kdp1965/ttsky26c-um-lisa-ttlc/docs/debug_uart.txt

           .rx1.    |\                                        +--------------------------------+
  ui_in[3]--------*-+1|                                       |{pt}      Debug Control         |
           .rx2.  | | |                                  .rx. |  +------+  +---------------+   |  Debug
 uio_in[4]------*-|-+2+---------------------------------------|->|      |  |               |   |   Bus
           .rx3.| | | |                                  .tx. |  |      +--+----- FSM  ----+---|----------> 
 uio_in[6]----*-|-|-+3|                +---------------<------|--+      |  |       |       |   |           
              | | | |/        .1.      |                      |  | UART |  |  {cl} |       |   |
              | | |  |Port  +----------|--+''\__________      |  |      |  +-------+-------+   |
              | | |  | Sel  | .2.      *--+__/ uio_out[4]     |  |      |          |  {pr}     |
              V V V  *------*-----)''\ +--+''\__________      |  |      |  +-------+-------+   | Registers 
       +-------------+-+    | .3. )   +---+__/ uio_out[5]  +--|->| {pb} |  |   Registers   +---|----------> 
       | {pt}          |    +-----)__/                     |  |  +---+--+  +---------------+   |  
       |    ^Debug^    | .Baud Set.                        |  |      +-------------------------|----------> 
       |  ^Autobaud^   +-----------------------------------+  +--------------------------------+  Uart 
       +---------------+                                                                       Passthrough
                        <h4>Figure 846.2: Debug Connectivity and Autobaud</h4>

{:FILE scale 0.8 theme light font-size 10}
