kdp1965/ttsky26c-um-lisa-ttlc/harden/placements/macro-fix_final_seq.txt

# 2337 sequential cells: 2115 flops, 222 latches
# 2327 carry an RTL name on their output net, 10 do not (synthetic net name: cannot be matched across runs)
# 0 RTL names are shared by more than one cell
# cells by master: sky130_fd_sc_hd__dfxtp_1 1784, sky130_fd_sc_hd__dfrtp_1 324, sky130_fd_sc_hd__dlrtp_1 222, sky130_fd_sc_hd__dfxtp_2 4, sky130_fd_sc_hd__dfstp_2 3
# rtl_name  kind  master  x_um  y_um  orient  status  instance
FLAG_F  flop  sky130_fd_sc_hd__dfxtp_1  615.020  356.320  R0  PLACED  _33999_
FLAG_O  flop  sky130_fd_sc_hd__dfxtp_1  583.280  353.600  MX  PLACED  _33998_
RR  flop  sky130_fd_sc_hd__dfxtp_1  600.300  372.640  R0  PLACED  _33988_
addr_16b[0]  flop  sky130_fd_sc_hd__dfxtp_1  429.180  378.080  R0  PLACED  _33017_
addr_16b[1]  flop  sky130_fd_sc_hd__dfxtp_1  418.600  380.800  MX  PLACED  _33018_
baud_ref  flop  sky130_fd_sc_hd__dfxtp_1  110.400  476.000  R0  PLACED  _32908_
brg_div[0]  flop  sky130_fd_sc_hd__dfrtp_1  23.000  503.200  R0  PLACED  _32801_
brg_div[1]  flop  sky130_fd_sc_hd__dfrtp_1  16.100  495.040  MX  PLACED  _32802_
brg_div[2]  flop  sky130_fd_sc_hd__dfrtp_1  28.980  505.920  MX  PLACED  _32803_
brg_div[3]  flop  sky130_fd_sc_hd__dfrtp_1  22.540  497.760  R0  PLACED  _32804_
brg_div[4]  flop  sky130_fd_sc_hd__dfrtp_1  23.000  492.320  R0  PLACED  _32805_
brg_div[5]  flop  sky130_fd_sc_hd__dfrtp_1  32.200  481.440  R0  PLACED  _32806_
brg_div[6]  flop  sky130_fd_sc_hd__dfrtp_1  34.040  484.160  MX  PLACED  _32807_
brg_div[7]  flop  sky130_fd_sc_hd__dfrtp_1  42.780  481.440  R0  PLACED  _32808_
brg_wr  flop  sky130_fd_sc_hd__dfrtp_1  67.160  484.160  MX  PLACED  _32800_
cache_addr[1]  flop  sky130_fd_sc_hd__dfxtp_1  523.480  233.920  MX  PLACED  _32711_
cache_addr[2]  flop  sky130_fd_sc_hd__dfxtp_1  537.280  236.640  R0  PLACED  _32712_
cache_addr[3]  flop  sky130_fd_sc_hd__dfxtp_1  528.540  228.480  MX  PLACED  _32713_
cache_disabled  flop  sky130_fd_sc_hd__dfxtp_1  578.680  326.400  MX  PLACED  _32991_
cache_map_sel[0]  flop  sky130_fd_sc_hd__dfxtp_1  549.240  263.840  R0  PLACED  _32992_
cache_map_sel[1]  flop  sky130_fd_sc_hd__dfxtp_1  544.180  320.960  MX  PLACED  _32993_
ce[0]  flop  sky130_fd_sc_hd__dfxtp_1  534.060  405.280  R0  PLACED  _33934_
ce[1]  flop  sky130_fd_sc_hd__dfxtp_1  535.900  402.560  MX  PLACED  _33935_
clk_div[0]  latch  sky130_fd_sc_hd__dlrtp_1  434.700  369.920  MX  PLACED  i_debug_regs.BASE_BITS\[8\].IO_GEN.io_mux_latch
clk_div[1]  latch  sky130_fd_sc_hd__dlrtp_1  435.160  361.760  R0  PLACED  i_debug_regs.BASE_BITS\[9\].IO_GEN.io_mux_latch
core_inst_o[0]  flop  sky130_fd_sc_hd__dfrtp_1  379.960  367.200  R0  PLACED  _32892_
core_inst_o[10]  flop  sky130_fd_sc_hd__dfrtp_1  415.840  291.040  R0  PLACED  _32902_
core_inst_o[11]  flop  sky130_fd_sc_hd__dfrtp_1  405.720  299.200  MX  PLACED  _32903_
core_inst_o[12]  flop  sky130_fd_sc_hd__dfrtp_1  389.620  304.640  MX  PLACED  _32904_
core_inst_o[13]  flop  sky130_fd_sc_hd__dfrtp_1  444.360  291.040  R0  PLACED  _32905_
core_inst_o[14]  flop  sky130_fd_sc_hd__dfrtp_1  426.880  293.760  MX  PLACED  _32906_
core_inst_o[15]  flop  sky130_fd_sc_hd__dfrtp_1  415.840  299.200  MX  PLACED  _32907_
core_inst_o[1]  flop  sky130_fd_sc_hd__dfrtp_1  391.460  364.480  MX  PLACED  _32893_
core_inst_o[2]  flop  sky130_fd_sc_hd__dfrtp_1  396.520  369.920  MX  PLACED  _32894_
core_inst_o[3]  flop  sky130_fd_sc_hd__dfrtp_1  382.260  372.640  R0  PLACED  _32895_
core_inst_o[4]  flop  sky130_fd_sc_hd__dfrtp_1  437.000  296.480  R0  PLACED  _32896_
core_inst_o[5]  flop  sky130_fd_sc_hd__dfrtp_1  400.200  348.160  MX  PLACED  _32897_
core_inst_o[6]  flop  sky130_fd_sc_hd__dfrtp_1  391.920  293.760  MX  PLACED  _32898_
core_inst_o[7]  flop  sky130_fd_sc_hd__dfrtp_1  446.200  288.320  MX  PLACED  _32899_
core_inst_o[8]  flop  sky130_fd_sc_hd__dfrtp_1  395.140  299.200  MX  PLACED  _32900_
core_inst_o[9]  flop  sky130_fd_sc_hd__dfrtp_1  425.960  299.200  MX  PLACED  _32901_
d_addr[0]  flop  sky130_fd_sc_hd__dfxtp_1  343.160  217.600  MX  PLACED  _34349_
d_addr[10]  flop  sky130_fd_sc_hd__dfxtp_1  515.660  231.200  R0  PLACED  _34359_
d_addr[11]  flop  sky130_fd_sc_hd__dfxtp_1  511.060  242.080  R0  PLACED  _34360_
d_addr[12]  flop  sky130_fd_sc_hd__dfxtp_1  506.460  236.640  R0  PLACED  _34361_
d_addr[13]  flop  sky130_fd_sc_hd__dfxtp_1  389.620  255.680  MX  PLACED  _34362_
d_addr[14]  flop  sky130_fd_sc_hd__dfxtp_1  360.640  258.400  R0  PLACED  _34363_
d_addr[1]  flop  sky130_fd_sc_hd__dfxtp_1  353.280  217.600  MX  PLACED  _34350_
d_addr[2]  flop  sky130_fd_sc_hd__dfxtp_1  358.800  220.320  R0  PLACED  _34351_
d_addr[3]  flop  sky130_fd_sc_hd__dfxtp_1  352.360  228.480  MX  PLACED  _34352_
d_addr[4]  flop  sky130_fd_sc_hd__dfxtp_2  350.980  225.760  R0  PLACED  _34353_
d_addr[5]  flop  sky130_fd_sc_hd__dfxtp_1  366.620  225.760  R0  PLACED  _34354_
d_addr[6]  flop  sky130_fd_sc_hd__dfxtp_2  368.460  231.200  R0  PLACED  _34355_
d_addr[7]  flop  sky130_fd_sc_hd__dfxtp_1  609.040  209.440  R0  PLACED  _34356_
d_addr[8]  flop  sky130_fd_sc_hd__dfxtp_1  521.180  228.480  MX  PLACED  _34357_
d_addr[9]  flop  sky130_fd_sc_hd__dfxtp_1  542.340  204.000  R0  PLACED  _34358_
d_o[0]  flop  sky130_fd_sc_hd__dfxtp_1  288.880  367.200  R0  PLACED  _34341_
d_o[1]  flop  sky130_fd_sc_hd__dfxtp_1  286.580  380.800  MX  PLACED  _34342_
d_o[2]  flop  sky130_fd_sc_hd__dfxtp_1  224.940  408.000  MX  PLACED  _34343_
d_o[3]  flop  sky130_fd_sc_hd__dfxtp_2  287.500  361.760  R0  PLACED  _34344_
d_o[4]  flop  sky130_fd_sc_hd__dfxtp_1  213.440  410.720  R0  PLACED  _34345_
d_o[5]  flop  sky130_fd_sc_hd__dfxtp_1  217.580  380.800  MX  PLACED  _34346_
d_o[6]  flop  sky130_fd_sc_hd__dfxtp_1  244.260  408.000  MX  PLACED  _34347_
d_o[7]  flop  sky130_fd_sc_hd__dfxtp_1  260.820  408.000  MX  PLACED  _34348_
d_periph  flop  sky130_fd_sc_hd__dfxtp_1  358.800  269.280  R0  PLACED  _34367_
d_rd  flop  sky130_fd_sc_hd__dfxtp_1  353.740  372.640  R0  PLACED  _34366_
d_valid  flop  sky130_fd_sc_hd__dfxtp_1  543.720  209.440  R0  PLACED  _34364_
d_we  flop  sky130_fd_sc_hd__dfxtp_1  408.480  274.720  R0  PLACED  _34365_
data_cache_flush  flop  sky130_fd_sc_hd__dfxtp_1  552.460  277.440  MX  PLACED  _32994_
data_cache_invalidate  flop  sky130_fd_sc_hd__dfxtp_1  558.440  272.000  MX  PLACED  _32995_
dbg_a[0]  flop  sky130_fd_sc_hd__dfrtp_1  402.500  312.800  R0  PLACED  _32884_
dbg_a[1]  flop  sky130_fd_sc_hd__dfrtp_1  383.180  312.800  R0  PLACED  _32885_
dbg_a[2]  flop  sky130_fd_sc_hd__dfrtp_1  390.080  315.520  MX  PLACED  _32886_
dbg_a[3]  flop  sky130_fd_sc_hd__dfrtp_1  396.060  342.720  MX  PLACED  _32887_
dbg_a[4]  flop  sky130_fd_sc_hd__dfrtp_1  399.740  326.400  MX  PLACED  _32888_
dbg_a[5]  flop  sky130_fd_sc_hd__dfrtp_1  389.620  320.960  MX  PLACED  _32889_
dbg_a[6]  flop  sky130_fd_sc_hd__dfrtp_1  396.980  337.280  MX  PLACED  _32890_
dbg_a[7]  flop  sky130_fd_sc_hd__dfrtp_1  389.160  329.120  R0  PLACED  _32891_
dbg_halted  flop  sky130_fd_sc_hd__dfxtp_1  391.000  285.600  R0  PLACED  _33301_
dbg_rd  flop  sky130_fd_sc_hd__dfrtp_1  398.360  386.240  MX  PLACED  _32867_
dbg_reset  flop  sky130_fd_sc_hd__dfrtp_1  370.300  369.920  MX  PLACED  _32868_
dbg_we  flop  sky130_fd_sc_hd__dfrtp_1  403.420  380.800  MX  PLACED  _32866_
debug_addr[0]  flop  sky130_fd_sc_hd__dfxtp_1  447.120  320.960  MX  PLACED  _32661_
debug_addr[10]  flop  sky130_fd_sc_hd__dfxtp_1  557.060  312.800  R0  PLACED  _32655_
debug_addr[11]  flop  sky130_fd_sc_hd__dfxtp_1  543.720  318.240  R0  PLACED  _32656_
debug_addr[12]  flop  sky130_fd_sc_hd__dfxtp_1  501.400  310.080  MX  PLACED  _32657_
debug_addr[13]  flop  sky130_fd_sc_hd__dfxtp_1  489.900  301.920  R0  PLACED  _32658_
debug_addr[14]  flop  sky130_fd_sc_hd__dfxtp_1  477.480  304.640  MX  PLACED  _32659_
debug_addr[15]  flop  sky130_fd_sc_hd__dfxtp_1  462.760  307.360  R0  PLACED  _32660_
debug_addr[16]  flop  sky130_fd_sc_hd__dfxtp_1  460.460  312.800  R0  PLACED  _32997_
debug_addr[17]  flop  sky130_fd_sc_hd__dfxtp_1  471.040  320.960  MX  PLACED  _32998_
debug_addr[18]  flop  sky130_fd_sc_hd__dfxtp_1  493.120  315.520  MX  PLACED  _32999_
debug_addr[19]  flop  sky130_fd_sc_hd__dfxtp_1  509.220  304.640  MX  PLACED  _33000_
debug_addr[1]  flop  sky130_fd_sc_hd__dfxtp_1  478.860  288.320  MX  PLACED  _32646_
debug_addr[20]  flop  sky130_fd_sc_hd__dfxtp_1  509.680  310.080  MX  PLACED  _33001_
debug_addr[21]  flop  sky130_fd_sc_hd__dfxtp_1  534.520  318.240  R0  PLACED  _33002_
debug_addr[22]  flop  sky130_fd_sc_hd__dfxtp_1  522.560  312.800  R0  PLACED  _33003_
debug_addr[23]  flop  sky130_fd_sc_hd__dfxtp_1  515.200  301.920  R0  PLACED  _33004_
debug_addr[2]  flop  sky130_fd_sc_hd__dfxtp_1  484.840  299.200  MX  PLACED  _32647_
debug_addr[3]  flop  sky130_fd_sc_hd__dfxtp_1  507.380  296.480  R0  PLACED  _32648_
debug_addr[4]  flop  sky130_fd_sc_hd__dfxtp_1  518.880  299.200  MX  PLACED  _32649_
debug_addr[5]  flop  sky130_fd_sc_hd__dfxtp_1  519.340  291.040  R0  PLACED  _32650_
debug_addr[6]  flop  sky130_fd_sc_hd__dfxtp_1  542.800  280.160  R0  PLACED  _32651_
debug_addr[7]  flop  sky130_fd_sc_hd__dfxtp_1  532.680  291.040  R0  PLACED  _32652_
debug_addr[8]  flop  sky130_fd_sc_hd__dfxtp_1  528.540  293.760  MX  PLACED  _32653_
debug_addr[9]  flop  sky130_fd_sc_hd__dfxtp_1  560.280  307.360  R0  PLACED  _32654_
debug_ce_ctrl[0]  flop  sky130_fd_sc_hd__dfxtp_1  436.080  350.880  R0  PLACED  _33005_
debug_ce_ctrl[1]  flop  sky130_fd_sc_hd__dfxtp_1  435.160  345.440  R0  PLACED  _33006_
debug_tx  flop  sky130_fd_sc_hd__dfxtp_1  166.520  429.760  MX  PLACED  _32961_
dummy_read_cycles[0]  flop  sky130_fd_sc_hd__dfxtp_1  458.620  391.680  MX  PLACED  _33023_
dummy_read_cycles[1]  flop  sky130_fd_sc_hd__dfxtp_1  460.920  383.520  R0  PLACED  _33024_
dummy_read_cycles[2]  flop  sky130_fd_sc_hd__dfxtp_1  534.980  367.200  R0  PLACED  _33025_
dummy_read_cycles[3]  flop  sky130_fd_sc_hd__dfxtp_1  456.320  380.800  MX  PLACED  _33026_
dummy_read_cycles[4]  flop  sky130_fd_sc_hd__dfxtp_1  449.420  386.240  MX  PLACED  _33027_
dummy_read_cycles[5]  flop  sky130_fd_sc_hd__dfxtp_1  467.820  380.800  MX  PLACED  _33028_
dummy_read_cycles[6]  flop  sky130_fd_sc_hd__dfxtp_1  519.800  367.200  R0  PLACED  _33029_
dummy_read_cycles[7]  flop  sky130_fd_sc_hd__dfxtp_1  458.160  375.360  MX  PLACED  _33030_
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
i_data_cache.cl_valid[3]  flop  sky130_fd_sc_hd__dfxtp_1  629.280  190.400  MX  PLACED  _32754_
i_data_cache.cl_valid[4]  flop  sky130_fd_sc_hd__dfxtp_1  626.520  171.360  R0  PLACED  _32753_
i_data_cache.cl_valid[5]  flop  sky130_fd_sc_hd__dfxtp_1  598.920  176.800  R0  PLACED  _32752_
i_data_cache.cl_valid[6]  flop  sky130_fd_sc_hd__dfxtp_1  626.060  163.200  MX  PLACED  _32751_
i_data_cache.cl_valid[7]  flop  sky130_fd_sc_hd__dfxtp_1  568.560  165.920  R0  PLACED  _32750_
i_data_cache.flush_active  flop  sky130_fd_sc_hd__dfxtp_1  574.540  220.320  R0  PLACED  _32714_
i_data_cache.flush_cache_line[0]  flop  sky130_fd_sc_hd__dfxtp_1  579.600  212.160  MX  PLACED  _32715_
i_data_cache.flush_cache_line[1]  flop  sky130_fd_sc_hd__dfxtp_1  582.820  209.440  R0  PLACED  _32716_
i_data_cache.flush_cache_line[2]  flop  sky130_fd_sc_hd__dfxtp_1  564.420  209.440  R0  PLACED  _32717_
i_data_cache.load_active  flop  sky130_fd_sc_hd__dfxtp_1  547.400  223.040  MX  PLACED  _32710_
i_data_cache.qspi_ready_ack  flop  sky130_fd_sc_hd__dfxtp_1  549.240  236.640  R0  PLACED  _34429_
i_data_cache.rst_n  flop  sky130_fd_sc_hd__dfrtp_1  644.920  503.200  R0  PLACED  _34437_
i_data_cache.save_active  flop  sky130_fd_sc_hd__dfxtp_1  536.360  225.760  R0  PLACED  _32709_
i_data_cache.state[0]  flop  sky130_fd_sc_hd__dfxtp_1  552.460  212.160  MX  PLACED  _34421_
i_data_cache.state[1]  flop  sky130_fd_sc_hd__dfxtp_1  551.080  217.600  MX  PLACED  _34422_
i_data_cache.state[2]  flop  sky130_fd_sc_hd__dfxtp_1  572.700  225.760  R0  PLACED  _34423_
i_data_cache.state[3]  flop  sky130_fd_sc_hd__dfxtp_1  570.400  233.920  MX  PLACED  _34424_
i_data_cache.state[4]  flop  sky130_fd_sc_hd__dfxtp_1  557.520  236.640  R0  PLACED  _34425_
i_data_cache.state[5]  flop  sky130_fd_sc_hd__dfxtp_1  565.340  225.760  R0  PLACED  _34426_
i_data_cache.state[6]  flop  sky130_fd_sc_hd__dfxtp_1  567.180  220.320  R0  PLACED  _34427_
i_data_cache.state[7]  flop  sky130_fd_sc_hd__dfxtp_1  559.820  231.200  R0  PLACED  _34428_
i_data_cache.state[9]  flop  sky130_fd_sc_hd__dfxtp_1  544.640  212.160  MX  PLACED  _34430_
i_debug_autobaud.rx1  flop  sky130_fd_sc_hd__dfrtp_1  87.400  462.400  MX  PLACED  _34432_
i_debug_autobaud.rx2  flop  sky130_fd_sc_hd__dfrtp_1  101.200  476.000  R0  PLACED  _34434_
i_debug_autobaud.rx3  flop  sky130_fd_sc_hd__dfrtp_1  107.180  470.560  R0  PLACED  _34436_
i_debug_autobaud.rx_sel[0]  flop  sky130_fd_sc_hd__dfrtp_1  91.080  467.840  MX  PLACED  _32798_
i_debug_autobaud.rx_sel[1]  flop  sky130_fd_sc_hd__dfrtp_1  97.520  465.120  R0  PLACED  _32799_
i_debug_autobaud.s_bit_div2[0]  flop  sky130_fd_sc_hd__dfrtp_1  32.200  500.480  MX  PLACED  _32809_
i_debug_autobaud.s_bit_div2[1]  flop  sky130_fd_sc_hd__dfrtp_1  30.820  489.600  MX  PLACED  _32810_
i_debug_autobaud.s_bit_div2[2]  flop  sky130_fd_sc_hd__dfrtp_1  53.820  503.200  R0  PLACED  _32811_
i_debug_autobaud.s_bit_div2[3]  flop  sky130_fd_sc_hd__dfrtp_1  54.280  497.760  R0  PLACED  _32812_
i_debug_autobaud.s_bit_div2[4]  flop  sky130_fd_sc_hd__dfrtp_1  57.960  492.320  R0  PLACED  _32813_
i_debug_autobaud.s_bit_div2[5]  flop  sky130_fd_sc_hd__dfrtp_1  51.980  481.440  R0  PLACED  _32814_
i_debug_autobaud.s_bit_div2[6]  flop  sky130_fd_sc_hd__dfrtp_1  43.700  486.880  R0  PLACED  _32815_
i_debug_autobaud.s_bit_div2[7]  flop  sky130_fd_sc_hd__dfrtp_1  44.160  500.480  MX  PLACED  _32816_
i_debug_autobaud.s_bit_div3[0]  flop  sky130_fd_sc_hd__dfrtp_1  32.200  503.200  R0  PLACED  _32817_
i_debug_autobaud.s_bit_div3[1]  flop  sky130_fd_sc_hd__dfrtp_1  32.200  492.320  R0  PLACED  _32818_
i_debug_autobaud.s_bit_div3[2]  flop  sky130_fd_sc_hd__dfrtp_1  67.620  503.200  R0  PLACED  _32819_
i_debug_autobaud.s_bit_div3[3]  flop  sky130_fd_sc_hd__dfrtp_1  60.720  500.480  MX  PLACED  _32820_
i_debug_autobaud.s_bit_div3[4]  flop  sky130_fd_sc_hd__dfrtp_1  63.940  489.600  MX  PLACED  _32821_
i_debug_autobaud.s_bit_div3[5]  flop  sky130_fd_sc_hd__dfrtp_1  57.040  484.160  MX  PLACED  _32822_
i_debug_autobaud.s_bit_div3[6]  flop  sky130_fd_sc_hd__dfrtp_1  41.860  492.320  R0  PLACED  _32823_
i_debug_autobaud.s_bit_div3[7]  flop  sky130_fd_sc_hd__dfrtp_1  43.700  503.200  R0  PLACED  _32824_
i_debug_autobaud.s_div_found  flop  sky130_fd_sc_hd__dfrtp_1  73.600  481.440  R0  PLACED  _34544_
i_debug_autobaud.s_done  flop  sky130_fd_sc_hd__dfrtp_1  63.940  473.280  MX  PLACED  _32830_
i_debug_autobaud.s_last_rx1  flop  sky130_fd_sc_hd__dfrtp_1  76.820  465.120  R0  PLACED  _32825_
i_debug_autobaud.s_last_rx2  flop  sky130_fd_sc_hd__dfrtp_1  67.620  465.120  R0  PLACED  _32826_
i_debug_autobaud.s_last_rx3  flop  sky130_fd_sc_hd__dfrtp_1  60.720  467.840  MX  PLACED  _32827_
i_debug_autobaud.s_pulse_width[0]  flop  sky130_fd_sc_hd__dfrtp_1  4.140  470.560  R0  PLACED  _32627_
i_debug_autobaud.s_pulse_width[10]  flop  sky130_fd_sc_hd__dfrtp_1  25.760  486.880  R0  PLACED  _32637_
i_debug_autobaud.s_pulse_width[11]  flop  sky130_fd_sc_hd__dfrtp_1  25.300  476.000  R0  PLACED  _32638_
i_debug_autobaud.s_pulse_width[12]  flop  sky130_fd_sc_hd__dfrtp_1  38.180  478.720  MX  PLACED  _32639_
i_debug_autobaud.s_pulse_width[13]  flop  sky130_fd_sc_hd__dfrtp_1  50.140  476.000  R0  PLACED  _32640_
i_debug_autobaud.s_pulse_width[1]  flop  sky130_fd_sc_hd__dfrtp_1  4.600  476.000  R0  PLACED  _32628_
i_debug_autobaud.s_pulse_width[2]  flop  sky130_fd_sc_hd__dfrtp_1  16.100  476.000  R0  PLACED  _32629_
i_debug_autobaud.s_pulse_width[3]  flop  sky130_fd_sc_hd__dfrtp_1  15.180  484.160  MX  PLACED  _32630_
i_debug_autobaud.s_pulse_width[4]  flop  sky130_fd_sc_hd__dfrtp_1  4.140  484.160  MX  PLACED  _32631_
i_debug_autobaud.s_pulse_width[5]  flop  sky130_fd_sc_hd__dfrtp_1  6.440  500.480  MX  PLACED  _32632_
i_debug_autobaud.s_pulse_width[6]  flop  sky130_fd_sc_hd__dfrtp_1  6.440  497.760  R0  PLACED  _32633_
i_debug_autobaud.s_pulse_width[7]  flop  sky130_fd_sc_hd__dfrtp_1  17.480  500.480  MX  PLACED  _32634_
i_debug_autobaud.s_pulse_width[8]  flop  sky130_fd_sc_hd__dfrtp_1  4.140  492.320  R0  PLACED  _32635_
i_debug_autobaud.s_pulse_width[9]  flop  sky130_fd_sc_hd__dfrtp_1  15.180  489.600  MX  PLACED  _32636_
i_debug_autobaud.s_rx_sel[0]  flop  sky130_fd_sc_hd__dfrtp_1  83.720  470.560  R0  PLACED  _32828_
i_debug_autobaud.s_rx_sel[1]  flop  sky130_fd_sc_hd__dfrtp_1  86.940  473.280  MX  PLACED  _32829_
i_debug_ctrl.i_debug_brg.s_baud_cnt[0]  flop  sky130_fd_sc_hd__dfxtp_1  93.380  503.200  R0  PLACED  _32909_
i_debug_ctrl.i_debug_brg.s_baud_cnt[1]  flop  sky130_fd_sc_hd__dfxtp_1  108.100  503.200  R0  PLACED  _32910_
i_debug_ctrl.i_debug_brg.s_baud_cnt[2]  flop  sky130_fd_sc_hd__dfxtp_1  100.740  503.200  R0  PLACED  _32911_
i_debug_ctrl.i_debug_brg.s_baud_cnt[3]  flop  sky130_fd_sc_hd__dfxtp_1  103.040  492.320  R0  PLACED  _32912_
i_debug_ctrl.i_debug_brg.s_baud_cnt[4]  flop  sky130_fd_sc_hd__dfxtp_1  107.180  489.600  MX  PLACED  _32913_
i_debug_ctrl.i_debug_brg.s_baud_cnt[5]  flop  sky130_fd_sc_hd__dfxtp_1  100.740  486.880  R0  PLACED  _32914_
i_debug_ctrl.i_debug_brg.s_baud_cnt[6]  flop  sky130_fd_sc_hd__dfxtp_1  108.560  481.440  R0  PLACED  _32915_
i_debug_ctrl.i_debug_brg.s_baud_cnt[7]  flop  sky130_fd_sc_hd__dfxtp_1  97.980  481.440  R0  PLACED  _32916_
i_debug_ctrl.i_debug_brg.s_baud_preload[0]  flop  sky130_fd_sc_hd__dfxtp_1  85.560  503.200  R0  PLACED  _32917_
i_debug_ctrl.i_debug_brg.s_baud_preload[1]  flop  sky130_fd_sc_hd__dfxtp_1  93.380  497.760  R0  PLACED  _32918_
i_debug_ctrl.i_debug_brg.s_baud_preload[2]  flop  sky130_fd_sc_hd__dfxtp_1  78.200  503.200  R0  PLACED  _32919_
i_debug_ctrl.i_debug_brg.s_baud_preload[3]  flop  sky130_fd_sc_hd__dfxtp_1  81.420  495.040  MX  PLACED  _32920_
i_debug_ctrl.i_debug_brg.s_baud_preload[4]  flop  sky130_fd_sc_hd__dfxtp_1  93.840  492.320  R0  PLACED  _32921_
i_debug_ctrl.i_debug_brg.s_baud_preload[5]  flop  sky130_fd_sc_hd__dfxtp_1  86.020  484.160  MX  PLACED  _32922_
i_debug_ctrl.i_debug_brg.s_baud_preload[6]  flop  sky130_fd_sc_hd__dfxtp_1  93.380  484.160  MX  PLACED  _32923_
i_debug_ctrl.i_debug_brg.s_baud_preload[7]  flop  sky130_fd_sc_hd__dfxtp_1  82.340  478.720  MX  PLACED  _32924_
i_debug_ctrl.i_debug_brg.s_wr_edge  flop  sky130_fd_sc_hd__dfxtp_1  74.520  486.880  R0  PLACED  _32925_
i_debug_ctrl.i_lisa_rx8n.bit_count[0]  flop  sky130_fd_sc_hd__dfxtp_1  11.960  467.840  MX  PLACED  _32927_
i_debug_ctrl.i_lisa_rx8n.bit_count[1]  flop  sky130_fd_sc_hd__dfxtp_1  20.700  473.280  MX  PLACED  _32928_
i_debug_ctrl.i_lisa_rx8n.bit_count[2]  flop  sky130_fd_sc_hd__dfxtp_1  30.360  470.560  R0  PLACED  _32929_
i_debug_ctrl.i_lisa_rx8n.bit_count[3]  flop  sky130_fd_sc_hd__dfxtp_1  52.440  470.560  R0  PLACED  _32930_
i_debug_ctrl.i_lisa_rx8n.bit_count[4]  flop  sky130_fd_sc_hd__dfxtp_1  43.240  473.280  MX  PLACED  _32931_
i_debug_ctrl.i_lisa_rx8n.bit_count[5]  flop  sky130_fd_sc_hd__dfxtp_1  28.980  462.400  MX  PLACED  _32932_
i_debug_ctrl.i_lisa_rx8n.bit_count[6]  flop  sky130_fd_sc_hd__dfxtp_1  19.780  465.120  R0  PLACED  _32933_
i_debug_ctrl.i_lisa_rx8n.bit_count[7]  flop  sky130_fd_sc_hd__dfxtp_1  37.260  462.400  MX  PLACED  _32934_
i_debug_ctrl.i_lisa_rx8n.fifo[0][0]  flop  sky130_fd_sc_hd__dfxtp_1  41.860  416.160  R0  PLACED  _32476_
i_debug_ctrl.i_lisa_rx8n.fifo[0][1]  flop  sky130_fd_sc_hd__dfxtp_1  16.560  410.720  R0  PLACED  _32477_
i_debug_ctrl.i_lisa_rx8n.fifo[0][2]  flop  sky130_fd_sc_hd__dfxtp_1  16.560  421.600  R0  PLACED  _32478_
i_debug_ctrl.i_lisa_rx8n.fifo[0][3]  flop  sky130_fd_sc_hd__dfxtp_1  18.400  443.360  R0  PLACED  _32479_
i_debug_ctrl.i_lisa_rx8n.fifo[0][4]  flop  sky130_fd_sc_hd__dfxtp_1  46.000  421.600  R0  PLACED  _32480_
i_debug_ctrl.i_lisa_rx8n.fifo[0][5]  flop  sky130_fd_sc_hd__dfxtp_1  43.700  446.080  MX  PLACED  _32481_
i_debug_ctrl.i_lisa_rx8n.fifo[0][6]  flop  sky130_fd_sc_hd__dfxtp_1  54.740  440.640  MX  PLACED  _32482_
i_debug_ctrl.i_lisa_rx8n.fifo[0][7]  flop  sky130_fd_sc_hd__dfxtp_1  69.000  446.080  MX  PLACED  _32483_
i_debug_ctrl.i_lisa_rx8n.fifo[1][0]  flop  sky130_fd_sc_hd__dfxtp_1  33.580  413.440  MX  PLACED  _32484_
i_debug_ctrl.i_lisa_rx8n.fifo[1][1]  flop  sky130_fd_sc_hd__dfxtp_1  16.100  416.160  R0  PLACED  _32485_
i_debug_ctrl.i_lisa_rx8n.fifo[1][2]  flop  sky130_fd_sc_hd__dfxtp_1  13.800  424.320  MX  PLACED  _32486_
i_debug_ctrl.i_lisa_rx8n.fifo[1][3]  flop  sky130_fd_sc_hd__dfxtp_1  13.340  451.520  MX  PLACED  _32487_
i_debug_ctrl.i_lisa_rx8n.fifo[1][4]  flop  sky130_fd_sc_hd__dfxtp_1  38.640  418.880  MX  PLACED  _32488_
i_debug_ctrl.i_lisa_rx8n.fifo[1][5]  flop  sky130_fd_sc_hd__dfxtp_1  34.040  443.360  R0  PLACED  _32489_
i_debug_ctrl.i_lisa_rx8n.fifo[1][6]  flop  sky130_fd_sc_hd__dfxtp_1  52.440  448.800  R0  PLACED  _32490_
i_debug_ctrl.i_lisa_rx8n.fifo[1][7]  flop  sky130_fd_sc_hd__dfxtp_1  67.620  448.800  R0  PLACED  _32491_
i_debug_ctrl.i_lisa_rx8n.fifo[2][0]  flop  sky130_fd_sc_hd__dfxtp_1  25.760  416.160  R0  PLACED  _32492_
i_debug_ctrl.i_lisa_rx8n.fifo[2][1]  flop  sky130_fd_sc_hd__dfxtp_1  4.600  410.720  R0  PLACED  _32493_
i_debug_ctrl.i_lisa_rx8n.fifo[2][2]  flop  sky130_fd_sc_hd__dfxtp_1  5.060  421.600  R0  PLACED  _32494_
i_debug_ctrl.i_lisa_rx8n.fifo[2][3]  flop  sky130_fd_sc_hd__dfxtp_1  4.600  443.360  R0  PLACED  _32495_
i_debug_ctrl.i_lisa_rx8n.fifo[2][4]  flop  sky130_fd_sc_hd__dfxtp_1  32.660  424.320  MX  PLACED  _32496_
i_debug_ctrl.i_lisa_rx8n.fifo[2][5]  flop  sky130_fd_sc_hd__dfxtp_1  27.140  448.800  R0  PLACED  _32497_
i_debug_ctrl.i_lisa_rx8n.fifo[2][6]  flop  sky130_fd_sc_hd__dfxtp_1  46.920  440.640  MX  PLACED  _32498_
i_debug_ctrl.i_lisa_rx8n.fifo[2][7]  flop  sky130_fd_sc_hd__dfxtp_1  60.260  446.080  MX  PLACED  _32499_
i_debug_ctrl.i_lisa_rx8n.fifo[3][0]  flop  sky130_fd_sc_hd__dfxtp_1  28.980  418.880  MX  PLACED  _32500_
i_debug_ctrl.i_lisa_rx8n.fifo[3][1]  flop  sky130_fd_sc_hd__dfxtp_1  4.600  416.160  R0  PLACED  _32501_
i_debug_ctrl.i_lisa_rx8n.fifo[3][2]  flop  sky130_fd_sc_hd__dfxtp_1  5.060  418.880  MX  PLACED  _32502_
i_debug_ctrl.i_lisa_rx8n.fifo[3][3]  flop  sky130_fd_sc_hd__dfxtp_1  5.520  446.080  MX  PLACED  _32503_
i_debug_ctrl.i_lisa_rx8n.fifo[3][4]  flop  sky130_fd_sc_hd__dfxtp_1  28.060  427.040  R0  PLACED  _32504_
i_debug_ctrl.i_lisa_rx8n.fifo[3][5]  flop  sky130_fd_sc_hd__dfxtp_1  26.680  454.240  R0  PLACED  _32505_
i_debug_ctrl.i_lisa_rx8n.fifo[3][6]  flop  sky130_fd_sc_hd__dfxtp_1  45.080  448.800  R0  PLACED  _32506_
i_debug_ctrl.i_lisa_rx8n.fifo[3][7]  flop  sky130_fd_sc_hd__dfxtp_1  59.800  448.800  R0  PLACED  _32507_
i_debug_ctrl.i_lisa_rx8n.fifo[4][0]  flop  sky130_fd_sc_hd__dfxtp_1  37.720  402.560  MX  PLACED  _32508_
i_debug_ctrl.i_lisa_rx8n.fifo[4][1]  flop  sky130_fd_sc_hd__dfxtp_1  16.100  402.560  MX  PLACED  _32509_
i_debug_ctrl.i_lisa_rx8n.fifo[4][2]  flop  sky130_fd_sc_hd__dfxtp_1  19.320  427.040  R0  PLACED  _32510_
i_debug_ctrl.i_lisa_rx8n.fifo[4][3]  flop  sky130_fd_sc_hd__dfxtp_1  17.940  440.640  MX  PLACED  _32511_
i_debug_ctrl.i_lisa_rx8n.fifo[4][4]  flop  sky130_fd_sc_hd__dfxtp_1  46.920  427.040  R0  PLACED  _32512_
i_debug_ctrl.i_lisa_rx8n.fifo[4][5]  flop  sky130_fd_sc_hd__dfxtp_1  43.240  437.920  R0  PLACED  _32513_
i_debug_ctrl.i_lisa_rx8n.fifo[4][6]  flop  sky130_fd_sc_hd__dfxtp_1  71.760  432.480  R0  PLACED  _32514_
i_debug_ctrl.i_lisa_rx8n.fifo[4][7]  flop  sky130_fd_sc_hd__dfxtp_1  70.380  427.040  R0  PLACED  _32515_
i_debug_ctrl.i_lisa_rx8n.fifo[5][0]  flop  sky130_fd_sc_hd__dfxtp_1  34.040  405.280  R0  PLACED  _32516_
i_debug_ctrl.i_lisa_rx8n.fifo[5][1]  flop  sky130_fd_sc_hd__dfxtp_1  8.740  402.560  MX  PLACED  _32517_
i_debug_ctrl.i_lisa_rx8n.fifo[5][2]  flop  sky130_fd_sc_hd__dfxtp_1  16.100  432.480  R0  PLACED  _32518_
i_debug_ctrl.i_lisa_rx8n.fifo[5][3]  flop  sky130_fd_sc_hd__dfxtp_1  8.280  437.920  R0  PLACED  _32519_
i_debug_ctrl.i_lisa_rx8n.fifo[5][4]  flop  sky130_fd_sc_hd__dfxtp_1  38.180  435.200  MX  PLACED  _32520_
i_debug_ctrl.i_lisa_rx8n.fifo[5][5]  flop  sky130_fd_sc_hd__dfxtp_1  34.960  440.640  MX  PLACED  _32521_
i_debug_ctrl.i_lisa_rx8n.fifo[5][6]  flop  sky130_fd_sc_hd__dfxtp_1  64.860  440.640  MX  PLACED  _32522_
i_debug_ctrl.i_lisa_rx8n.fifo[5][7]  flop  sky130_fd_sc_hd__dfxtp_1  67.160  424.320  MX  PLACED  _32523_
i_debug_ctrl.i_lisa_rx8n.fifo[6][0]  flop  sky130_fd_sc_hd__dfxtp_1  25.760  410.720  R0  PLACED  _32524_
i_debug_ctrl.i_lisa_rx8n.fifo[6][1]  flop  sky130_fd_sc_hd__dfxtp_1  4.140  408.000  MX  PLACED  _32525_
i_debug_ctrl.i_lisa_rx8n.fifo[6][2]  flop  sky130_fd_sc_hd__dfxtp_1  4.140  427.040  R0  PLACED  _32526_
i_debug_ctrl.i_lisa_rx8n.fifo[6][3]  flop  sky130_fd_sc_hd__dfxtp_1  4.600  440.640  MX  PLACED  _32527_
i_debug_ctrl.i_lisa_rx8n.fifo[6][4]  flop  sky130_fd_sc_hd__dfxtp_1  27.600  432.480  R0  PLACED  _32528_
i_debug_ctrl.i_lisa_rx8n.fifo[6][5]  flop  sky130_fd_sc_hd__dfxtp_1  26.680  443.360  R0  PLACED  _32529_
i_debug_ctrl.i_lisa_rx8n.fifo[6][6]  flop  sky130_fd_sc_hd__dfxtp_1  57.960  435.200  MX  PLACED  _32530_
i_debug_ctrl.i_lisa_rx8n.fifo[6][7]  flop  sky130_fd_sc_hd__dfxtp_1  57.500  429.760  MX  PLACED  _32531_
i_debug_ctrl.i_lisa_rx8n.fifo[7][0]  flop  sky130_fd_sc_hd__dfxtp_1  25.300  405.280  R0  PLACED  _32532_
i_debug_ctrl.i_lisa_rx8n.fifo[7][1]  flop  sky130_fd_sc_hd__dfxtp_1  4.600  405.280  R0  PLACED  _32533_
i_debug_ctrl.i_lisa_rx8n.fifo[7][2]  flop  sky130_fd_sc_hd__dfxtp_1  6.440  429.760  MX  PLACED  _32534_
i_debug_ctrl.i_lisa_rx8n.fifo[7][3]  flop  sky130_fd_sc_hd__dfxtp_1  5.060  435.200  MX  PLACED  _32535_
i_debug_ctrl.i_lisa_rx8n.fifo[7][4]  flop  sky130_fd_sc_hd__dfxtp_1  31.280  429.760  MX  PLACED  _32536_
i_debug_ctrl.i_lisa_rx8n.fifo[7][5]  flop  sky130_fd_sc_hd__dfxtp_1  28.980  435.200  MX  PLACED  _32537_
i_debug_ctrl.i_lisa_rx8n.fifo[7][6]  flop  sky130_fd_sc_hd__dfxtp_1  52.440  432.480  R0  PLACED  _32538_
i_debug_ctrl.i_lisa_rx8n.fifo[7][7]  flop  sky130_fd_sc_hd__dfxtp_1  54.280  427.040  R0  PLACED  _32539_
i_debug_ctrl.i_lisa_rx8n.push  flop  sky130_fd_sc_hd__dfxtp_1  67.620  454.240  R0  PLACED  _32926_
i_debug_ctrl.i_lisa_rx8n.rd  flop  sky130_fd_sc_hd__dfrtp_1  345.920  397.120  MX  PLACED  _32864_
i_debug_ctrl.i_lisa_rx8n.rd_ptr[0]  flop  sky130_fd_sc_hd__dfxtp_1  70.380  405.280  R0  PLACED  _32957_
i_debug_ctrl.i_lisa_rx8n.rd_ptr[1]  flop  sky130_fd_sc_hd__dfxtp_1  69.920  410.720  R0  PLACED  _32958_
i_debug_ctrl.i_lisa_rx8n.rd_ptr[2]  flop  sky130_fd_sc_hd__dfxtp_1  46.920  408.000  MX  PLACED  _32959_
i_debug_ctrl.i_lisa_rx8n.rd_ptr[3]  flop  sky130_fd_sc_hd__dfxtp_1  55.660  408.000  MX  PLACED  _32960_
i_debug_ctrl.i_lisa_rx8n.rx_byte[0]  flop  sky130_fd_sc_hd__dfxtp_1  21.160  451.520  MX  PLACED  _32944_
i_debug_ctrl.i_lisa_rx8n.rx_byte[1]  flop  sky130_fd_sc_hd__dfxtp_1  17.020  448.800  R0  PLACED  _32945_
i_debug_ctrl.i_lisa_rx8n.rx_byte[2]  flop  sky130_fd_sc_hd__dfxtp_1  4.140  448.800  R0  PLACED  _32946_
i_debug_ctrl.i_lisa_rx8n.rx_byte[3]  flop  sky130_fd_sc_hd__dfxtp_1  5.980  451.520  MX  PLACED  _32947_
i_debug_ctrl.i_lisa_rx8n.rx_byte[4]  flop  sky130_fd_sc_hd__dfxtp_1  34.040  454.240  R0  PLACED  _32948_
i_debug_ctrl.i_lisa_rx8n.rx_byte[5]  flop  sky130_fd_sc_hd__dfxtp_1  34.960  451.520  MX  PLACED  _32949_
i_debug_ctrl.i_lisa_rx8n.rx_byte[6]  flop  sky130_fd_sc_hd__dfxtp_1  58.880  454.240  R0  PLACED  _32950_
i_debug_ctrl.i_lisa_rx8n.rx_byte[7]  flop  sky130_fd_sc_hd__dfxtp_1  62.560  456.960  MX  PLACED  _32951_
i_debug_ctrl.i_lisa_rx8n.s_baud_edge  flop  sky130_fd_sc_hd__dfxtp_1  109.020  465.120  R0  PLACED  _32990_
i_debug_ctrl.i_lisa_rx8n.s_last_rd  flop  sky130_fd_sc_hd__dfxtp_1  74.060  399.840  R0  PLACED  _32956_
i_debug_ctrl.i_lisa_rx8n.s_rxd  flop  sky130_fd_sc_hd__dfxtp_1  67.160  462.400  MX  PLACED  _32943_
i_debug_ctrl.i_lisa_rx8n.shift[0]  flop  sky130_fd_sc_hd__dfxtp_1  19.320  459.680  R0  PLACED  _32936_
i_debug_ctrl.i_lisa_rx8n.shift[1]  flop  sky130_fd_sc_hd__dfxtp_1  7.360  456.960  MX  PLACED  _32937_
i_debug_ctrl.i_lisa_rx8n.shift[2]  flop  sky130_fd_sc_hd__dfxtp_1  4.140  459.680  R0  PLACED  _32938_
i_debug_ctrl.i_lisa_rx8n.shift[3]  flop  sky130_fd_sc_hd__dfxtp_1  8.280  462.400  MX  PLACED  _32939_
i_debug_ctrl.i_lisa_rx8n.shift[4]  flop  sky130_fd_sc_hd__dfxtp_1  29.440  456.960  MX  PLACED  _32940_
i_debug_ctrl.i_lisa_rx8n.shift[5]  flop  sky130_fd_sc_hd__dfxtp_1  42.320  454.240  R0  PLACED  _32941_
i_debug_ctrl.i_lisa_rx8n.shift[6]  flop  sky130_fd_sc_hd__dfxtp_1  51.520  454.240  R0  PLACED  _32942_
i_debug_ctrl.i_lisa_rx8n.shift[7]  flop  sky130_fd_sc_hd__dfxtp_1  59.800  462.400  MX  PLACED  _32935_
i_debug_ctrl.i_lisa_rx8n.wr_ptr[0]  flop  sky130_fd_sc_hd__dfxtp_1  72.680  421.600  R0  PLACED  _32952_
i_debug_ctrl.i_lisa_rx8n.wr_ptr[1]  flop  sky130_fd_sc_hd__dfxtp_1  80.040  421.600  R0  PLACED  _32953_
i_debug_ctrl.i_lisa_rx8n.wr_ptr[2]  flop  sky130_fd_sc_hd__dfxtp_1  54.740  421.600  R0  PLACED  _32954_
i_debug_ctrl.i_lisa_rx8n.wr_ptr[3]  flop  sky130_fd_sc_hd__dfxtp_1  50.600  416.160  R0  PLACED  _32955_
i_debug_ctrl.i_lisa_tx8n.bit_count[0]  flop  sky130_fd_sc_hd__dfxtp_1  149.960  424.320  MX  PLACED  _32962_
i_debug_ctrl.i_lisa_tx8n.bit_count[1]  flop  sky130_fd_sc_hd__dfxtp_1  139.380  424.320  MX  PLACED  _32963_
i_debug_ctrl.i_lisa_tx8n.bit_count[2]  flop  sky130_fd_sc_hd__dfxtp_1  161.460  424.320  MX  PLACED  _32964_
i_debug_ctrl.i_lisa_tx8n.clock_count[0]  flop  sky130_fd_sc_hd__dfxtp_1  121.900  432.480  R0  PLACED  _32986_
i_debug_ctrl.i_lisa_tx8n.clock_count[1]  flop  sky130_fd_sc_hd__dfxtp_1  129.720  432.480  R0  PLACED  _32987_
i_debug_ctrl.i_lisa_tx8n.clock_count[2]  flop  sky130_fd_sc_hd__dfxtp_1  139.840  429.760  MX  PLACED  _32988_
i_debug_ctrl.i_lisa_tx8n.clock_count[3]  flop  sky130_fd_sc_hd__dfxtp_1  141.680  440.640  MX  PLACED  _32989_
i_debug_ctrl.i_lisa_tx8n.dbuf[0]  flop  sky130_fd_sc_hd__dfxtp_1  212.520  418.880  MX  PLACED  _32977_
i_debug_ctrl.i_lisa_tx8n.dbuf[1]  flop  sky130_fd_sc_hd__dfxtp_1  222.180  410.720  R0  PLACED  _32978_
i_debug_ctrl.i_lisa_tx8n.dbuf[2]  flop  sky130_fd_sc_hd__dfxtp_1  235.060  413.440  MX  PLACED  _32979_
i_debug_ctrl.i_lisa_tx8n.dbuf[3]  flop  sky130_fd_sc_hd__dfxtp_1  250.700  413.440  MX  PLACED  _32980_
i_debug_ctrl.i_lisa_tx8n.dbuf[4]  flop  sky130_fd_sc_hd__dfxtp_1  253.000  418.880  MX  PLACED  _32981_
i_debug_ctrl.i_lisa_tx8n.dbuf[5]  flop  sky130_fd_sc_hd__dfxtp_1  261.740  416.160  R0  PLACED  _32982_
i_debug_ctrl.i_lisa_tx8n.dbuf[6]  flop  sky130_fd_sc_hd__dfxtp_1  226.780  424.320  MX  PLACED  _32983_
i_debug_ctrl.i_lisa_tx8n.dbuf[7]  flop  sky130_fd_sc_hd__dfxtp_1  207.000  427.040  R0  PLACED  _32984_
i_debug_ctrl.i_lisa_tx8n.mode[0]  flop  sky130_fd_sc_hd__dfxtp_1  149.960  432.480  R0  PLACED  _34417_
i_debug_ctrl.i_lisa_tx8n.mode[1]  flop  sky130_fd_sc_hd__dfxtp_1  179.400  421.600  R0  PLACED  _34418_
i_debug_ctrl.i_lisa_tx8n.mode[2]  flop  sky130_fd_sc_hd__dfxtp_1  187.220  427.040  R0  PLACED  _34419_
i_debug_ctrl.i_lisa_tx8n.mode[3]  flop  sky130_fd_sc_hd__dfxtp_1  175.720  429.760  MX  PLACED  _34420_
i_debug_ctrl.i_lisa_tx8n.s_buf_sent  flop  sky130_fd_sc_hd__dfxtp_1  198.720  421.600  R0  PLACED  _32974_
i_debug_ctrl.i_lisa_tx8n.s_buf_wr  flop  sky130_fd_sc_hd__dfxtp_1  206.080  421.600  R0  PLACED  _32985_
i_debug_ctrl.i_lisa_tx8n.s_latch_be  flop  sky130_fd_sc_hd__dfxtp_1  133.860  427.040  R0  PLACED  _32975_
i_debug_ctrl.i_lisa_tx8n.s_wr_edge  flop  sky130_fd_sc_hd__dfxtp_1  260.360  421.600  R0  PLACED  _32976_
i_debug_ctrl.i_lisa_tx8n.shift[0]  flop  sky130_fd_sc_hd__dfxtp_1  187.220  424.320  MX  PLACED  _32966_
i_debug_ctrl.i_lisa_tx8n.shift[1]  flop  sky130_fd_sc_hd__dfxtp_1  214.360  421.600  R0  PLACED  _32967_
i_debug_ctrl.i_lisa_tx8n.shift[2]  flop  sky130_fd_sc_hd__dfxtp_1  224.480  416.160  R0  PLACED  _32968_
i_debug_ctrl.i_lisa_tx8n.shift[3]  flop  sky130_fd_sc_hd__dfxtp_1  232.760  416.160  R0  PLACED  _32969_
i_debug_ctrl.i_lisa_tx8n.shift[4]  flop  sky130_fd_sc_hd__dfxtp_1  240.120  416.160  R0  PLACED  _32970_
i_debug_ctrl.i_lisa_tx8n.shift[5]  flop  sky130_fd_sc_hd__dfxtp_1  240.120  424.320  MX  PLACED  _32971_
i_debug_ctrl.i_lisa_tx8n.shift[6]  flop  sky130_fd_sc_hd__dfxtp_1  235.980  421.600  R0  PLACED  _32972_
i_debug_ctrl.i_lisa_tx8n.shift[7]  flop  sky130_fd_sc_hd__dfxtp_1  199.640  427.040  R0  PLACED  _32973_
i_debug_ctrl.i_lisa_tx8n.zero_clock  flop  sky130_fd_sc_hd__dfxtp_1  149.960  435.200  MX  PLACED  _32965_
i_debug_ctrl.lisa_rx_d[0]  flop  sky130_fd_sc_hd__dfxtp_1  340.400  416.160  R0  PLACED  _32876_
i_debug_ctrl.lisa_rx_d[1]  flop  sky130_fd_sc_hd__dfxtp_1  346.380  413.440  MX  PLACED  _32877_
i_debug_ctrl.lisa_rx_d[2]  flop  sky130_fd_sc_hd__dfxtp_1  346.380  418.880  MX  PLACED  _32878_
i_debug_ctrl.lisa_rx_d[3]  flop  sky130_fd_sc_hd__dfxtp_1  380.420  421.600  R0  PLACED  _32879_
i_debug_ctrl.lisa_rx_d[4]  flop  sky130_fd_sc_hd__dfxtp_1  354.200  427.040  R0  PLACED  _32880_
i_debug_ctrl.lisa_rx_d[5]  flop  sky130_fd_sc_hd__dfxtp_1  365.700  429.760  MX  PLACED  _32881_
i_debug_ctrl.lisa_rx_d[6]  flop  sky130_fd_sc_hd__dfxtp_1  373.060  429.760  MX  PLACED  _32882_
i_debug_ctrl.lisa_rx_d[7]  flop  sky130_fd_sc_hd__dfxtp_1  379.040  424.320  MX  PLACED  _32883_
i_debug_ctrl.lisa_rx_data_avail  flop  sky130_fd_sc_hd__dfrtp_1  350.980  405.280  R0  PLACED  _32863_
i_debug_ctrl.plus_guard_time[0]  flop  sky130_fd_sc_hd__dfxtp_1  428.720  394.400  R0  PLACED  _33007_
i_debug_ctrl.plus_guard_time[1]  flop  sky130_fd_sc_hd__dfxtp_1  434.240  388.960  R0  PLACED  _33008_
i_debug_ctrl.plus_guard_time[2]  flop  sky130_fd_sc_hd__dfxtp_1  420.440  388.960  R0  PLACED  _33009_
i_debug_ctrl.plus_guard_time[3]  flop  sky130_fd_sc_hd__dfxtp_1  417.680  386.240  MX  PLACED  _33010_
i_debug_ctrl.s_after_state[0]  flop  sky130_fd_sc_hd__dfxtp_1  338.100  391.680  MX  PLACED  _32874_
i_debug_ctrl.s_after_state[1]  flop  sky130_fd_sc_hd__dfxtp_1  326.140  402.560  MX  PLACED  _32875_
i_debug_ctrl.s_after_state[2]  flop  sky130_fd_sc_hd__dfxtp_1  339.940  399.840  R0  PLACED  _34561_
i_debug_ctrl.s_after_state[3]  flop  sky130_fd_sc_hd__dfxtp_1  325.220  394.400  R0  PLACED  _34560_
i_debug_ctrl.s_guard_count[0]  flop  sky130_fd_sc_hd__dfrtp_1  83.720  456.960  MX  PLACED  _32831_
i_debug_ctrl.s_guard_count[10]  flop  sky130_fd_sc_hd__dfrtp_1  100.740  454.240  R0  PLACED  _32841_
i_debug_ctrl.s_guard_count[11]  flop  sky130_fd_sc_hd__dfrtp_1  110.400  456.960  MX  PLACED  _32842_
i_debug_ctrl.s_guard_count[12]  flop  sky130_fd_sc_hd__dfrtp_1  109.480  440.640  MX  PLACED  _32843_
i_debug_ctrl.s_guard_count[13]  flop  sky130_fd_sc_hd__dfrtp_1  109.480  432.480  R0  PLACED  _32844_
i_debug_ctrl.s_guard_count[14]  flop  sky130_fd_sc_hd__dfrtp_1  116.380  435.200  MX  PLACED  _32845_
i_debug_ctrl.s_guard_count[15]  flop  sky130_fd_sc_hd__dfrtp_1  96.140  435.200  MX  PLACED  _32846_
i_debug_ctrl.s_guard_count[16]  flop  sky130_fd_sc_hd__dfrtp_1  80.500  435.200  MX  PLACED  _32847_
i_debug_ctrl.s_guard_count[17]  flop  sky130_fd_sc_hd__dfrtp_1  89.240  429.760  MX  PLACED  _32848_
i_debug_ctrl.s_guard_count[18]  flop  sky130_fd_sc_hd__dfrtp_1  78.660  427.040  R0  PLACED  _32849_
i_debug_ctrl.s_guard_count[19]  flop  sky130_fd_sc_hd__dfrtp_1  89.700  424.320  MX  PLACED  _32850_
i_debug_ctrl.s_guard_count[1]  flop  sky130_fd_sc_hd__dfrtp_1  92.920  456.960  MX  PLACED  _32832_
i_debug_ctrl.s_guard_count[20]  flop  sky130_fd_sc_hd__dfrtp_1  122.360  424.320  MX  PLACED  _32851_
i_debug_ctrl.s_guard_count[21]  flop  sky130_fd_sc_hd__dfrtp_1  124.660  427.040  R0  PLACED  _32852_
i_debug_ctrl.s_guard_count[22]  flop  sky130_fd_sc_hd__dfrtp_1  103.500  421.600  R0  PLACED  _32853_
i_debug_ctrl.s_guard_count[23]  flop  sky130_fd_sc_hd__dfrtp_1  97.520  427.040  R0  PLACED  _32854_
i_debug_ctrl.s_guard_count[2]  flop  sky130_fd_sc_hd__dfrtp_1  94.760  448.800  R0  PLACED  _32833_
i_debug_ctrl.s_guard_count[3]  flop  sky130_fd_sc_hd__dfrtp_1  70.840  451.520  MX  PLACED  _32834_
i_debug_ctrl.s_guard_count[4]  flop  sky130_fd_sc_hd__dfrtp_1  75.900  448.800  R0  PLACED  _32835_
i_debug_ctrl.s_guard_count[5]  flop  sky130_fd_sc_hd__dfrtp_1  77.280  443.360  R0  PLACED  _32836_
i_debug_ctrl.s_guard_count[6]  flop  sky130_fd_sc_hd__dfrtp_1  92.000  440.640  MX  PLACED  _32837_
i_debug_ctrl.s_guard_count[7]  flop  sky130_fd_sc_hd__dfrtp_1  96.600  446.080  MX  PLACED  _32838_
i_debug_ctrl.s_guard_count[8]  flop  sky130_fd_sc_hd__dfrtp_1  110.400  446.080  MX  PLACED  _32839_
i_debug_ctrl.s_guard_count[9]  flop  sky130_fd_sc_hd__dfrtp_1  109.480  448.800  R0  PLACED  _32840_
i_debug_ctrl.s_last_debug_halted  flop  sky130_fd_sc_hd__dfstp_2  362.020  372.640  R0  PLACED  _32869_
i_debug_ctrl.s_lisa_has_uart  flop  sky130_fd_sc_hd__dfrtp_1  266.800  413.440  MX  PLACED  _32857_
i_debug_ctrl.s_lisa_uart_grant  flop  sky130_fd_sc_hd__dfrtp_1  381.340  405.280  R0  PLACED  _32862_
i_debug_ctrl.s_plus_count[0]  flop  sky130_fd_sc_hd__dfrtp_1  70.840  459.680  R0  PLACED  _32855_
i_debug_ctrl.s_plus_count[1]  flop  sky130_fd_sc_hd__dfrtp_1  77.280  454.240  R0  PLACED  _32856_
i_debug_ctrl.s_reset_count[0]  flop  sky130_fd_sc_hd__dfrtp_1  132.480  440.640  MX  PLACED  _32858_
i_debug_ctrl.s_reset_count[1]  flop  sky130_fd_sc_hd__dfrtp_1  126.040  448.800  R0  PLACED  _32859_
i_debug_ctrl.s_reset_count[2]  flop  sky130_fd_sc_hd__dfrtp_1  122.360  446.080  MX  PLACED  _32860_
i_debug_ctrl.s_reset_count[3]  flop  sky130_fd_sc_hd__dfrtp_1  122.360  440.640  MX  PLACED  _32861_
i_debug_ctrl.s_state[0]  flop  sky130_fd_sc_hd__dfrtp_1  402.500  394.400  R0  PLACED  _32870_
i_debug_ctrl.s_state[1]  flop  sky130_fd_sc_hd__dfrtp_1  405.720  402.560  MX  PLACED  _32871_
i_debug_ctrl.s_state[2]  flop  sky130_fd_sc_hd__dfrtp_1  376.740  399.840  R0  PLACED  _32872_
i_debug_ctrl.s_state[3]  flop  sky130_fd_sc_hd__dfrtp_1  411.700  394.400  R0  PLACED  _32873_
i_debug_ctrl.s_t_len[0]  flop  sky130_fd_sc_hd__dfrtp_1  326.600  410.720  R0  PLACED  _32610_
i_debug_ctrl.s_t_len[1]  flop  sky130_fd_sc_hd__dfrtp_1  328.440  408.000  MX  PLACED  _32611_
i_debug_ctrl.s_t_len[2]  flop  sky130_fd_sc_hd__dfrtp_1  331.200  416.160  R0  PLACED  _32612_
i_debug_ctrl.s_tx_d[0]  flop  sky130_fd_sc_hd__dfrtp_1  289.340  410.720  R0  PLACED  _32448_
i_debug_ctrl.s_tx_d[1]  flop  sky130_fd_sc_hd__dfrtp_1  296.700  413.440  MX  PLACED  _32449_
i_debug_ctrl.s_tx_d[2]  flop  sky130_fd_sc_hd__dfrtp_1  289.800  405.280  R0  PLACED  _32450_
i_debug_ctrl.s_tx_d[3]  flop  sky130_fd_sc_hd__dfrtp_1  280.600  405.280  R0  PLACED  _32451_
i_debug_ctrl.s_tx_d[4]  flop  sky130_fd_sc_hd__dfrtp_1  284.280  416.160  R0  PLACED  _32452_
i_debug_ctrl.s_tx_d[5]  flop  sky130_fd_sc_hd__dfrtp_1  269.560  408.000  MX  PLACED  _32453_
i_debug_ctrl.s_tx_d[6]  flop  sky130_fd_sc_hd__dfrtp_1  274.620  416.160  R0  PLACED  _32454_
i_debug_ctrl.s_tx_wr  flop  sky130_fd_sc_hd__dfrtp_1  408.020  388.960  R0  PLACED  _32865_
i_debug_regs.addr_1c_bits[0]  latch  sky130_fd_sc_hd__dlrtp_1  401.120  359.040  MX  PLACED  i_debug_regs.BASE_BITS\[0\].IO_GEN.io_mux_latch
i_debug_regs.addr_1c_bits[1]  latch  sky130_fd_sc_hd__dlrtp_1  402.960  367.200  R0  PLACED  i_debug_regs.BASE_BITS\[1\].IO_GEN.io_mux_latch
i_debug_regs.addr_1c_bits[2]  latch  sky130_fd_sc_hd__dlrtp_1  402.500  361.760  R0  PLACED  i_debug_regs.BASE_BITS\[2\].IO_GEN.io_mux_latch
i_debug_regs.addr_1c_bits[3]  latch  sky130_fd_sc_hd__dlrtp_1  403.420  375.360  MX  PLACED  i_debug_regs.BASE_BITS\[3\].IO_GEN.io_mux_latch
i_debug_regs.addr_1c_bits[4]  latch  sky130_fd_sc_hd__dlrtp_1  416.300  372.640  R0  PLACED  i_debug_regs.BASE_BITS\[4\].IO_GEN.io_mux_latch
i_debug_regs.addr_1c_bits[5]  latch  sky130_fd_sc_hd__dlrtp_1  405.260  378.080  R0  PLACED  i_debug_regs.BASE_BITS\[5\].IO_GEN.io_mux_latch
i_debug_regs.addr_1c_bits[6]  latch  sky130_fd_sc_hd__dlrtp_1  402.500  372.640  R0  PLACED  i_debug_regs.BASE_BITS\[6\].IO_GEN.io_mux_latch
i_debug_regs.addr_1c_bits[7]  latch  sky130_fd_sc_hd__dlrtp_1  402.960  364.480  MX  PLACED  i_debug_regs.BASE_BITS\[7\].IO_GEN.io_mux_latch
i_debug_regs.addr_1e_bits[0]  latch  sky130_fd_sc_hd__dlrtp_1  443.440  380.800  MX  PLACED  i_debug_regs.BREAK_BITS\[0\].addr_1e_latch
i_debug_regs.addr_1e_bits[10]  latch  sky130_fd_sc_hd__dlrtp_1  557.060  356.320  R0  PLACED  i_debug_regs.BREAK_BITS\[10\].addr_1e_latch
i_debug_regs.addr_1e_bits[11]  latch  sky130_fd_sc_hd__dlrtp_1  531.300  361.760  R0  PLACED  i_debug_regs.BREAK_BITS\[11\].addr_1e_latch
i_debug_regs.addr_1e_bits[12]  latch  sky130_fd_sc_hd__dlrtp_1  546.940  361.760  R0  PLACED  i_debug_regs.BREAK_BITS\[12\].addr_1e_latch
i_debug_regs.addr_1e_bits[1]  latch  sky130_fd_sc_hd__dlrtp_1  434.700  353.600  MX  PLACED  i_debug_regs.BREAK_BITS\[1\].addr_1e_latch
i_debug_regs.addr_1e_bits[2]  latch  sky130_fd_sc_hd__dlrtp_1  437.460  378.080  R0  PLACED  i_debug_regs.BREAK_BITS\[2\].addr_1e_latch
i_debug_regs.addr_1e_bits[3]  latch  sky130_fd_sc_hd__dlrtp_1  448.960  375.360  MX  PLACED  i_debug_regs.BREAK_BITS\[3\].addr_1e_latch
i_debug_regs.addr_1e_bits[4]  latch  sky130_fd_sc_hd__dlrtp_1  552.920  375.360  MX  PLACED  i_debug_regs.BREAK_BITS\[4\].addr_1e_latch
i_debug_regs.addr_1e_bits[5]  latch  sky130_fd_sc_hd__dlrtp_1  557.060  378.080  R0  PLACED  i_debug_regs.BREAK_BITS\[5\].addr_1e_latch
i_debug_regs.addr_1e_bits[6]  latch  sky130_fd_sc_hd__dlrtp_1  557.060  372.640  R0  PLACED  i_debug_regs.BREAK_BITS\[6\].addr_1e_latch
i_debug_regs.addr_1e_bits[7]  latch  sky130_fd_sc_hd__dlrtp_1  552.460  369.920  MX  PLACED  i_debug_regs.BREAK_BITS\[7\].addr_1e_latch
i_debug_regs.addr_1e_bits[8]  latch  sky130_fd_sc_hd__dlrtp_1  446.660  369.920  MX  PLACED  i_debug_regs.BREAK_BITS\[8\].addr_1e_latch
i_debug_regs.addr_1e_bits[9]  latch  sky130_fd_sc_hd__dlrtp_1  457.700  367.200  R0  PLACED  i_debug_regs.BREAK_BITS\[9\].addr_1e_latch
i_debug_regs.cmd_quad_write_r[0]  flop  sky130_fd_sc_hd__dfxtp_1  465.980  323.680  R0  PLACED  _33034_
i_debug_regs.cmd_quad_write_r[1]  flop  sky130_fd_sc_hd__dfxtp_1  462.300  334.560  R0  PLACED  _33035_
i_debug_regs.cmd_quad_write_r[2]  flop  sky130_fd_sc_hd__dfxtp_1  475.180  326.400  MX  PLACED  _33036_
i_debug_regs.cmd_quad_write_r[3]  flop  sky130_fd_sc_hd__dfxtp_1  508.760  329.120  R0  PLACED  _33037_
i_debug_regs.cmd_quad_write_r[4]  flop  sky130_fd_sc_hd__dfxtp_1  516.120  318.240  R0  PLACED  _33038_
i_debug_regs.cmd_quad_write_r[5]  flop  sky130_fd_sc_hd__dfxtp_1  524.400  326.400  MX  PLACED  _33039_
i_debug_regs.cmd_quad_write_r[6]  flop  sky130_fd_sc_hd__dfxtp_1  497.720  323.680  R0  PLACED  _33040_
i_debug_regs.cmd_quad_write_r[7]  flop  sky130_fd_sc_hd__dfxtp_1  458.620  342.720  MX  PLACED  _33041_
i_debug_regs.inst_cache_invalidate  flop  sky130_fd_sc_hd__dfxtp_1  533.140  280.160  R0  PLACED  _32996_
i_debug_regs.is_flash[0]  flop  sky130_fd_sc_hd__dfxtp_1  428.260  383.520  R0  PLACED  _33019_
i_debug_regs.is_flash[1]  flop  sky130_fd_sc_hd__dfxtp_1  436.080  383.520  R0  PLACED  _33020_
i_debug_regs.lisa1_base_addr[0]  latch  sky130_fd_sc_hd__dlrtp_1  446.200  342.720  MX  PLACED  i_debug_regs.BASE_BITS\[0\].lisa1_base_latch
i_debug_regs.lisa1_base_addr[10]  latch  sky130_fd_sc_hd__dlrtp_1  550.620  350.880  R0  PLACED  i_debug_regs.BASE_BITS\[10\].lisa1_base_latch
i_debug_regs.lisa1_base_addr[11]  latch  sky130_fd_sc_hd__dlrtp_1  535.440  359.040  MX  PLACED  i_debug_regs.BASE_BITS\[11\].lisa1_base_latch
i_debug_regs.lisa1_base_addr[12]  latch  sky130_fd_sc_hd__dlrtp_1  563.500  364.480  MX  PLACED  i_debug_regs.BASE_BITS\[12\].lisa1_base_latch
i_debug_regs.lisa1_base_addr[13]  latch  sky130_fd_sc_hd__dlrtp_1  413.540  350.880  R0  PLACED  i_debug_regs.BASE_BITS\[13\].lisa1_base_latch
i_debug_regs.lisa1_base_addr[14]  latch  sky130_fd_sc_hd__dlrtp_1  415.380  342.720  MX  PLACED  i_debug_regs.BASE_BITS\[14\].lisa1_base_latch
i_debug_regs.lisa1_base_addr[15]  latch  sky130_fd_sc_hd__dlrtp_1  414.920  356.320  R0  PLACED  i_debug_regs.BASE_BITS\[15\].lisa1_base_latch
i_debug_regs.lisa1_base_addr[1]  latch  sky130_fd_sc_hd__dlrtp_1  544.640  342.720  MX  PLACED  i_debug_regs.BASE_BITS\[1\].lisa1_base_latch
i_debug_regs.lisa1_base_addr[2]  latch  sky130_fd_sc_hd__dlrtp_1  534.980  340.000  R0  PLACED  i_debug_regs.BASE_BITS\[2\].lisa1_base_latch
i_debug_regs.lisa1_base_addr[3]  latch  sky130_fd_sc_hd__dlrtp_1  470.580  331.840  MX  PLACED  i_debug_regs.BASE_BITS\[3\].lisa1_base_latch
i_debug_regs.lisa1_base_addr[4]  latch  sky130_fd_sc_hd__dlrtp_1  564.880  329.120  R0  PLACED  i_debug_regs.BASE_BITS\[4\].lisa1_base_latch
i_debug_regs.lisa1_base_addr[5]  latch  sky130_fd_sc_hd__dlrtp_1  564.420  345.440  R0  PLACED  i_debug_regs.BASE_BITS\[5\].lisa1_base_latch
i_debug_regs.lisa1_base_addr[6]  latch  sky130_fd_sc_hd__dlrtp_1  470.580  364.480  MX  PLACED  i_debug_regs.BASE_BITS\[6\].lisa1_base_latch
i_debug_regs.lisa1_base_addr[7]  latch  sky130_fd_sc_hd__dlrtp_1  461.840  361.760  R0  PLACED  i_debug_regs.BASE_BITS\[7\].lisa1_base_latch
i_debug_regs.lisa1_base_addr[8]  latch  sky130_fd_sc_hd__dlrtp_1  426.880  364.480  MX  PLACED  i_debug_regs.BASE_BITS\[8\].lisa1_base_latch
i_debug_regs.lisa1_base_addr[9]  latch  sky130_fd_sc_hd__dlrtp_1  444.820  359.040  MX  PLACED  i_debug_regs.BASE_BITS\[9\].lisa1_base_latch
i_debug_regs.lisa1_ce_ctrl[0]  flop  sky130_fd_sc_hd__dfxtp_1  418.600  323.680  R0  PLACED  _33011_
i_debug_regs.lisa1_ce_ctrl[1]  flop  sky130_fd_sc_hd__dfxtp_1  432.860  337.280  MX  PLACED  _33012_
i_debug_regs.lisa2_base_addr[0]  latch  sky130_fd_sc_hd__dlrtp_1  585.120  342.720  MX  PLACED  i_debug_regs.BASE_BITS\[0\].lisa2_base_latch
i_debug_regs.lisa2_base_addr[10]  latch  sky130_fd_sc_hd__dlrtp_1  574.080  353.600  MX  PLACED  i_debug_regs.BASE_BITS\[10\].lisa2_base_latch
i_debug_regs.lisa2_base_addr[11]  latch  sky130_fd_sc_hd__dlrtp_1  541.420  350.880  R0  PLACED  i_debug_regs.BASE_BITS\[11\].lisa2_base_latch
i_debug_regs.lisa2_base_addr[12]  latch  sky130_fd_sc_hd__dlrtp_1  576.380  361.760  R0  PLACED  i_debug_regs.BASE_BITS\[12\].lisa2_base_latch
i_debug_regs.lisa2_base_addr[13]  latch  sky130_fd_sc_hd__dlrtp_1  406.640  350.880  R0  PLACED  i_debug_regs.BASE_BITS\[13\].lisa2_base_latch
i_debug_regs.lisa2_base_addr[14]  latch  sky130_fd_sc_hd__dlrtp_1  408.020  342.720  MX  PLACED  i_debug_regs.BASE_BITS\[14\].lisa2_base_latch
i_debug_regs.lisa2_base_addr[15]  latch  sky130_fd_sc_hd__dlrtp_1  408.020  359.040  MX  PLACED  i_debug_regs.BASE_BITS\[15\].lisa2_base_latch
i_debug_regs.lisa2_base_addr[1]  latch  sky130_fd_sc_hd__dlrtp_1  557.060  340.000  R0  PLACED  i_debug_regs.BASE_BITS\[1\].lisa2_base_latch
i_debug_regs.lisa2_base_addr[2]  latch  sky130_fd_sc_hd__dlrtp_1  580.060  337.280  MX  PLACED  i_debug_regs.BASE_BITS\[2\].lisa2_base_latch
i_debug_regs.lisa2_base_addr[3]  latch  sky130_fd_sc_hd__dlrtp_1  543.260  367.200  R0  PLACED  i_debug_regs.BASE_BITS\[3\].lisa2_base_latch
i_debug_regs.lisa2_base_addr[4]  latch  sky130_fd_sc_hd__dlrtp_1  550.160  364.480  MX  PLACED  i_debug_regs.BASE_BITS\[4\].lisa2_base_latch
i_debug_regs.lisa2_base_addr[5]  latch  sky130_fd_sc_hd__dlrtp_1  579.600  331.840  MX  PLACED  i_debug_regs.BASE_BITS\[5\].lisa2_base_latch
i_debug_regs.lisa2_base_addr[6]  latch  sky130_fd_sc_hd__dlrtp_1  544.180  364.480  MX  PLACED  i_debug_regs.BASE_BITS\[6\].lisa2_base_latch
i_debug_regs.lisa2_base_addr[7]  latch  sky130_fd_sc_hd__dlrtp_1  455.860  356.320  R0  PLACED  i_debug_regs.BASE_BITS\[7\].lisa2_base_latch
i_debug_regs.lisa2_base_addr[8]  latch  sky130_fd_sc_hd__dlrtp_1  433.780  364.480  MX  PLACED  i_debug_regs.BASE_BITS\[8\].lisa2_base_latch
i_debug_regs.lisa2_base_addr[9]  latch  sky130_fd_sc_hd__dlrtp_1  443.440  361.760  R0  PLACED  i_debug_regs.BASE_BITS\[9\].lisa2_base_latch
i_debug_regs.lisa2_ce_ctrl[0]  flop  sky130_fd_sc_hd__dfxtp_1  429.640  323.680  R0  PLACED  _33013_
i_debug_regs.lisa2_ce_ctrl[1]  flop  sky130_fd_sc_hd__dfxtp_1  429.640  329.120  R0  PLACED  _33014_
i_debug_regs.output_mux_bits[0]  latch  sky130_fd_sc_hd__dlrtp_1  417.220  391.680  MX  PLACED  i_debug_regs.BASE_BITS\[0\].output_mux_latch
i_debug_regs.output_mux_bits[10]  latch  sky130_fd_sc_hd__dlrtp_1  415.380  359.040  MX  PLACED  i_debug_regs.BASE_BITS\[10\].output_mux_latch
i_debug_regs.output_mux_bits[11]  latch  sky130_fd_sc_hd__dlrtp_1  415.380  364.480  MX  PLACED  i_debug_regs.BASE_BITS\[11\].output_mux_latch
i_debug_regs.output_mux_bits[12]  latch  sky130_fd_sc_hd__dlrtp_1  421.820  394.400  R0  PLACED  i_debug_regs.BASE_BITS\[12\].output_mux_latch
i_debug_regs.output_mux_bits[13]  latch  sky130_fd_sc_hd__dlrtp_1  421.820  397.120  MX  PLACED  i_debug_regs.BASE_BITS\[13\].output_mux_latch
i_debug_regs.output_mux_bits[14]  latch  sky130_fd_sc_hd__dlrtp_1  414.000  399.840  R0  PLACED  i_debug_regs.BASE_BITS\[14\].output_mux_latch
i_debug_regs.output_mux_bits[15]  latch  sky130_fd_sc_hd__dlrtp_1  415.840  397.120  MX  PLACED  i_debug_regs.BASE_BITS\[15\].output_mux_latch
i_debug_regs.output_mux_bits[1]  latch  sky130_fd_sc_hd__dlrtp_1  418.140  367.200  R0  PLACED  i_debug_regs.BASE_BITS\[1\].output_mux_latch
i_debug_regs.output_mux_bits[2]  latch  sky130_fd_sc_hd__dlrtp_1  411.240  378.080  R0  PLACED  i_debug_regs.BASE_BITS\[2\].output_mux_latch
i_debug_regs.output_mux_bits[3]  latch  sky130_fd_sc_hd__dlrtp_1  415.380  375.360  MX  PLACED  i_debug_regs.BASE_BITS\[3\].output_mux_latch
i_debug_regs.output_mux_bits[4]  latch  sky130_fd_sc_hd__dlrtp_1  415.380  402.560  MX  PLACED  i_debug_regs.BASE_BITS\[4\].output_mux_latch
i_debug_regs.output_mux_bits[5]  latch  sky130_fd_sc_hd__dlrtp_1  410.320  383.520  R0  PLACED  i_debug_regs.BASE_BITS\[5\].output_mux_latch
i_debug_regs.output_mux_bits[6]  latch  sky130_fd_sc_hd__dlrtp_1  410.320  372.640  R0  PLACED  i_debug_regs.BASE_BITS\[6\].output_mux_latch
i_debug_regs.output_mux_bits[7]  latch  sky130_fd_sc_hd__dlrtp_1  408.940  369.920  MX  PLACED  i_debug_regs.BASE_BITS\[7\].output_mux_latch
i_debug_regs.output_mux_bits[8]  latch  sky130_fd_sc_hd__dlrtp_1  408.940  367.200  R0  PLACED  i_debug_regs.BASE_BITS\[8\].output_mux_latch
i_debug_regs.output_mux_bits[9]  latch  sky130_fd_sc_hd__dlrtp_1  408.940  364.480  MX  PLACED  i_debug_regs.BASE_BITS\[9\].output_mux_latch
i_debug_regs.quad_mode[0]  flop  sky130_fd_sc_hd__dfxtp_1  425.040  369.920  MX  PLACED  _33021_
i_debug_regs.quad_mode[1]  flop  sky130_fd_sc_hd__dfxtp_1  436.080  372.640  R0  PLACED  _33022_
i_debug_regs.ttlc_brk_addr0[0]  latch  sky130_fd_sc_hd__dlrtp_1  585.120  318.240  R0  PLACED  i_debug_regs.BREAK_BITS\[0\].ttlc_brk0_latch
i_debug_regs.ttlc_brk_addr0[10]  latch  sky130_fd_sc_hd__dlrtp_1  576.380  293.760  MX  PLACED  i_debug_regs.BREAK_BITS\[10\].ttlc_brk0_latch
i_debug_regs.ttlc_brk_addr0[11]  latch  sky130_fd_sc_hd__dlrtp_1  584.660  307.360  R0  PLACED  i_debug_regs.BREAK_BITS\[11\].ttlc_brk0_latch
i_debug_regs.ttlc_brk_addr0[12]  latch  sky130_fd_sc_hd__dlrtp_1  592.020  307.360  R0  PLACED  i_debug_regs.BREAK_BITS\[12\].ttlc_brk0_latch
i_debug_regs.ttlc_brk_addr0[1]  latch  sky130_fd_sc_hd__dlrtp_1  589.260  315.520  MX  PLACED  i_debug_regs.BREAK_BITS\[1\].ttlc_brk0_latch
i_debug_regs.ttlc_brk_addr0[2]  latch  sky130_fd_sc_hd__dlrtp_1  579.600  299.200  MX  PLACED  i_debug_regs.BREAK_BITS\[2\].ttlc_brk0_latch
i_debug_regs.ttlc_brk_addr0[3]  latch  sky130_fd_sc_hd__dlrtp_1  566.260  312.800  R0  PLACED  i_debug_regs.BREAK_BITS\[3\].ttlc_brk0_latch
i_debug_regs.ttlc_brk_addr0[4]  latch  sky130_fd_sc_hd__dlrtp_1  592.940  318.240  R0  PLACED  i_debug_regs.BREAK_BITS\[4\].ttlc_brk0_latch
i_debug_regs.ttlc_brk_addr0[5]  latch  sky130_fd_sc_hd__dlrtp_1  581.900  310.080  MX  PLACED  i_debug_regs.BREAK_BITS\[5\].ttlc_brk0_latch
i_debug_regs.ttlc_brk_addr0[6]  latch  sky130_fd_sc_hd__dlrtp_1  589.260  299.200  MX  PLACED  i_debug_regs.BREAK_BITS\[6\].ttlc_brk0_latch
i_debug_regs.ttlc_brk_addr0[7]  latch  sky130_fd_sc_hd__dlrtp_1  570.860  315.520  MX  PLACED  i_debug_regs.BREAK_BITS\[7\].ttlc_brk0_latch
i_debug_regs.ttlc_brk_addr0[8]  latch  sky130_fd_sc_hd__dlrtp_1  567.180  301.920  R0  PLACED  i_debug_regs.BREAK_BITS\[8\].ttlc_brk0_latch
i_debug_regs.ttlc_brk_addr0[9]  latch  sky130_fd_sc_hd__dlrtp_1  575.460  318.240  R0  PLACED  i_debug_regs.BREAK_BITS\[9\].ttlc_brk0_latch
i_debug_regs.ttlc_brk_addr1[0]  latch  sky130_fd_sc_hd__dlrtp_1  584.200  280.160  R0  PLACED  i_debug_regs.BREAK_BITS\[0\].ttlc_brk1_latch
i_debug_regs.ttlc_brk_addr1[10]  latch  sky130_fd_sc_hd__dlrtp_1  575.000  274.720  R0  PLACED  i_debug_regs.BREAK_BITS\[10\].ttlc_brk1_latch
i_debug_regs.ttlc_brk_addr1[11]  latch  sky130_fd_sc_hd__dlrtp_1  585.120  282.880  MX  PLACED  i_debug_regs.BREAK_BITS\[11\].ttlc_brk1_latch
i_debug_regs.ttlc_brk_addr1[12]  latch  sky130_fd_sc_hd__dlrtp_1  590.180  291.040  R0  PLACED  i_debug_regs.BREAK_BITS\[12\].ttlc_brk1_latch
i_debug_regs.ttlc_brk_addr1[1]  latch  sky130_fd_sc_hd__dlrtp_1  588.800  274.720  R0  PLACED  i_debug_regs.BREAK_BITS\[1\].ttlc_brk1_latch
i_debug_regs.ttlc_brk_addr1[2]  latch  sky130_fd_sc_hd__dlrtp_1  579.140  277.440  MX  PLACED  i_debug_regs.BREAK_BITS\[2\].ttlc_brk1_latch
i_debug_regs.ttlc_brk_addr1[3]  latch  sky130_fd_sc_hd__dlrtp_1  569.940  277.440  MX  PLACED  i_debug_regs.BREAK_BITS\[3\].ttlc_brk1_latch
i_debug_regs.ttlc_brk_addr1[4]  latch  sky130_fd_sc_hd__dlrtp_1  588.800  285.600  R0  PLACED  i_debug_regs.BREAK_BITS\[4\].ttlc_brk1_latch
i_debug_regs.ttlc_brk_addr1[5]  latch  sky130_fd_sc_hd__dlrtp_1  579.140  282.880  MX  PLACED  i_debug_regs.BREAK_BITS\[5\].ttlc_brk1_latch
i_debug_regs.ttlc_brk_addr1[6]  latch  sky130_fd_sc_hd__dlrtp_1  589.260  288.320  MX  PLACED  i_debug_regs.BREAK_BITS\[6\].ttlc_brk1_latch
i_debug_regs.ttlc_brk_addr1[7]  latch  sky130_fd_sc_hd__dlrtp_1  570.860  280.160  R0  PLACED  i_debug_regs.BREAK_BITS\[7\].ttlc_brk1_latch
i_debug_regs.ttlc_brk_addr1[8]  latch  sky130_fd_sc_hd__dlrtp_1  567.180  274.720  R0  PLACED  i_debug_regs.BREAK_BITS\[8\].ttlc_brk1_latch
i_debug_regs.ttlc_brk_addr1[9]  latch  sky130_fd_sc_hd__dlrtp_1  573.160  282.880  MX  PLACED  i_debug_regs.BREAK_BITS\[9\].ttlc_brk1_latch
i_debug_regs.ttlc_brk_addr2[0]  latch  sky130_fd_sc_hd__dlrtp_1  585.120  304.640  MX  PLACED  i_debug_regs.BREAK_BITS\[0\].ttlc_brk2_latch
i_debug_regs.ttlc_brk_addr2[10]  latch  sky130_fd_sc_hd__dlrtp_1  575.920  296.480  R0  PLACED  i_debug_regs.BREAK_BITS\[10\].ttlc_brk2_latch
i_debug_regs.ttlc_brk_addr2[11]  latch  sky130_fd_sc_hd__dlrtp_1  584.200  296.480  R0  PLACED  i_debug_regs.BREAK_BITS\[11\].ttlc_brk2_latch
i_debug_regs.ttlc_brk_addr2[12]  latch  sky130_fd_sc_hd__dlrtp_1  591.560  301.920  R0  PLACED  i_debug_regs.BREAK_BITS\[12\].ttlc_brk2_latch
i_debug_regs.ttlc_brk_addr2[1]  latch  sky130_fd_sc_hd__dlrtp_1  589.260  310.080  MX  PLACED  i_debug_regs.BREAK_BITS\[1\].ttlc_brk2_latch
i_debug_regs.ttlc_brk_addr2[2]  latch  sky130_fd_sc_hd__dlrtp_1  579.140  304.640  MX  PLACED  i_debug_regs.BREAK_BITS\[2\].ttlc_brk2_latch
i_debug_regs.ttlc_brk_addr2[3]  latch  sky130_fd_sc_hd__dlrtp_1  569.940  299.200  MX  PLACED  i_debug_regs.BREAK_BITS\[3\].ttlc_brk2_latch
i_debug_regs.ttlc_brk_addr2[4]  latch  sky130_fd_sc_hd__dlrtp_1  592.480  312.800  R0  PLACED  i_debug_regs.BREAK_BITS\[4\].ttlc_brk2_latch
i_debug_regs.ttlc_brk_addr2[5]  latch  sky130_fd_sc_hd__dlrtp_1  582.820  312.800  R0  PLACED  i_debug_regs.BREAK_BITS\[5\].ttlc_brk2_latch
i_debug_regs.ttlc_brk_addr2[6]  latch  sky130_fd_sc_hd__dlrtp_1  590.640  296.480  R0  PLACED  i_debug_regs.BREAK_BITS\[6\].ttlc_brk2_latch
i_debug_regs.ttlc_brk_addr2[7]  latch  sky130_fd_sc_hd__dlrtp_1  568.560  307.360  R0  PLACED  i_debug_regs.BREAK_BITS\[7\].ttlc_brk2_latch
i_debug_regs.ttlc_brk_addr2[8]  latch  sky130_fd_sc_hd__dlrtp_1  566.260  296.480  R0  PLACED  i_debug_regs.BREAK_BITS\[8\].ttlc_brk2_latch
i_debug_regs.ttlc_brk_addr2[9]  latch  sky130_fd_sc_hd__dlrtp_1  571.780  310.080  MX  PLACED  i_debug_regs.BREAK_BITS\[9\].ttlc_brk2_latch
i_debug_regs.ttlc_cache_invalidate  flop  sky130_fd_sc_hd__dfxtp_1  560.280  282.880  MX  PLACED  _33033_
i_debug_regs.ttlc_ce_ctrl[0]  flop  sky130_fd_sc_hd__dfxtp_1  437.460  312.800  R0  PLACED  _33015_
i_debug_regs.ttlc_ce_ctrl[1]  flop  sky130_fd_sc_hd__dfxtp_1  437.000  329.120  R0  PLACED  _33016_
i_debug_regs.ttlc_reset  flop  sky130_fd_sc_hd__dfxtp_1  577.760  342.720  MX  PLACED  _33031_
i_debug_regs.ttlc_run  flop  sky130_fd_sc_hd__dfxtp_1  586.040  326.400  MX  PLACED  _33043_
i_debug_regs.ttlc_shiftclk  flop  sky130_fd_sc_hd__dfxtp_1  570.400  345.440  R0  PLACED  _33032_
i_debug_regs.ttlc_skip  flop  sky130_fd_sc_hd__dfxtp_1  599.840  326.400  MX  PLACED  _33044_
i_debug_regs.ttlc_step  flop  sky130_fd_sc_hd__dfxtp_1  590.180  334.560  R0  PLACED  _33042_
i_inst_cache.cl_addr0[0]  flop  sky130_fd_sc_hd__dfxtp_1  495.880  223.040  MX  PLACED  _33045_
i_inst_cache.cl_addr0[10]  flop  sky130_fd_sc_hd__dfxtp_1  455.860  195.840  MX  PLACED  _33055_
i_inst_cache.cl_addr0[11]  flop  sky130_fd_sc_hd__dfxtp_1  480.700  176.800  R0  PLACED  _33056_
i_inst_cache.cl_addr0[12]  flop  sky130_fd_sc_hd__dfxtp_1  464.140  182.240  R0  PLACED  _33057_
i_inst_cache.cl_addr0[13]  flop  sky130_fd_sc_hd__dfxtp_1  456.320  198.560  R0  PLACED  _33058_
i_inst_cache.cl_addr0[14]  flop  sky130_fd_sc_hd__dfxtp_1  457.240  204.000  R0  PLACED  _33059_
i_inst_cache.cl_addr0[1]  flop  sky130_fd_sc_hd__dfxtp_1  488.520  220.320  R0  PLACED  _33046_
i_inst_cache.cl_addr0[2]  flop  sky130_fd_sc_hd__dfxtp_1  524.860  223.040  MX  PLACED  _33047_
i_inst_cache.cl_addr0[3]  flop  sky130_fd_sc_hd__dfxtp_1  510.600  223.040  MX  PLACED  _33048_
i_inst_cache.cl_addr0[4]  flop  sky130_fd_sc_hd__dfxtp_1  505.540  225.760  R0  PLACED  _33049_
i_inst_cache.cl_addr0[5]  flop  sky130_fd_sc_hd__dfxtp_1  530.840  217.600  MX  PLACED  _33050_
i_inst_cache.cl_addr0[6]  flop  sky130_fd_sc_hd__dfxtp_1  479.780  214.880  R0  PLACED  _33051_
i_inst_cache.cl_addr0[7]  flop  sky130_fd_sc_hd__dfxtp_1  468.740  206.720  MX  PLACED  _33052_
i_inst_cache.cl_addr0[8]  flop  sky130_fd_sc_hd__dfxtp_1  467.360  201.280  MX  PLACED  _33053_
i_inst_cache.cl_addr0[9]  flop  sky130_fd_sc_hd__dfxtp_1  446.200  204.000  R0  PLACED  _33054_
i_inst_cache.cl_inst0[0]  flop  sky130_fd_sc_hd__dfxtp_1  512.900  171.360  R0  PLACED  _33060_
i_inst_cache.cl_inst0[10]  flop  sky130_fd_sc_hd__dfxtp_1  454.480  182.240  R0  PLACED  _33070_
i_inst_cache.cl_inst0[11]  flop  sky130_fd_sc_hd__dfxtp_1  471.040  163.200  MX  PLACED  _33071_
i_inst_cache.cl_inst0[12]  flop  sky130_fd_sc_hd__dfxtp_1  468.740  155.040  R0  PLACED  _33072_
i_inst_cache.cl_inst0[13]  flop  sky130_fd_sc_hd__dfxtp_1  442.520  165.920  R0  PLACED  _33073_
i_inst_cache.cl_inst0[14]  flop  sky130_fd_sc_hd__dfxtp_1  444.820  198.560  R0  PLACED  _33074_
i_inst_cache.cl_inst0[15]  flop  sky130_fd_sc_hd__dfxtp_1  442.060  174.080  MX  PLACED  _33075_
i_inst_cache.cl_inst0[1]  flop  sky130_fd_sc_hd__dfxtp_1  509.680  179.520  MX  PLACED  _33061_
i_inst_cache.cl_inst0[2]  flop  sky130_fd_sc_hd__dfxtp_1  421.360  195.840  MX  PLACED  _33062_
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
i_inst_cache.cl_inst3[14]  flop  sky130_fd_sc_hd__dfxtp_1  442.520  179.520  MX  PLACED  _33122_
i_inst_cache.cl_inst3[15]  flop  sky130_fd_sc_hd__dfxtp_1  429.640  155.040  R0  PLACED  _33123_
i_inst_cache.cl_inst3[1]  flop  sky130_fd_sc_hd__dfxtp_1  533.140  179.520  MX  PLACED  _33109_
i_inst_cache.cl_inst3[2]  flop  sky130_fd_sc_hd__dfxtp_1  454.020  187.680  R0  PLACED  _33110_
i_inst_cache.cl_inst3[3]  flop  sky130_fd_sc_hd__dfxtp_1  519.340  163.200  MX  PLACED  _33111_
i_inst_cache.cl_inst3[4]  flop  sky130_fd_sc_hd__dfxtp_1  433.780  182.240  R0  PLACED  _33112_
i_inst_cache.cl_inst3[5]  flop  sky130_fd_sc_hd__dfxtp_1  462.300  171.360  R0  PLACED  _33113_
i_inst_cache.cl_inst3[6]  flop  sky130_fd_sc_hd__dfxtp_1  501.400  174.080  MX  PLACED  _33114_
i_inst_cache.cl_inst3[7]  flop  sky130_fd_sc_hd__dfxtp_1  461.380  155.040  R0  PLACED  _33115_
i_inst_cache.cl_inst3[8]  flop  sky130_fd_sc_hd__dfxtp_1  510.600  163.200  MX  PLACED  _33116_
i_inst_cache.cl_inst3[9]  flop  sky130_fd_sc_hd__dfxtp_1  532.220  155.040  R0  PLACED  _33117_
i_inst_cache.cl_set_valid  flop  sky130_fd_sc_hd__dfxtp_1  540.960  242.080  R0  PLACED  _34416_
i_inst_cache.cl_valid  flop  sky130_fd_sc_hd__dfxtp_1  520.720  239.360  MX  PLACED  _33124_
i_inst_cache.state[0]  flop  sky130_fd_sc_hd__dfxtp_1  523.020  244.800  MX  PLACED  _34413_
i_inst_cache.state[1]  flop  sky130_fd_sc_hd__dfxtp_1  540.960  247.520  R0  PLACED  _34414_
i_inst_cache.state[2]  flop  sky130_fd_sc_hd__dfxtp_1  533.600  247.520  R0  PLACED  _34415_
i_lisa_core.GEN_DIV.i_lisa_div.cflag  flop  sky130_fd_sc_hd__dfxtp_1  149.960  304.640  MX  PLACED  _33283_
i_lisa_core.GEN_DIV.i_lisa_div.cond  flop  sky130_fd_sc_hd__dfxtp_1  225.400  364.480  MX  PLACED  _33278_
i_lisa_core.GEN_DIV.i_lisa_div.div_finish  flop  sky130_fd_sc_hd__dfxtp_1  222.180  367.200  R0  PLACED  _34412_
i_lisa_core.GEN_DIV.i_lisa_div.div_rs1[0]  flop  sky130_fd_sc_hd__dfxtp_1  163.760  369.920  MX  PLACED  _34562_
i_lisa_core.GEN_DIV.i_lisa_div.div_rs1[1]  flop  sky130_fd_sc_hd__dfxtp_1  148.580  364.480  MX  PLACED  _32677_
i_lisa_core.GEN_DIV.i_lisa_div.div_rs1[2]  flop  sky130_fd_sc_hd__dfxtp_1  149.040  372.640  R0  PLACED  _32678_
i_lisa_core.GEN_DIV.i_lisa_div.div_rs1[3]  flop  sky130_fd_sc_hd__dfxtp_1  149.040  378.080  R0  PLACED  _32679_
i_lisa_core.GEN_DIV.i_lisa_div.div_rs1[4]  flop  sky130_fd_sc_hd__dfxtp_1  148.580  380.800  MX  PLACED  _32680_
i_lisa_core.GEN_DIV.i_lisa_div.div_rs1[5]  flop  sky130_fd_sc_hd__dfxtp_1  155.020  383.520  R0  PLACED  _32681_
i_lisa_core.GEN_DIV.i_lisa_div.div_rs1[6]  flop  sky130_fd_sc_hd__dfxtp_1  148.580  388.960  R0  PLACED  _32682_
i_lisa_core.GEN_DIV.i_lisa_div.div_rs1[7]  flop  sky130_fd_sc_hd__dfxtp_1  172.960  388.960  R0  PLACED  _32683_
i_lisa_core.GEN_DIV.i_lisa_div.div_rs2[0]  flop  sky130_fd_sc_hd__dfxtp_1  93.380  318.240  R0  PLACED  _33207_
i_lisa_core.GEN_DIV.i_lisa_div.div_rs2[1]  flop  sky130_fd_sc_hd__dfxtp_1  80.500  315.520  MX  PLACED  _33208_
i_lisa_core.GEN_DIV.i_lisa_div.div_rs2[2]  flop  sky130_fd_sc_hd__dfxtp_1  94.300  329.120  R0  PLACED  _33209_
i_lisa_core.GEN_DIV.i_lisa_div.div_rs2[3]  flop  sky130_fd_sc_hd__dfxtp_1  94.300  331.840  MX  PLACED  _33210_
i_lisa_core.GEN_DIV.i_lisa_div.div_rs2[4]  flop  sky130_fd_sc_hd__dfxtp_1  84.180  345.440  R0  PLACED  _33211_
i_lisa_core.GEN_DIV.i_lisa_div.div_rs2[5]  flop  sky130_fd_sc_hd__dfxtp_1  93.380  345.440  R0  PLACED  _33212_
i_lisa_core.GEN_DIV.i_lisa_div.div_rs2[6]  flop  sky130_fd_sc_hd__dfxtp_1  85.560  337.280  MX  PLACED  _33213_
i_lisa_core.GEN_DIV.i_lisa_div.div_rs2[7]  flop  sky130_fd_sc_hd__dfxtp_1  82.800  323.680  R0  PLACED  _33214_
i_lisa_core.GEN_DIV.i_lisa_div.ix_cond  flop  sky130_fd_sc_hd__dfxtp_1  166.980  408.000  MX  PLACED  _32689_
i_lisa_core.GEN_DIV.i_lisa_div.ldx_stage_two_r  flop  sky130_fd_sc_hd__dfxtp_1  162.840  301.920  R0  PLACED  _33281_
i_lisa_core.GEN_DIV.i_lisa_div.negate_output  flop  sky130_fd_sc_hd__dfxtp_1  193.200  386.240  MX  PLACED  _33280_
i_lisa_core.GEN_DIV.i_lisa_div.op_start  flop  sky130_fd_sc_hd__dfrtp_1  155.480  285.600  R0  PLACED  _34442_
i_lisa_core.GEN_DIV.i_lisa_div.signed_inversion  flop  sky130_fd_sc_hd__dfxtp_1  227.700  378.080  R0  PLACED  _33279_
i_lisa_core.GEN_DIV.i_lisa_div.state[0]  flop  sky130_fd_sc_hd__dfxtp_1  198.260  383.520  R0  PLACED  _34409_
i_lisa_core.GEN_DIV.i_lisa_div.state[1]  flop  sky130_fd_sc_hd__dfxtp_1  214.360  394.400  R0  PLACED  _34410_
i_lisa_core.GEN_DIV.i_lisa_div.state[2]  flop  sky130_fd_sc_hd__dfxtp_1  213.440  386.240  MX  PLACED  _34411_
i_lisa_core.GEN_DIV.i_lisa_div.zflag  flop  sky130_fd_sc_hd__dfxtp_1  157.780  293.760  MX  PLACED  _33282_
i_lisa_core.GEN_LISA_DBG.i_lisa_dbg.access_state[0]  flop  sky130_fd_sc_hd__dfxtp_1  385.940  258.400  R0  PLACED  _33308_
i_lisa_core.GEN_LISA_DBG.i_lisa_dbg.access_state[1]  flop  sky130_fd_sc_hd__dfxtp_1  374.440  261.120  MX  PLACED  _33309_
i_lisa_core.GEN_LISA_DBG.i_lisa_dbg.amode[0]  flop  sky130_fd_sc_hd__dfxtp_1  46.460  239.360  MX  PLACED  _33216_
i_lisa_core.GEN_LISA_DBG.i_lisa_dbg.amode[1]  flop  sky130_fd_sc_hd__dfxtp_1  70.380  236.640  R0  PLACED  _33217_
i_lisa_core.GEN_LISA_DBG.i_lisa_dbg.amode[2]  flop  sky130_fd_sc_hd__dfxtp_1  83.720  236.640  R0  PLACED  _33218_
i_lisa_core.GEN_LISA_DBG.i_lisa_dbg.brk_r0[0]  latch  sky130_fd_sc_hd__dlrtp_1  460.460  272.000  MX  PLACED  i_lisa_core.GEN_LISA_DBG.i_lisa_dbg.LISA_BRK_BITS\[0\].brk_r0_latch
i_lisa_core.GEN_LISA_DBG.i_lisa_dbg.brk_r0[10]  latch  sky130_fd_sc_hd__dlrtp_1  419.520  272.000  MX  PLACED  i_lisa_core.GEN_LISA_DBG.i_lisa_dbg.LISA_BRK_BITS\[10\].brk_r0_latch
i_lisa_core.GEN_LISA_DBG.i_lisa_dbg.brk_r0[11]  latch  sky130_fd_sc_hd__dlrtp_1  419.980  274.720  R0  PLACED  i_lisa_core.GEN_LISA_DBG.i_lisa_dbg.LISA_BRK_BITS\[11\].brk_r0_latch
i_lisa_core.GEN_LISA_DBG.i_lisa_dbg.brk_r0[12]  latch  sky130_fd_sc_hd__dlrtp_1  449.420  250.240  MX  PLACED  i_lisa_core.GEN_LISA_DBG.i_lisa_dbg.LISA_BRK_BITS\[12\].brk_r0_latch
i_lisa_core.GEN_LISA_DBG.i_lisa_dbg.brk_r0[13]  latch  sky130_fd_sc_hd__dlrtp_1  454.940  274.720  R0  PLACED  i_lisa_core.GEN_LISA_DBG.i_lisa_dbg.LISA_BRK_BITS\[13\].brk_r0_latch
i_lisa_core.GEN_LISA_DBG.i_lisa_dbg.brk_r0[14]  latch  sky130_fd_sc_hd__dlrtp_1  421.820  263.840  R0  PLACED  i_lisa_core.GEN_LISA_DBG.i_lisa_dbg.LISA_BRK_BITS\[14\].brk_r0_latch
i_lisa_core.GEN_LISA_DBG.i_lisa_dbg.brk_r0[15]  latch  sky130_fd_sc_hd__dlrtp_1  425.040  255.680  MX  PLACED  i_lisa_core.GEN_LISA_DBG.i_lisa_dbg.LISA_BRK_BITS\[15\].brk_r0_latch
i_lisa_core.GEN_LISA_DBG.i_lisa_dbg.brk_r0[1]  latch  sky130_fd_sc_hd__dlrtp_1  421.820  261.120  MX  PLACED  i_lisa_core.GEN_LISA_DBG.i_lisa_dbg.LISA_BRK_BITS\[1\].brk_r0_latch
i_lisa_core.GEN_LISA_DBG.i_lisa_dbg.brk_r0[2]  latch  sky130_fd_sc_hd__dlrtp_1  451.260  255.680  MX  PLACED  i_lisa_core.GEN_LISA_DBG.i_lisa_dbg.LISA_BRK_BITS\[2\].brk_r0_latch
i_lisa_core.GEN_LISA_DBG.i_lisa_dbg.brk_r0[3]  latch  sky130_fd_sc_hd__dlrtp_1  434.240  250.240  MX  PLACED  i_lisa_core.GEN_LISA_DBG.i_lisa_dbg.LISA_BRK_BITS\[3\].brk_r0_latch
i_lisa_core.GEN_LISA_DBG.i_lisa_dbg.brk_r0[4]  latch  sky130_fd_sc_hd__dlrtp_1  436.540  247.520  R0  PLACED  i_lisa_core.GEN_LISA_DBG.i_lisa_dbg.LISA_BRK_BITS\[4\].brk_r0_latch
i_lisa_core.GEN_LISA_DBG.i_lisa_dbg.brk_r0[5]  latch  sky130_fd_sc_hd__dlrtp_1  443.440  250.240  MX  PLACED  i_lisa_core.GEN_LISA_DBG.i_lisa_dbg.LISA_BRK_BITS\[5\].brk_r0_latch
i_lisa_core.GEN_LISA_DBG.i_lisa_dbg.brk_r0[6]  latch  sky130_fd_sc_hd__dlrtp_1  459.080  250.240  MX  PLACED  i_lisa_core.GEN_LISA_DBG.i_lisa_dbg.LISA_BRK_BITS\[6\].brk_r0_latch
i_lisa_core.GEN_LISA_DBG.i_lisa_dbg.brk_r0[7]  latch  sky130_fd_sc_hd__dlrtp_1  424.580  277.440  MX  PLACED  i_lisa_core.GEN_LISA_DBG.i_lisa_dbg.LISA_BRK_BITS\[7\].brk_r0_latch
i_lisa_core.GEN_LISA_DBG.i_lisa_dbg.brk_r0[8]  latch  sky130_fd_sc_hd__dlrtp_1  437.460  252.960  R0  PLACED  i_lisa_core.GEN_LISA_DBG.i_lisa_dbg.LISA_BRK_BITS\[8\].brk_r0_latch
i_lisa_core.GEN_LISA_DBG.i_lisa_dbg.brk_r0[9]  latch  sky130_fd_sc_hd__dlrtp_1  447.580  274.720  R0  PLACED  i_lisa_core.GEN_LISA_DBG.i_lisa_dbg.LISA_BRK_BITS\[9\].brk_r0_latch
i_lisa_core.GEN_LISA_DBG.i_lisa_dbg.brk_r1[0]  latch  sky130_fd_sc_hd__dlrtp_1  415.380  212.160  MX  PLACED  i_lisa_core.GEN_LISA_DBG.i_lisa_dbg.LISA_BRK_BITS\[0\].brk_r1_latch
i_lisa_core.GEN_LISA_DBG.i_lisa_dbg.brk_r1[10]  latch  sky130_fd_sc_hd__dlrtp_1  421.820  223.040  MX  PLACED  i_lisa_core.GEN_LISA_DBG.i_lisa_dbg.LISA_BRK_BITS\[10\].brk_r1_latch
i_lisa_core.GEN_LISA_DBG.i_lisa_dbg.brk_r1[11]  latch  sky130_fd_sc_hd__dlrtp_1  416.760  233.920  MX  PLACED  i_lisa_core.GEN_LISA_DBG.i_lisa_dbg.LISA_BRK_BITS\[11\].brk_r1_latch
i_lisa_core.GEN_LISA_DBG.i_lisa_dbg.brk_r1[12]  latch  sky130_fd_sc_hd__dlrtp_1  446.200  242.080  R0  PLACED  i_lisa_core.GEN_LISA_DBG.i_lisa_dbg.LISA_BRK_BITS\[12\].brk_r1_latch
i_lisa_core.GEN_LISA_DBG.i_lisa_dbg.brk_r1[13]  latch  sky130_fd_sc_hd__dlrtp_1  413.540  209.440  R0  PLACED  i_lisa_core.GEN_LISA_DBG.i_lisa_dbg.LISA_BRK_BITS\[13\].brk_r1_latch
i_lisa_core.GEN_LISA_DBG.i_lisa_dbg.brk_r1[14]  latch  sky130_fd_sc_hd__dlrtp_1  428.260  247.520  R0  PLACED  i_lisa_core.GEN_LISA_DBG.i_lisa_dbg.LISA_BRK_BITS\[14\].brk_r1_latch
i_lisa_core.GEN_LISA_DBG.i_lisa_dbg.brk_r1[15]  latch  sky130_fd_sc_hd__dlrtp_1  422.280  212.160  MX  PLACED  i_lisa_core.GEN_LISA_DBG.i_lisa_dbg.LISA_BRK_BITS\[15\].brk_r1_latch
i_lisa_core.GEN_LISA_DBG.i_lisa_dbg.brk_r1[1]  latch  sky130_fd_sc_hd__dlrtp_1  423.660  217.600  MX  PLACED  i_lisa_core.GEN_LISA_DBG.i_lisa_dbg.LISA_BRK_BITS\[1\].brk_r1_latch
i_lisa_core.GEN_LISA_DBG.i_lisa_dbg.brk_r1[2]  latch  sky130_fd_sc_hd__dlrtp_1  415.380  223.040  MX  PLACED  i_lisa_core.GEN_LISA_DBG.i_lisa_dbg.LISA_BRK_BITS\[2\].brk_r1_latch
i_lisa_core.GEN_LISA_DBG.i_lisa_dbg.brk_r1[3]  latch  sky130_fd_sc_hd__dlrtp_1  431.940  231.200  R0  PLACED  i_lisa_core.GEN_LISA_DBG.i_lisa_dbg.LISA_BRK_BITS\[3\].brk_r1_latch
i_lisa_core.GEN_LISA_DBG.i_lisa_dbg.brk_r1[4]  latch  sky130_fd_sc_hd__dlrtp_1  441.140  233.920  MX  PLACED  i_lisa_core.GEN_LISA_DBG.i_lisa_dbg.LISA_BRK_BITS\[4\].brk_r1_latch
i_lisa_core.GEN_LISA_DBG.i_lisa_dbg.brk_r1[5]  latch  sky130_fd_sc_hd__dlrtp_1  444.820  228.480  MX  PLACED  i_lisa_core.GEN_LISA_DBG.i_lisa_dbg.LISA_BRK_BITS\[5\].brk_r1_latch
i_lisa_core.GEN_LISA_DBG.i_lisa_dbg.brk_r1[6]  latch  sky130_fd_sc_hd__dlrtp_1  412.620  204.000  R0  PLACED  i_lisa_core.GEN_LISA_DBG.i_lisa_dbg.LISA_BRK_BITS\[6\].brk_r1_latch
i_lisa_core.GEN_LISA_DBG.i_lisa_dbg.brk_r1[7]  latch  sky130_fd_sc_hd__dlrtp_1  432.860  206.720  MX  PLACED  i_lisa_core.GEN_LISA_DBG.i_lisa_dbg.LISA_BRK_BITS\[7\].brk_r1_latch
i_lisa_core.GEN_LISA_DBG.i_lisa_dbg.brk_r1[8]  latch  sky130_fd_sc_hd__dlrtp_1  441.600  206.720  MX  PLACED  i_lisa_core.GEN_LISA_DBG.i_lisa_dbg.LISA_BRK_BITS\[8\].brk_r1_latch
i_lisa_core.GEN_LISA_DBG.i_lisa_dbg.brk_r1[9]  latch  sky130_fd_sc_hd__dlrtp_1  434.700  239.360  MX  PLACED  i_lisa_core.GEN_LISA_DBG.i_lisa_dbg.LISA_BRK_BITS\[9\].brk_r1_latch
i_lisa_core.GEN_LISA_DBG.i_lisa_dbg.brk_r2[0]  latch  sky130_fd_sc_hd__dlrtp_1  471.500  217.600  MX  PLACED  i_lisa_core.GEN_LISA_DBG.i_lisa_dbg.LISA_BRK_BITS\[0\].brk_r2_latch
i_lisa_core.GEN_LISA_DBG.i_lisa_dbg.brk_r2[10]  latch  sky130_fd_sc_hd__dlrtp_1  480.240  223.040  MX  PLACED  i_lisa_core.GEN_LISA_DBG.i_lisa_dbg.LISA_BRK_BITS\[10\].brk_r2_latch
i_lisa_core.GEN_LISA_DBG.i_lisa_dbg.brk_r2[11]  latch  sky130_fd_sc_hd__dlrtp_1  479.780  231.200  R0  PLACED  i_lisa_core.GEN_LISA_DBG.i_lisa_dbg.LISA_BRK_BITS\[11\].brk_r2_latch
i_lisa_core.GEN_LISA_DBG.i_lisa_dbg.brk_r2[12]  latch  sky130_fd_sc_hd__dlrtp_1  454.020  242.080  R0  PLACED  i_lisa_core.GEN_LISA_DBG.i_lisa_dbg.LISA_BRK_BITS\[12\].brk_r2_latch
i_lisa_core.GEN_LISA_DBG.i_lisa_dbg.brk_r2[13]  latch  sky130_fd_sc_hd__dlrtp_1  466.900  212.160  MX  PLACED  i_lisa_core.GEN_LISA_DBG.i_lisa_dbg.LISA_BRK_BITS\[13\].brk_r2_latch
i_lisa_core.GEN_LISA_DBG.i_lisa_dbg.brk_r2[14]  latch  sky130_fd_sc_hd__dlrtp_1  469.200  233.920  MX  PLACED  i_lisa_core.GEN_LISA_DBG.i_lisa_dbg.LISA_BRK_BITS\[14\].brk_r2_latch
i_lisa_core.GEN_LISA_DBG.i_lisa_dbg.brk_r2[15]  latch  sky130_fd_sc_hd__dlrtp_1  452.180  228.480  MX  PLACED  i_lisa_core.GEN_LISA_DBG.i_lisa_dbg.LISA_BRK_BITS\[15\].brk_r2_latch
i_lisa_core.GEN_LISA_DBG.i_lisa_dbg.brk_r2[1]  latch  sky130_fd_sc_hd__dlrtp_1  450.800  212.160  MX  PLACED  i_lisa_core.GEN_LISA_DBG.i_lisa_dbg.LISA_BRK_BITS\[1\].brk_r2_latch
i_lisa_core.GEN_LISA_DBG.i_lisa_dbg.brk_r2[2]  latch  sky130_fd_sc_hd__dlrtp_1  452.640  223.040  MX  PLACED  i_lisa_core.GEN_LISA_DBG.i_lisa_dbg.LISA_BRK_BITS\[2\].brk_r2_latch
i_lisa_core.GEN_LISA_DBG.i_lisa_dbg.brk_r2[3]  latch  sky130_fd_sc_hd__dlrtp_1  470.580  231.200  R0  PLACED  i_lisa_core.GEN_LISA_DBG.i_lisa_dbg.LISA_BRK_BITS\[3\].brk_r2_latch
i_lisa_core.GEN_LISA_DBG.i_lisa_dbg.brk_r2[4]  latch  sky130_fd_sc_hd__dlrtp_1  451.260  233.920  MX  PLACED  i_lisa_core.GEN_LISA_DBG.i_lisa_dbg.LISA_BRK_BITS\[4\].brk_r2_latch
i_lisa_core.GEN_LISA_DBG.i_lisa_dbg.brk_r2[5]  latch  sky130_fd_sc_hd__dlrtp_1  481.160  228.480  MX  PLACED  i_lisa_core.GEN_LISA_DBG.i_lisa_dbg.LISA_BRK_BITS\[5\].brk_r2_latch
i_lisa_core.GEN_LISA_DBG.i_lisa_dbg.brk_r2[6]  latch  sky130_fd_sc_hd__dlrtp_1  458.620  212.160  MX  PLACED  i_lisa_core.GEN_LISA_DBG.i_lisa_dbg.LISA_BRK_BITS\[6\].brk_r2_latch
i_lisa_core.GEN_LISA_DBG.i_lisa_dbg.brk_r2[7]  latch  sky130_fd_sc_hd__dlrtp_1  454.020  209.440  R0  PLACED  i_lisa_core.GEN_LISA_DBG.i_lisa_dbg.LISA_BRK_BITS\[7\].brk_r2_latch
i_lisa_core.GEN_LISA_DBG.i_lisa_dbg.brk_r2[8]  latch  sky130_fd_sc_hd__dlrtp_1  451.720  206.720  MX  PLACED  i_lisa_core.GEN_LISA_DBG.i_lisa_dbg.LISA_BRK_BITS\[8\].brk_r2_latch
i_lisa_core.GEN_LISA_DBG.i_lisa_dbg.brk_r2[9]  latch  sky130_fd_sc_hd__dlrtp_1  458.160  239.360  MX  PLACED  i_lisa_core.GEN_LISA_DBG.i_lisa_dbg.LISA_BRK_BITS\[9\].brk_r2_latch
i_lisa_core.GEN_LISA_DBG.i_lisa_dbg.brk_r3[0]  latch  sky130_fd_sc_hd__dlrtp_1  368.000  212.160  MX  PLACED  i_lisa_core.GEN_LISA_DBG.i_lisa_dbg.LISA_BRK_BITS\[0\].brk_r3_latch
i_lisa_core.GEN_LISA_DBG.i_lisa_dbg.brk_r3[10]  latch  sky130_fd_sc_hd__dlrtp_1  395.140  263.840  R0  PLACED  i_lisa_core.GEN_LISA_DBG.i_lisa_dbg.LISA_BRK_BITS\[10\].brk_r3_latch
i_lisa_core.GEN_LISA_DBG.i_lisa_dbg.brk_r3[11]  latch  sky130_fd_sc_hd__dlrtp_1  378.580  236.640  R0  PLACED  i_lisa_core.GEN_LISA_DBG.i_lisa_dbg.LISA_BRK_BITS\[11\].brk_r3_latch
i_lisa_core.GEN_LISA_DBG.i_lisa_dbg.brk_r3[12]  latch  sky130_fd_sc_hd__dlrtp_1  395.600  239.360  MX  PLACED  i_lisa_core.GEN_LISA_DBG.i_lisa_dbg.LISA_BRK_BITS\[12\].brk_r3_latch
i_lisa_core.GEN_LISA_DBG.i_lisa_dbg.brk_r3[13]  latch  sky130_fd_sc_hd__dlrtp_1  377.200  212.160  MX  PLACED  i_lisa_core.GEN_LISA_DBG.i_lisa_dbg.LISA_BRK_BITS\[13\].brk_r3_latch
i_lisa_core.GEN_LISA_DBG.i_lisa_dbg.brk_r3[14]  latch  sky130_fd_sc_hd__dlrtp_1  383.180  233.920  MX  PLACED  i_lisa_core.GEN_LISA_DBG.i_lisa_dbg.LISA_BRK_BITS\[14\].brk_r3_latch
i_lisa_core.GEN_LISA_DBG.i_lisa_dbg.brk_r3[15]  latch  sky130_fd_sc_hd__dlrtp_1  396.060  231.200  R0  PLACED  i_lisa_core.GEN_LISA_DBG.i_lisa_dbg.LISA_BRK_BITS\[15\].brk_r3_latch
i_lisa_core.GEN_LISA_DBG.i_lisa_dbg.brk_r3[1]  latch  sky130_fd_sc_hd__dlrtp_1  368.920  214.880  R0  PLACED  i_lisa_core.GEN_LISA_DBG.i_lisa_dbg.LISA_BRK_BITS\[1\].brk_r3_latch
i_lisa_core.GEN_LISA_DBG.i_lisa_dbg.brk_r3[2]  latch  sky130_fd_sc_hd__dlrtp_1  372.600  223.040  MX  PLACED  i_lisa_core.GEN_LISA_DBG.i_lisa_dbg.LISA_BRK_BITS\[2\].brk_r3_latch
i_lisa_core.GEN_LISA_DBG.i_lisa_dbg.brk_r3[3]  latch  sky130_fd_sc_hd__dlrtp_1  373.520  228.480  MX  PLACED  i_lisa_core.GEN_LISA_DBG.i_lisa_dbg.LISA_BRK_BITS\[3\].brk_r3_latch
i_lisa_core.GEN_LISA_DBG.i_lisa_dbg.brk_r3[4]  latch  sky130_fd_sc_hd__dlrtp_1  376.740  239.360  MX  PLACED  i_lisa_core.GEN_LISA_DBG.i_lisa_dbg.LISA_BRK_BITS\[4\].brk_r3_latch
i_lisa_core.GEN_LISA_DBG.i_lisa_dbg.brk_r3[5]  latch  sky130_fd_sc_hd__dlrtp_1  370.300  236.640  R0  PLACED  i_lisa_core.GEN_LISA_DBG.i_lisa_dbg.LISA_BRK_BITS\[5\].brk_r3_latch
i_lisa_core.GEN_LISA_DBG.i_lisa_dbg.brk_r3[6]  latch  sky130_fd_sc_hd__dlrtp_1  376.740  209.440  R0  PLACED  i_lisa_core.GEN_LISA_DBG.i_lisa_dbg.LISA_BRK_BITS\[6\].brk_r3_latch
i_lisa_core.GEN_LISA_DBG.i_lisa_dbg.brk_r3[7]  latch  sky130_fd_sc_hd__dlrtp_1  383.180  206.720  MX  PLACED  i_lisa_core.GEN_LISA_DBG.i_lisa_dbg.LISA_BRK_BITS\[7\].brk_r3_latch
i_lisa_core.GEN_LISA_DBG.i_lisa_dbg.brk_r3[8]  latch  sky130_fd_sc_hd__dlrtp_1  407.100  206.720  MX  PLACED  i_lisa_core.GEN_LISA_DBG.i_lisa_dbg.LISA_BRK_BITS\[8\].brk_r3_latch
i_lisa_core.GEN_LISA_DBG.i_lisa_dbg.brk_r3[9]  latch  sky130_fd_sc_hd__dlrtp_1  382.720  239.360  MX  PLACED  i_lisa_core.GEN_LISA_DBG.i_lisa_dbg.LISA_BRK_BITS\[9\].brk_r3_latch
i_lisa_core.GEN_LISA_DBG.i_lisa_dbg.brk_r4[0]  latch  sky130_fd_sc_hd__dlrtp_1  400.660  261.120  MX  PLACED  i_lisa_core.GEN_LISA_DBG.i_lisa_dbg.LISA_BRK_BITS\[0\].brk_r4_latch
i_lisa_core.GEN_LISA_DBG.i_lisa_dbg.brk_r4[10]  latch  sky130_fd_sc_hd__dlrtp_1  408.020  225.760  R0  PLACED  i_lisa_core.GEN_LISA_DBG.i_lisa_dbg.LISA_BRK_BITS\[10\].brk_r4_latch
i_lisa_core.GEN_LISA_DBG.i_lisa_dbg.brk_r4[11]  latch  sky130_fd_sc_hd__dlrtp_1  388.700  247.520  R0  PLACED  i_lisa_core.GEN_LISA_DBG.i_lisa_dbg.LISA_BRK_BITS\[11\].brk_r4_latch
i_lisa_core.GEN_LISA_DBG.i_lisa_dbg.brk_r4[12]  latch  sky130_fd_sc_hd__dlrtp_1  389.620  250.240  MX  PLACED  i_lisa_core.GEN_LISA_DBG.i_lisa_dbg.LISA_BRK_BITS\[12\].brk_r4_latch
i_lisa_core.GEN_LISA_DBG.i_lisa_dbg.brk_r4[13]  latch  sky130_fd_sc_hd__dlrtp_1  404.800  228.480  MX  PLACED  i_lisa_core.GEN_LISA_DBG.i_lisa_dbg.LISA_BRK_BITS\[13\].brk_r4_latch
i_lisa_core.GEN_LISA_DBG.i_lisa_dbg.brk_r4[14]  latch  sky130_fd_sc_hd__dlrtp_1  403.880  233.920  MX  PLACED  i_lisa_core.GEN_LISA_DBG.i_lisa_dbg.LISA_BRK_BITS\[14\].brk_r4_latch
i_lisa_core.GEN_LISA_DBG.i_lisa_dbg.brk_r4[15]  latch  sky130_fd_sc_hd__dlrtp_1  408.940  255.680  MX  PLACED  i_lisa_core.GEN_LISA_DBG.i_lisa_dbg.LISA_BRK_BITS\[15\].brk_r4_latch
i_lisa_core.GEN_LISA_DBG.i_lisa_dbg.brk_r4[1]  latch  sky130_fd_sc_hd__dlrtp_1  403.880  258.400  R0  PLACED  i_lisa_core.GEN_LISA_DBG.i_lisa_dbg.LISA_BRK_BITS\[1\].brk_r4_latch
i_lisa_core.GEN_LISA_DBG.i_lisa_dbg.brk_r4[2]  latch  sky130_fd_sc_hd__dlrtp_1  396.980  255.680  MX  PLACED  i_lisa_core.GEN_LISA_DBG.i_lisa_dbg.LISA_BRK_BITS\[2\].brk_r4_latch
i_lisa_core.GEN_LISA_DBG.i_lisa_dbg.brk_r4[3]  latch  sky130_fd_sc_hd__dlrtp_1  387.780  242.080  R0  PLACED  i_lisa_core.GEN_LISA_DBG.i_lisa_dbg.LISA_BRK_BITS\[3\].brk_r4_latch
i_lisa_core.GEN_LISA_DBG.i_lisa_dbg.brk_r4[4]  latch  sky130_fd_sc_hd__dlrtp_1  407.560  242.080  R0  PLACED  i_lisa_core.GEN_LISA_DBG.i_lisa_dbg.LISA_BRK_BITS\[4\].brk_r4_latch
i_lisa_core.GEN_LISA_DBG.i_lisa_dbg.brk_r4[5]  latch  sky130_fd_sc_hd__dlrtp_1  389.620  236.640  R0  PLACED  i_lisa_core.GEN_LISA_DBG.i_lisa_dbg.LISA_BRK_BITS\[5\].brk_r4_latch
i_lisa_core.GEN_LISA_DBG.i_lisa_dbg.brk_r4[6]  latch  sky130_fd_sc_hd__dlrtp_1  389.620  239.360  MX  PLACED  i_lisa_core.GEN_LISA_DBG.i_lisa_dbg.LISA_BRK_BITS\[6\].brk_r4_latch
i_lisa_core.GEN_LISA_DBG.i_lisa_dbg.brk_r4[7]  latch  sky130_fd_sc_hd__dlrtp_1  413.540  231.200  R0  PLACED  i_lisa_core.GEN_LISA_DBG.i_lisa_dbg.LISA_BRK_BITS\[7\].brk_r4_latch
i_lisa_core.GEN_LISA_DBG.i_lisa_dbg.brk_r4[8]  latch  sky130_fd_sc_hd__dlrtp_1  407.560  231.200  R0  PLACED  i_lisa_core.GEN_LISA_DBG.i_lisa_dbg.LISA_BRK_BITS\[8\].brk_r4_latch
i_lisa_core.GEN_LISA_DBG.i_lisa_dbg.brk_r4[9]  latch  sky130_fd_sc_hd__dlrtp_1  409.400  247.520  R0  PLACED  i_lisa_core.GEN_LISA_DBG.i_lisa_dbg.LISA_BRK_BITS\[9\].brk_r4_latch
i_lisa_core.GEN_LISA_DBG.i_lisa_dbg.brk_r5[0]  latch  sky130_fd_sc_hd__dlrtp_1  472.420  263.840  R0  PLACED  i_lisa_core.GEN_LISA_DBG.i_lisa_dbg.LISA_BRK_BITS\[0\].brk_r5_latch
i_lisa_core.GEN_LISA_DBG.i_lisa_dbg.brk_r5[10]  latch  sky130_fd_sc_hd__dlrtp_1  468.280  266.560  MX  PLACED  i_lisa_core.GEN_LISA_DBG.i_lisa_dbg.LISA_BRK_BITS\[10\].brk_r5_latch
i_lisa_core.GEN_LISA_DBG.i_lisa_dbg.brk_r5[11]  latch  sky130_fd_sc_hd__dlrtp_1  489.900  236.640  R0  PLACED  i_lisa_core.GEN_LISA_DBG.i_lisa_dbg.LISA_BRK_BITS\[11\].brk_r5_latch
i_lisa_core.GEN_LISA_DBG.i_lisa_dbg.brk_r5[12]  latch  sky130_fd_sc_hd__dlrtp_1  472.880  242.080  R0  PLACED  i_lisa_core.GEN_LISA_DBG.i_lisa_dbg.LISA_BRK_BITS\[12\].brk_r5_latch
i_lisa_core.GEN_LISA_DBG.i_lisa_dbg.brk_r5[13]  latch  sky130_fd_sc_hd__dlrtp_1  464.600  274.720  R0  PLACED  i_lisa_core.GEN_LISA_DBG.i_lisa_dbg.LISA_BRK_BITS\[13\].brk_r5_latch
i_lisa_core.GEN_LISA_DBG.i_lisa_dbg.brk_r5[14]  latch  sky130_fd_sc_hd__dlrtp_1  464.600  252.960  R0  PLACED  i_lisa_core.GEN_LISA_DBG.i_lisa_dbg.LISA_BRK_BITS\[14\].brk_r5_latch
i_lisa_core.GEN_LISA_DBG.i_lisa_dbg.brk_r5[15]  latch  sky130_fd_sc_hd__dlrtp_1  479.780  255.680  MX  PLACED  i_lisa_core.GEN_LISA_DBG.i_lisa_dbg.LISA_BRK_BITS\[15\].brk_r5_latch
i_lisa_core.GEN_LISA_DBG.i_lisa_dbg.brk_r5[1]  latch  sky130_fd_sc_hd__dlrtp_1  470.580  261.120  MX  PLACED  i_lisa_core.GEN_LISA_DBG.i_lisa_dbg.LISA_BRK_BITS\[1\].brk_r5_latch
i_lisa_core.GEN_LISA_DBG.i_lisa_dbg.brk_r5[2]  latch  sky130_fd_sc_hd__dlrtp_1  486.220  250.240  MX  PLACED  i_lisa_core.GEN_LISA_DBG.i_lisa_dbg.LISA_BRK_BITS\[2\].brk_r5_latch
i_lisa_core.GEN_LISA_DBG.i_lisa_dbg.brk_r5[3]  latch  sky130_fd_sc_hd__dlrtp_1  473.340  236.640  R0  PLACED  i_lisa_core.GEN_LISA_DBG.i_lisa_dbg.LISA_BRK_BITS\[3\].brk_r5_latch
i_lisa_core.GEN_LISA_DBG.i_lisa_dbg.brk_r5[4]  latch  sky130_fd_sc_hd__dlrtp_1  493.580  233.920  MX  PLACED  i_lisa_core.GEN_LISA_DBG.i_lisa_dbg.LISA_BRK_BITS\[4\].brk_r5_latch
i_lisa_core.GEN_LISA_DBG.i_lisa_dbg.brk_r5[5]  latch  sky130_fd_sc_hd__dlrtp_1  482.080  236.640  R0  PLACED  i_lisa_core.GEN_LISA_DBG.i_lisa_dbg.LISA_BRK_BITS\[5\].brk_r5_latch
i_lisa_core.GEN_LISA_DBG.i_lisa_dbg.brk_r5[6]  latch  sky130_fd_sc_hd__dlrtp_1  493.580  247.520  R0  PLACED  i_lisa_core.GEN_LISA_DBG.i_lisa_dbg.LISA_BRK_BITS\[6\].brk_r5_latch
i_lisa_core.GEN_LISA_DBG.i_lisa_dbg.brk_r5[7]  latch  sky130_fd_sc_hd__dlrtp_1  465.060  258.400  R0  PLACED  i_lisa_core.GEN_LISA_DBG.i_lisa_dbg.LISA_BRK_BITS\[7\].brk_r5_latch
i_lisa_core.GEN_LISA_DBG.i_lisa_dbg.brk_r5[8]  latch  sky130_fd_sc_hd__dlrtp_1  482.540  233.920  MX  PLACED  i_lisa_core.GEN_LISA_DBG.i_lisa_dbg.LISA_BRK_BITS\[8\].brk_r5_latch
i_lisa_core.GEN_LISA_DBG.i_lisa_dbg.brk_r5[9]  latch  sky130_fd_sc_hd__dlrtp_1  494.040  239.360  MX  PLACED  i_lisa_core.GEN_LISA_DBG.i_lisa_dbg.LISA_BRK_BITS\[9\].brk_r5_latch
i_lisa_core.GEN_LISA_DBG.i_lisa_dbg.cont_q_r  flop  sky130_fd_sc_hd__dfxtp_1  391.000  277.440  MX  PLACED  _33302_
i_lisa_core.GEN_LISA_DBG.i_lisa_dbg.d_access_r  flop  sky130_fd_sc_hd__dfxtp_1  365.700  266.560  MX  PLACED  _33306_
i_lisa_core.GEN_LISA_DBG.i_lisa_dbg.d_active_r  flop  sky130_fd_sc_hd__dfxtp_1  367.540  282.880  MX  PLACED  _33307_
i_lisa_core.GEN_LISA_DBG.i_lisa_dbg.d_addr[0]  flop  sky130_fd_sc_hd__dfxtp_1  330.280  250.240  MX  PLACED  _33285_
i_lisa_core.GEN_LISA_DBG.i_lisa_dbg.d_addr[10]  flop  sky130_fd_sc_hd__dfxtp_1  341.320  263.840  R0  PLACED  _33295_
i_lisa_core.GEN_LISA_DBG.i_lisa_dbg.d_addr[11]  flop  sky130_fd_sc_hd__dfxtp_1  332.580  263.840  R0  PLACED  _33296_
i_lisa_core.GEN_LISA_DBG.i_lisa_dbg.d_addr[12]  flop  sky130_fd_sc_hd__dfxtp_1  335.340  269.280  R0  PLACED  _33297_
i_lisa_core.GEN_LISA_DBG.i_lisa_dbg.d_addr[13]  flop  sky130_fd_sc_hd__dfxtp_1  345.000  272.000  MX  PLACED  _33298_
i_lisa_core.GEN_LISA_DBG.i_lisa_dbg.d_addr[14]  flop  sky130_fd_sc_hd__dfxtp_1  355.120  266.560  MX  PLACED  _33299_
i_lisa_core.GEN_LISA_DBG.i_lisa_dbg.d_addr[1]  flop  sky130_fd_sc_hd__dfxtp_1  330.280  258.400  R0  PLACED  _33286_
i_lisa_core.GEN_LISA_DBG.i_lisa_dbg.d_addr[2]  flop  sky130_fd_sc_hd__dfxtp_1  328.440  242.080  R0  PLACED  _33287_
i_lisa_core.GEN_LISA_DBG.i_lisa_dbg.d_addr[3]  flop  sky130_fd_sc_hd__dfxtp_1  345.920  233.920  MX  PLACED  _33288_
i_lisa_core.GEN_LISA_DBG.i_lisa_dbg.d_addr[4]  flop  sky130_fd_sc_hd__dfxtp_1  328.900  236.640  R0  PLACED  _33289_
i_lisa_core.GEN_LISA_DBG.i_lisa_dbg.d_addr[5]  flop  sky130_fd_sc_hd__dfxtp_1  338.100  228.480  MX  PLACED  _33290_
i_lisa_core.GEN_LISA_DBG.i_lisa_dbg.d_addr[6]  flop  sky130_fd_sc_hd__dfxtp_1  368.460  239.360  MX  PLACED  _33291_
i_lisa_core.GEN_LISA_DBG.i_lisa_dbg.d_addr[7]  flop  sky130_fd_sc_hd__dfxtp_1  360.180  236.640  R0  PLACED  _33292_
i_lisa_core.GEN_LISA_DBG.i_lisa_dbg.d_addr[8]  flop  sky130_fd_sc_hd__dfxtp_1  346.840  244.800  MX  PLACED  _33293_
i_lisa_core.GEN_LISA_DBG.i_lisa_dbg.d_addr[9]  flop  sky130_fd_sc_hd__dfxtp_1  340.860  252.960  R0  PLACED  _33294_
i_lisa_core.GEN_LISA_DBG.i_lisa_dbg.d_periph  flop  sky130_fd_sc_hd__dfxtp_1  356.040  255.680  MX  PLACED  _33300_
i_lisa_core.GEN_LISA_DBG.i_lisa_dbg.d_rd  flop  sky130_fd_sc_hd__dfxtp_1  373.520  266.560  MX  PLACED  _33284_
i_lisa_core.GEN_LISA_DBG.i_lisa_dbg.delay[0]  flop  sky130_fd_sc_hd__dfxtp_1  366.620  250.240  MX  PLACED  _33310_
i_lisa_core.GEN_LISA_DBG.i_lisa_dbg.delay[1]  flop  sky130_fd_sc_hd__dfxtp_1  376.280  244.800  MX  PLACED  _33311_
i_lisa_core.GEN_LISA_DBG.i_lisa_dbg.f0[0]  flop  sky130_fd_sc_hd__dfxtp_1  177.100  220.320  R0  PLACED  _33141_
i_lisa_core.GEN_LISA_DBG.i_lisa_dbg.f0[10]  flop  sky130_fd_sc_hd__dfxtp_1  276.920  212.160  MX  PLACED  _33151_
i_lisa_core.GEN_LISA_DBG.i_lisa_dbg.f0[11]  flop  sky130_fd_sc_hd__dfxtp_1  218.960  217.600  MX  PLACED  _33152_
i_lisa_core.GEN_LISA_DBG.i_lisa_dbg.f0[12]  flop  sky130_fd_sc_hd__dfxtp_1  244.720  217.600  MX  PLACED  _33153_
i_lisa_core.GEN_LISA_DBG.i_lisa_dbg.f0[13]  flop  sky130_fd_sc_hd__dfxtp_1  245.640  223.040  MX  PLACED  _33154_
i_lisa_core.GEN_LISA_DBG.i_lisa_dbg.f0[14]  flop  sky130_fd_sc_hd__dfxtp_1  197.340  225.760  R0  PLACED  _33155_
i_lisa_core.GEN_LISA_DBG.i_lisa_dbg.f0[15]  flop  sky130_fd_sc_hd__dfxtp_1  159.620  239.360  MX  PLACED  _33140_
i_lisa_core.GEN_LISA_DBG.i_lisa_dbg.f0[1]  flop  sky130_fd_sc_hd__dfxtp_1  54.740  228.480  MX  PLACED  _33142_
i_lisa_core.GEN_LISA_DBG.i_lisa_dbg.f0[2]  flop  sky130_fd_sc_hd__dfxtp_1  54.740  184.960  MX  PLACED  _33143_
i_lisa_core.GEN_LISA_DBG.i_lisa_dbg.f0[3]  flop  sky130_fd_sc_hd__dfxtp_1  59.800  206.720  MX  PLACED  _33144_
i_lisa_core.GEN_LISA_DBG.i_lisa_dbg.f0[4]  flop  sky130_fd_sc_hd__dfxtp_1  75.900  187.680  R0  PLACED  _33145_
i_lisa_core.GEN_LISA_DBG.i_lisa_dbg.f0[5]  flop  sky130_fd_sc_hd__dfxtp_1  160.080  220.320  R0  PLACED  _33146_
i_lisa_core.GEN_LISA_DBG.i_lisa_dbg.f0[6]  flop  sky130_fd_sc_hd__dfxtp_1  59.340  182.240  R0  PLACED  _33147_
i_lisa_core.GEN_LISA_DBG.i_lisa_dbg.f0[7]  flop  sky130_fd_sc_hd__dfxtp_1  59.340  223.040  MX  PLACED  _33148_
i_lisa_core.GEN_LISA_DBG.i_lisa_dbg.f0[8]  flop  sky130_fd_sc_hd__dfxtp_1  212.520  212.160  MX  PLACED  _33149_
i_lisa_core.GEN_LISA_DBG.i_lisa_dbg.f0[9]  flop  sky130_fd_sc_hd__dfxtp_1  276.920  206.720  MX  PLACED  _33150_
i_lisa_core.GEN_LISA_DBG.i_lisa_dbg.f1[0]  flop  sky130_fd_sc_hd__dfxtp_1  172.960  228.480  MX  PLACED  _33157_
i_lisa_core.GEN_LISA_DBG.i_lisa_dbg.f1[10]  flop  sky130_fd_sc_hd__dfxtp_1  261.740  214.880  R0  PLACED  _33167_
i_lisa_core.GEN_LISA_DBG.i_lisa_dbg.f1[11]  flop  sky130_fd_sc_hd__dfxtp_1  207.000  225.760  R0  PLACED  _33168_
i_lisa_core.GEN_LISA_DBG.i_lisa_dbg.f1[12]  flop  sky130_fd_sc_hd__dfxtp_1  226.320  223.040  MX  PLACED  _33169_
i_lisa_core.GEN_LISA_DBG.i_lisa_dbg.f1[13]  flop  sky130_fd_sc_hd__dfxtp_1  225.860  228.480  MX  PLACED  _33170_
i_lisa_core.GEN_LISA_DBG.i_lisa_dbg.f1[14]  flop  sky130_fd_sc_hd__dfxtp_1  209.760  233.920  MX  PLACED  _33171_
i_lisa_core.GEN_LISA_DBG.i_lisa_dbg.f1[15]  flop  sky130_fd_sc_hd__dfxtp_1  147.660  242.080  R0  PLACED  _33156_
i_lisa_core.GEN_LISA_DBG.i_lisa_dbg.f1[1]  flop  sky130_fd_sc_hd__dfxtp_1  61.180  233.920  MX  PLACED  _33158_
i_lisa_core.GEN_LISA_DBG.i_lisa_dbg.f1[2]  flop  sky130_fd_sc_hd__dfxtp_1  52.900  198.560  R0  PLACED  _33159_
i_lisa_core.GEN_LISA_DBG.i_lisa_dbg.f1[3]  flop  sky130_fd_sc_hd__dfxtp_1  54.740  212.160  MX  PLACED  _33160_
i_lisa_core.GEN_LISA_DBG.i_lisa_dbg.f1[4]  flop  sky130_fd_sc_hd__dfxtp_1  76.360  198.560  R0  PLACED  _33161_
i_lisa_core.GEN_LISA_DBG.i_lisa_dbg.f1[5]  flop  sky130_fd_sc_hd__dfxtp_1  162.840  225.760  R0  PLACED  _33162_
i_lisa_core.GEN_LISA_DBG.i_lisa_dbg.f1[6]  flop  sky130_fd_sc_hd__dfxtp_1  67.160  201.280  MX  PLACED  _33163_
i_lisa_core.GEN_LISA_DBG.i_lisa_dbg.f1[7]  flop  sky130_fd_sc_hd__dfxtp_1  54.740  217.600  MX  PLACED  _33164_
i_lisa_core.GEN_LISA_DBG.i_lisa_dbg.f1[8]  flop  sky130_fd_sc_hd__dfxtp_1  187.680  214.880  R0  PLACED  _33165_
i_lisa_core.GEN_LISA_DBG.i_lisa_dbg.f1[9]  flop  sky130_fd_sc_hd__dfxtp_1  260.820  209.440  R0  PLACED  _33166_
i_lisa_core.GEN_LISA_DBG.i_lisa_dbg.f2[0]  flop  sky130_fd_sc_hd__dfxtp_1  189.980  223.040  MX  PLACED  _33173_
i_lisa_core.GEN_LISA_DBG.i_lisa_dbg.f2[10]  flop  sky130_fd_sc_hd__dfxtp_1  264.040  220.320  R0  PLACED  _33183_
i_lisa_core.GEN_LISA_DBG.i_lisa_dbg.f2[11]  flop  sky130_fd_sc_hd__dfxtp_1  203.320  220.320  R0  PLACED  _33184_
i_lisa_core.GEN_LISA_DBG.i_lisa_dbg.f2[12]  flop  sky130_fd_sc_hd__dfxtp_1  253.460  214.880  R0  PLACED  _33185_
i_lisa_core.GEN_LISA_DBG.i_lisa_dbg.f2[13]  flop  sky130_fd_sc_hd__dfxtp_1  253.000  223.040  MX  PLACED  _33186_
i_lisa_core.GEN_LISA_DBG.i_lisa_dbg.f2[14]  flop  sky130_fd_sc_hd__dfxtp_1  200.100  233.920  MX  PLACED  _33187_
i_lisa_core.GEN_LISA_DBG.i_lisa_dbg.f2[15]  flop  sky130_fd_sc_hd__dfxtp_1  141.680  233.920  MX  PLACED  _33172_
i_lisa_core.GEN_LISA_DBG.i_lisa_dbg.f2[1]  flop  sky130_fd_sc_hd__dfxtp_1  51.060  231.200  R0  PLACED  _33174_
i_lisa_core.GEN_LISA_DBG.i_lisa_dbg.f2[2]  flop  sky130_fd_sc_hd__dfxtp_1  45.540  195.840  MX  PLACED  _33175_
i_lisa_core.GEN_LISA_DBG.i_lisa_dbg.f2[3]  flop  sky130_fd_sc_hd__dfxtp_1  47.380  204.000  R0  PLACED  _33176_
i_lisa_core.GEN_LISA_DBG.i_lisa_dbg.f2[4]  flop  sky130_fd_sc_hd__dfxtp_1  85.560  198.560  R0  PLACED  _33177_
i_lisa_core.GEN_LISA_DBG.i_lisa_dbg.f2[5]  flop  sky130_fd_sc_hd__dfxtp_1  177.100  214.880  R0  PLACED  _33178_
i_lisa_core.GEN_LISA_DBG.i_lisa_dbg.f2[6]  flop  sky130_fd_sc_hd__dfxtp_1  61.180  195.840  MX  PLACED  _33179_
i_lisa_core.GEN_LISA_DBG.i_lisa_dbg.f2[7]  flop  sky130_fd_sc_hd__dfxtp_1  46.920  223.040  MX  PLACED  _33180_
i_lisa_core.GEN_LISA_DBG.i_lisa_dbg.f2[8]  flop  sky130_fd_sc_hd__dfxtp_1  204.700  209.440  R0  PLACED  _33181_
i_lisa_core.GEN_LISA_DBG.i_lisa_dbg.f2[9]  flop  sky130_fd_sc_hd__dfxtp_1  261.280  201.280  MX  PLACED  _33182_
i_lisa_core.GEN_LISA_DBG.i_lisa_dbg.f3[0]  flop  sky130_fd_sc_hd__dfxtp_1  183.540  228.480  MX  PLACED  _33189_
i_lisa_core.GEN_LISA_DBG.i_lisa_dbg.f3[10]  flop  sky130_fd_sc_hd__dfxtp_1  274.620  220.320  R0  PLACED  _33199_
i_lisa_core.GEN_LISA_DBG.i_lisa_dbg.f3[11]  flop  sky130_fd_sc_hd__dfxtp_1  214.360  225.760  R0  PLACED  _33200_
i_lisa_core.GEN_LISA_DBG.i_lisa_dbg.f3[12]  flop  sky130_fd_sc_hd__dfxtp_1  227.240  214.880  R0  PLACED  _33201_
i_lisa_core.GEN_LISA_DBG.i_lisa_dbg.f3[13]  flop  sky130_fd_sc_hd__dfxtp_1  235.060  223.040  MX  PLACED  _33202_
i_lisa_core.GEN_LISA_DBG.i_lisa_dbg.f3[14]  flop  sky130_fd_sc_hd__dfxtp_1  188.600  231.200  R0  PLACED  _33203_
i_lisa_core.GEN_LISA_DBG.i_lisa_dbg.f3[15]  flop  sky130_fd_sc_hd__dfxtp_1  128.800  236.640  R0  PLACED  _33188_
i_lisa_core.GEN_LISA_DBG.i_lisa_dbg.f3[1]  flop  sky130_fd_sc_hd__dfxtp_1  46.920  228.480  MX  PLACED  _33190_
i_lisa_core.GEN_LISA_DBG.i_lisa_dbg.f3[2]  flop  sky130_fd_sc_hd__dfxtp_1  45.540  190.400  MX  PLACED  _33191_
i_lisa_core.GEN_LISA_DBG.i_lisa_dbg.f3[3]  flop  sky130_fd_sc_hd__dfxtp_1  45.080  209.440  R0  PLACED  _33192_
i_lisa_core.GEN_LISA_DBG.i_lisa_dbg.f3[4]  flop  sky130_fd_sc_hd__dfxtp_1  73.140  193.120  R0  PLACED  _33193_
i_lisa_core.GEN_LISA_DBG.i_lisa_dbg.f3[5]  flop  sky130_fd_sc_hd__dfxtp_1  168.820  217.600  MX  PLACED  _33194_
i_lisa_core.GEN_LISA_DBG.i_lisa_dbg.f3[6]  flop  sky130_fd_sc_hd__dfxtp_1  67.160  190.400  MX  PLACED  _33195_
i_lisa_core.GEN_LISA_DBG.i_lisa_dbg.f3[7]  flop  sky130_fd_sc_hd__dfxtp_1  44.620  217.600  MX  PLACED  _33196_
i_lisa_core.GEN_LISA_DBG.i_lisa_dbg.f3[8]  flop  sky130_fd_sc_hd__dfxtp_1  194.580  217.600  MX  PLACED  _33197_
i_lisa_core.GEN_LISA_DBG.i_lisa_dbg.f3[9]  flop  sky130_fd_sc_hd__dfxtp_1  270.940  201.280  MX  PLACED  _33198_
i_lisa_core.GEN_LISA_DBG.i_lisa_dbg.fetch  flop  sky130_fd_sc_hd__dfstp_2  263.120  296.480  R0  PLACED  _34398_
i_lisa_core.GEN_LISA_DBG.i_lisa_dbg.fetch_r  flop  sky130_fd_sc_hd__dfxtp_1  377.200  274.720  R0  PLACED  _33305_
i_lisa_core.GEN_LISA_DBG.i_lisa_dbg.skip_r  flop  sky130_fd_sc_hd__dfxtp_1  390.540  266.560  MX  PLACED  _33304_
i_lisa_core.GEN_LISA_DBG.i_lisa_dbg.step_r  flop  sky130_fd_sc_hd__dfxtp_1  389.160  269.280  R0  PLACED  _33303_
i_lisa_core.acc_delayed_load  flop  sky130_fd_sc_hd__dfxtp_1  88.780  310.080  MX  PLACED  _33215_
i_lisa_core.acc_delayed_val[0]  flop  sky130_fd_sc_hd__dfxtp_1  80.500  310.080  MX  PLACED  _33219_
i_lisa_core.acc_delayed_val[1]  flop  sky130_fd_sc_hd__dfxtp_1  72.680  320.960  MX  PLACED  _33220_
i_lisa_core.acc_delayed_val[2]  flop  sky130_fd_sc_hd__dfxtp_1  63.480  331.840  MX  PLACED  _33221_
i_lisa_core.acc_delayed_val[3]  flop  sky130_fd_sc_hd__dfxtp_1  68.080  329.120  R0  PLACED  _33222_
i_lisa_core.acc_delayed_val[4]  flop  sky130_fd_sc_hd__dfxtp_1  72.680  342.720  MX  PLACED  _33223_
i_lisa_core.acc_delayed_val[5]  flop  sky130_fd_sc_hd__dfxtp_1  63.020  342.720  MX  PLACED  _33224_
i_lisa_core.acc_delayed_val[6]  flop  sky130_fd_sc_hd__dfxtp_1  76.360  334.560  R0  PLACED  _33225_
i_lisa_core.acc_delayed_val[7]  flop  sky130_fd_sc_hd__dfxtp_1  77.280  329.120  R0  PLACED  _33226_
i_lisa_core.amode_isr[0]  flop  sky130_fd_sc_hd__dfstp_2  22.080  247.520  R0  PLACED  _33252_
i_lisa_core.amode_isr[1]  flop  sky130_fd_sc_hd__dfrtp_1  40.480  244.800  MX  PLACED  _33253_
i_lisa_core.amode_isr[2]  flop  sky130_fd_sc_hd__dfrtp_1  72.220  247.520  R0  PLACED  _33254_
i_lisa_core.br_taken_r  flop  sky130_fd_sc_hd__dfrtp_1  184.460  299.200  MX  PLACED  _34446_
i_lisa_core.cflag_isr  flop  sky130_fd_sc_hd__dfrtp_1  61.180  261.120  MX  PLACED  _33250_
i_lisa_core.cflag_save  flop  sky130_fd_sc_hd__dfxtp_1  54.740  250.240  MX  PLACED  _33205_
i_lisa_core.cflag_save_isr  flop  sky130_fd_sc_hd__dfrtp_1  18.860  250.240  MX  PLACED  _33251_
i_lisa_core.cond[0]  flop  sky130_fd_sc_hd__dfxtp_1  209.300  307.360  R0  PLACED  _33249_
i_lisa_core.cond[1]  flop  sky130_fd_sc_hd__dfxtp_1  197.800  291.040  R0  PLACED  _33248_
i_lisa_core.d_ready_r  flop  sky130_fd_sc_hd__dfrtp_1  366.160  255.680  MX  PLACED  _34495_
i_lisa_core.d_we_r  flop  sky130_fd_sc_hd__dfrtp_1  250.240  282.880  MX  PLACED  _32708_
i_lisa_core.dbg_inc_r  flop  sky130_fd_sc_hd__dfrtp_1  363.860  304.640  MX  PLACED  _33276_
i_lisa_core.decode_state  flop  sky130_fd_sc_hd__dfrtp_1  264.040  291.040  R0  PLACED  _34400_
i_lisa_core.delayed_sp_dec  flop  sky130_fd_sc_hd__dfxtp_1  210.680  272.000  MX  PLACED  _33242_
i_lisa_core.div_args[0]  flop  sky130_fd_sc_hd__dfxtp_1  101.660  312.800  R0  PLACED  _33246_
i_lisa_core.div_args[1]  flop  sky130_fd_sc_hd__dfxtp_1  162.380  315.520  MX  PLACED  _33247_
i_lisa_core.div_stage_two  flop  sky130_fd_sc_hd__dfxtp_1  141.220  310.080  MX  PLACED  _33244_
i_lisa_core.exec_state  flop  sky130_fd_sc_hd__dfrtp_1  243.800  272.000  MX  PLACED  _34402_
i_lisa_core.extE_op1_w[0]  flop  sky130_fd_sc_hd__dfxtp_1  156.860  165.920  R0  PLACED  _33313_
i_lisa_core.extE_op1_w[1]  flop  sky130_fd_sc_hd__dfxtp_1  211.600  174.080  MX  PLACED  _33314_
i_lisa_core.extE_op1_w[2]  flop  sky130_fd_sc_hd__dfxtp_1  265.880  193.120  R0  PLACED  _33315_
i_lisa_core.extE_op1_w[3]  flop  sky130_fd_sc_hd__dfxtp_1  277.380  184.960  MX  PLACED  _33316_
i_lisa_core.extE_op1_w[4]  flop  sky130_fd_sc_hd__dfxtp_1  251.620  171.360  R0  PLACED  _33317_
i_lisa_core.extE_op1_w[5]  flop  sky130_fd_sc_hd__dfxtp_1  258.520  182.240  R0  PLACED  _33318_
i_lisa_core.extE_op1_w[6]  flop  sky130_fd_sc_hd__dfxtp_1  260.820  184.960  MX  PLACED  _33319_
i_lisa_core.extE_op1_w[7]  flop  sky130_fd_sc_hd__dfxtp_1  249.780  179.520  MX  PLACED  _33320_
i_lisa_core.extE_op2_w[0]  flop  sky130_fd_sc_hd__dfxtp_1  173.420  163.200  MX  PLACED  _33327_
i_lisa_core.extE_op2_w[1]  flop  sky130_fd_sc_hd__dfxtp_1  198.260  179.520  MX  PLACED  _33328_
i_lisa_core.extE_op2_w[2]  flop  sky130_fd_sc_hd__dfxtp_1  265.880  182.240  R0  PLACED  _33329_
i_lisa_core.extE_op2_w[3]  flop  sky130_fd_sc_hd__dfxtp_1  270.020  184.960  MX  PLACED  _33330_
i_lisa_core.extE_op2_w[4]  flop  sky130_fd_sc_hd__dfxtp_1  227.240  184.960  MX  PLACED  _33331_
i_lisa_core.extE_op2_w[5]  flop  sky130_fd_sc_hd__dfxtp_1  237.360  182.240  R0  PLACED  _33332_
i_lisa_core.extE_op2_w[6]  flop  sky130_fd_sc_hd__dfxtp_1  247.020  184.960  MX  PLACED  _33333_
i_lisa_core.extE_op2_w[7]  flop  sky130_fd_sc_hd__dfxtp_1  250.700  182.240  R0  PLACED  _33334_
i_lisa_core.facc[0]  flop  sky130_fd_sc_hd__dfxtp_1  212.520  168.640  MX  PLACED  _33125_
i_lisa_core.facc[10]  flop  sky130_fd_sc_hd__dfxtp_1  219.420  206.720  MX  PLACED  _33135_
i_lisa_core.facc[11]  flop  sky130_fd_sc_hd__dfxtp_1  253.000  206.720  MX  PLACED  _33136_
i_lisa_core.facc[12]  flop  sky130_fd_sc_hd__dfxtp_1  236.900  195.840  MX  PLACED  _33137_
i_lisa_core.facc[13]  flop  sky130_fd_sc_hd__dfxtp_1  253.000  190.400  MX  PLACED  _33138_
i_lisa_core.facc[14]  flop  sky130_fd_sc_hd__dfxtp_1  253.460  198.560  R0  PLACED  _33139_
i_lisa_core.facc[15]  flop  sky130_fd_sc_hd__dfxtp_1  183.540  206.720  MX  PLACED  _34553_
i_lisa_core.facc[1]  flop  sky130_fd_sc_hd__dfxtp_1  193.200  157.760  MX  PLACED  _33126_
i_lisa_core.facc[2]  flop  sky130_fd_sc_hd__dfxtp_1  229.080  209.440  R0  PLACED  _33127_
i_lisa_core.facc[3]  flop  sky130_fd_sc_hd__dfxtp_1  243.800  212.160  MX  PLACED  _33128_
i_lisa_core.facc[4]  flop  sky130_fd_sc_hd__dfxtp_1  213.900  160.480  R0  PLACED  _33129_
i_lisa_core.facc[5]  flop  sky130_fd_sc_hd__dfxtp_1  209.300  157.760  MX  PLACED  _33130_
i_lisa_core.facc[6]  flop  sky130_fd_sc_hd__dfxtp_1  248.400  209.440  R0  PLACED  _33131_
i_lisa_core.facc[7]  flop  sky130_fd_sc_hd__dfxtp_1  179.400  198.560  R0  PLACED  _33132_
i_lisa_core.facc[8]  flop  sky130_fd_sc_hd__dfxtp_1  211.140  204.000  R0  PLACED  _33133_
i_lisa_core.facc[9]  flop  sky130_fd_sc_hd__dfxtp_1  222.180  198.560  R0  PLACED  _33134_
i_lisa_core.fdiv_r  flop  sky130_fd_sc_hd__dfxtp_1  185.840  114.240  MX  PLACED  _33204_
i_lisa_core.fdiv_result[0]  flop  sky130_fd_sc_hd__dfxtp_1  209.760  59.840  MX  PLACED  _33348_
i_lisa_core.fdiv_result[10]  flop  sky130_fd_sc_hd__dfxtp_1  226.320  130.560  MX  PLACED  _33358_
i_lisa_core.fdiv_result[11]  flop  sky130_fd_sc_hd__dfxtp_1  230.000  84.320  R0  PLACED  _33359_
i_lisa_core.fdiv_result[12]  flop  sky130_fd_sc_hd__dfxtp_1  235.060  130.560  MX  PLACED  _33360_
i_lisa_core.fdiv_result[13]  flop  sky130_fd_sc_hd__dfxtp_1  240.120  133.280  R0  PLACED  _33361_
i_lisa_core.fdiv_result[14]  flop  sky130_fd_sc_hd__dfxtp_1  243.340  87.040  MX  PLACED  _33362_
i_lisa_core.fdiv_result[15]  flop  sky130_fd_sc_hd__dfxtp_1  196.420  127.840  R0  PLACED  _33363_
i_lisa_core.fdiv_result[1]  flop  sky130_fd_sc_hd__dfxtp_1  196.880  59.840  MX  PLACED  _33349_
i_lisa_core.fdiv_result[2]  flop  sky130_fd_sc_hd__dfxtp_1  212.060  122.400  R0  PLACED  _33350_
i_lisa_core.fdiv_result[3]  flop  sky130_fd_sc_hd__dfxtp_1  205.160  116.960  R0  PLACED  _33351_
i_lisa_core.fdiv_result[4]  flop  sky130_fd_sc_hd__dfxtp_1  210.220  68.000  R0  PLACED  _33352_
i_lisa_core.fdiv_result[5]  flop  sky130_fd_sc_hd__dfxtp_1  198.260  65.280  MX  PLACED  _33353_
i_lisa_core.fdiv_result[6]  flop  sky130_fd_sc_hd__dfxtp_1  199.640  70.720  MX  PLACED  _33354_
i_lisa_core.fdiv_result[7]  flop  sky130_fd_sc_hd__dfxtp_1  193.660  92.480  MX  PLACED  _33355_
i_lisa_core.fdiv_result[8]  flop  sky130_fd_sc_hd__dfxtp_1  220.340  125.120  MX  PLACED  _33356_
i_lisa_core.fdiv_result[9]  flop  sky130_fd_sc_hd__dfxtp_1  223.560  127.840  R0  PLACED  _33357_
i_lisa_core.fdiv_valid  flop  sky130_fd_sc_hd__dfxtp_1  185.380  119.680  MX  PLACED  _33364_
i_lisa_core.i_bf16div.div_e_res[0]  flop  sky130_fd_sc_hd__dfxtp_1  196.880  76.160  MX  PLACED  _33378_
i_lisa_core.i_bf16div.div_e_res[1]  flop  sky130_fd_sc_hd__dfxtp_1  219.880  76.160  MX  PLACED  _33379_
i_lisa_core.i_bf16div.div_e_res[2]  flop  sky130_fd_sc_hd__dfxtp_1  222.640  84.320  R0  PLACED  _33380_
i_lisa_core.i_bf16div.div_e_res[3]  flop  sky130_fd_sc_hd__dfxtp_1  225.400  78.880  R0  PLACED  _33381_
i_lisa_core.i_bf16div.div_e_res[4]  flop  sky130_fd_sc_hd__dfxtp_1  227.240  81.600  MX  PLACED  _33382_
i_lisa_core.i_bf16div.div_e_res[5]  flop  sky130_fd_sc_hd__dfxtp_1  232.760  78.880  R0  PLACED  _33383_
i_lisa_core.i_bf16div.div_e_res[6]  flop  sky130_fd_sc_hd__dfxtp_1  240.120  78.880  R0  PLACED  _33384_
i_lisa_core.i_bf16div.div_e_res[7]  flop  sky130_fd_sc_hd__dfxtp_1  241.500  76.160  MX  PLACED  _33385_
i_lisa_core.i_bf16div.div_f_res[10]  flop  sky130_fd_sc_hd__dfxtp_1  218.960  54.400  MX  PLACED  _33395_
i_lisa_core.i_bf16div.div_f_res[11]  flop  sky130_fd_sc_hd__dfxtp_1  201.480  73.440  R0  PLACED  _33396_
i_lisa_core.i_bf16div.div_f_res[1]  flop  sky130_fd_sc_hd__dfxtp_1  227.700  24.480  R0  PLACED  _33386_
i_lisa_core.i_bf16div.div_f_res[2]  flop  sky130_fd_sc_hd__dfxtp_1  224.020  21.760  MX  PLACED  _33387_
i_lisa_core.i_bf16div.div_f_res[3]  flop  sky130_fd_sc_hd__dfxtp_1  212.520  38.080  MX  PLACED  _33388_
i_lisa_core.i_bf16div.div_f_res[4]  flop  sky130_fd_sc_hd__dfxtp_1  219.880  38.080  MX  PLACED  _33389_
i_lisa_core.i_bf16div.div_f_res[5]  flop  sky130_fd_sc_hd__dfxtp_1  214.360  35.360  R0  PLACED  _33390_
i_lisa_core.i_bf16div.div_f_res[6]  flop  sky130_fd_sc_hd__dfxtp_1  222.180  46.240  R0  PLACED  _33391_
i_lisa_core.i_bf16div.div_f_res[7]  flop  sky130_fd_sc_hd__dfxtp_1  227.240  43.520  MX  PLACED  _33392_
i_lisa_core.i_bf16div.div_f_res[8]  flop  sky130_fd_sc_hd__dfxtp_1  206.540  40.800  R0  PLACED  _33393_
i_lisa_core.i_bf16div.div_f_res[9]  flop  sky130_fd_sc_hd__dfxtp_1  209.300  43.520  MX  PLACED  _33394_
i_lisa_core.i_bf16div.div_isToRound  flop  sky130_fd_sc_hd__dfxtp_1  210.680  73.440  R0  PLACED  _33398_
i_lisa_core.i_bf16div.div_s_res  flop  sky130_fd_sc_hd__dfxtp_1  204.700  122.400  R0  PLACED  _33377_
i_lisa_core.i_bf16div.div_valid  flop  sky130_fd_sc_hd__dfxtp_1  191.820  97.920  MX  PLACED  _33397_
i_lisa_core.i_bf16div.doDiv_r  flop  sky130_fd_sc_hd__dfxtp_1  115.920  103.360  MX  PLACED  _33366_
i_lisa_core.i_bf16div.extShF_op2_r[0]  flop  sky130_fd_sc_hd__dfxtp_1  77.740  160.480  R0  PLACED  _34554_
i_lisa_core.i_bf16div.extShF_op2_r[1]  flop  sky130_fd_sc_hd__dfxtp_1  68.080  157.760  MX  PLACED  _34555_
i_lisa_core.i_bf16div.extShF_op2_r[2]  flop  sky130_fd_sc_hd__dfxtp_1  59.340  152.320  MX  PLACED  _34556_
i_lisa_core.i_bf16div.extShF_op2_r[3]  flop  sky130_fd_sc_hd__dfxtp_1  69.000  152.320  MX  PLACED  _33340_
i_lisa_core.i_bf16div.extShF_op2_r[4]  flop  sky130_fd_sc_hd__dfxtp_1  71.760  146.880  MX  PLACED  _33341_
i_lisa_core.i_bf16div.extShF_op2_r[5]  flop  sky130_fd_sc_hd__dfxtp_1  69.920  171.360  R0  PLACED  _33342_
i_lisa_core.i_bf16div.extShF_op2_r[6]  flop  sky130_fd_sc_hd__dfxtp_1  68.080  144.160  R0  PLACED  _33343_
i_lisa_core.i_bf16div.extShF_op2_r[7]  flop  sky130_fd_sc_hd__dfxtp_1  74.980  165.920  R0  PLACED  _33344_
i_lisa_core.i_bf16div.isDN_op1_r  flop  sky130_fd_sc_hd__dfxtp_1  153.640  155.040  R0  PLACED  _33325_
i_lisa_core.i_bf16div.isDN_op2_r  flop  sky130_fd_sc_hd__dfxtp_1  170.660  157.760  MX  PLACED  _33339_
i_lisa_core.i_bf16div.isInf_op1_r  flop  sky130_fd_sc_hd__dfxtp_1  184.460  163.200  MX  PLACED  _33321_
i_lisa_core.i_bf16div.isInf_op2_r  flop  sky130_fd_sc_hd__dfxtp_1  196.420  152.320  MX  PLACED  _33335_
i_lisa_core.i_bf16div.isQNAN_op1_r  flop  sky130_fd_sc_hd__dfxtp_1  184.460  152.320  MX  PLACED  _33324_
i_lisa_core.i_bf16div.isQNAN_op2_r  flop  sky130_fd_sc_hd__dfxtp_1  196.420  144.160  R0  PLACED  _33338_
i_lisa_core.i_bf16div.isResultValid_o_next  flop  sky130_fd_sc_hd__dfxtp_1  192.740  103.360  MX  PLACED  _34405_
i_lisa_core.i_bf16div.isSNAN_op1_r  flop  sky130_fd_sc_hd__dfxtp_1  185.840  155.040  R0  PLACED  _33323_
i_lisa_core.i_bf16div.isSNAN_op2_r  flop  sky130_fd_sc_hd__dfxtp_1  195.960  141.440  MX  PLACED  _33337_
i_lisa_core.i_bf16div.isZ_op1_r  flop  sky130_fd_sc_hd__dfxtp_1  154.560  160.480  R0  PLACED  _33322_
i_lisa_core.i_bf16div.isZ_op2_r  flop  sky130_fd_sc_hd__dfxtp_1  173.880  155.040  R0  PLACED  _33336_
i_lisa_core.i_bf16div.lampFPU_div0.e_initial_extra_neg[0]  flop  sky130_fd_sc_hd__dfxtp_1  222.180  65.280  MX  PLACED  _33409_
i_lisa_core.i_bf16div.lampFPU_div0.e_initial_extra_neg[1]  flop  sky130_fd_sc_hd__dfxtp_1  217.120  59.840  MX  PLACED  _33410_
i_lisa_core.i_bf16div.lampFPU_div0.e_initial_extra_neg[2]  flop  sky130_fd_sc_hd__dfxtp_1  222.180  51.680  R0  PLACED  _33411_
i_lisa_core.i_bf16div.lampFPU_div0.e_initial_extra_neg[3]  flop  sky130_fd_sc_hd__dfxtp_1  225.860  48.960  MX  PLACED  _33412_
i_lisa_core.i_bf16div.lampFPU_div0.e_initial_extra_neg[4]  flop  sky130_fd_sc_hd__dfxtp_1  237.360  84.320  R0  PLACED  _33413_
i_lisa_core.i_bf16div.lampFPU_div0.e_initial_extra_neg[5]  flop  sky130_fd_sc_hd__dfxtp_1  243.340  81.600  MX  PLACED  _33414_
i_lisa_core.i_bf16div.lampFPU_div0.e_initial_extra_neg[6]  flop  sky130_fd_sc_hd__dfxtp_1  248.400  89.760  R0  PLACED  _33415_
i_lisa_core.i_bf16div.lampFPU_div0.e_initial_extra_neg[7]  flop  sky130_fd_sc_hd__dfxtp_1  251.620  70.720  MX  PLACED  _33416_
i_lisa_core.i_bf16div.lampFPU_div0.e_initial_extra_neg[8]  flop  sky130_fd_sc_hd__dfxtp_1  253.460  78.880  R0  PLACED  _33417_
i_lisa_core.i_bf16div.lampFPU_div0.e_initial_extra_neg[9]  flop  sky130_fd_sc_hd__dfxtp_1  253.000  76.160  MX  PLACED  _33418_
i_lisa_core.i_bf16div.lampFPU_div0.e_initial_res_div_r[0]  flop  sky130_fd_sc_hd__dfxtp_1  222.180  68.000  R0  PLACED  _33399_
i_lisa_core.i_bf16div.lampFPU_div0.e_initial_res_div_r[1]  flop  sky130_fd_sc_hd__dfxtp_1  213.440  87.040  MX  PLACED  _33400_
i_lisa_core.i_bf16div.lampFPU_div0.e_initial_res_div_r[2]  flop  sky130_fd_sc_hd__dfxtp_1  217.120  81.600  MX  PLACED  _33401_
i_lisa_core.i_bf16div.lampFPU_div0.e_initial_res_div_r[3]  flop  sky130_fd_sc_hd__dfxtp_1  223.100  87.040  MX  PLACED  _33402_
i_lisa_core.i_bf16div.lampFPU_div0.e_initial_res_div_r[4]  flop  sky130_fd_sc_hd__dfxtp_1  232.760  89.760  R0  PLACED  _33403_
i_lisa_core.i_bf16div.lampFPU_div0.e_initial_res_div_r[5]  flop  sky130_fd_sc_hd__dfxtp_1  240.120  89.760  R0  PLACED  _33404_
i_lisa_core.i_bf16div.lampFPU_div0.e_initial_res_div_r[6]  flop  sky130_fd_sc_hd__dfxtp_1  251.160  87.040  MX  PLACED  _33405_
i_lisa_core.i_bf16div.lampFPU_div0.e_initial_res_div_r[7]  flop  sky130_fd_sc_hd__dfxtp_1  255.760  89.760  R0  PLACED  _33406_
i_lisa_core.i_bf16div.lampFPU_div0.e_initial_res_div_r[8]  flop  sky130_fd_sc_hd__dfxtp_1  254.380  73.440  R0  PLACED  _33407_
i_lisa_core.i_bf16div.lampFPU_div0.e_initial_res_div_r[9]  flop  sky130_fd_sc_hd__dfxtp_1  253.000  81.600  MX  PLACED  _33408_
i_lisa_core.i_bf16div.lampFPU_div0.fd_res[0]  flop  sky130_fd_sc_hd__dfxtp_1  224.940  5.440  MX  PLACED  _33420_
i_lisa_core.i_bf16div.lampFPU_div0.fd_res[10]  flop  sky130_fd_sc_hd__dfxtp_1  188.600  78.880  R0  PLACED  _33430_
i_lisa_core.i_bf16div.lampFPU_div0.fd_res[11]  flop  sky130_fd_sc_hd__dfxtp_1  187.220  76.160  MX  PLACED  _33431_
i_lisa_core.i_bf16div.lampFPU_div0.fd_res[12]  flop  sky130_fd_sc_hd__dfxtp_1  191.820  81.600  MX  PLACED  _33432_
i_lisa_core.i_bf16div.lampFPU_div0.fd_res[13]  flop  sky130_fd_sc_hd__dfxtp_1  193.660  87.040  MX  PLACED  _33433_
i_lisa_core.i_bf16div.lampFPU_div0.fd_res[14]  flop  sky130_fd_sc_hd__dfxtp_1  196.420  68.000  R0  PLACED  _33434_
i_lisa_core.i_bf16div.lampFPU_div0.fd_res[15]  flop  sky130_fd_sc_hd__dfxtp_1  185.840  73.440  R0  PLACED  _33435_
i_lisa_core.i_bf16div.lampFPU_div0.fd_res[1]  flop  sky130_fd_sc_hd__dfxtp_1  238.280  5.440  MX  PLACED  _33421_
i_lisa_core.i_bf16div.lampFPU_div0.fd_res[2]  flop  sky130_fd_sc_hd__dfxtp_1  235.520  2.720  R0  PLACED  _33422_
i_lisa_core.i_bf16div.lampFPU_div0.fd_res[3]  flop  sky130_fd_sc_hd__dfxtp_1  221.720  16.320  MX  PLACED  _33423_
i_lisa_core.i_bf16div.lampFPU_div0.fd_res[4]  flop  sky130_fd_sc_hd__dfxtp_1  224.480  8.160  R0  PLACED  _33424_
i_lisa_core.i_bf16div.lampFPU_div0.fd_res[5]  flop  sky130_fd_sc_hd__dfxtp_1  216.660  21.760  MX  PLACED  _33425_
i_lisa_core.i_bf16div.lampFPU_div0.fd_res[6]  flop  sky130_fd_sc_hd__dfxtp_1  217.120  27.200  MX  PLACED  _33426_
i_lisa_core.i_bf16div.lampFPU_div0.fd_res[7]  flop  sky130_fd_sc_hd__dfxtp_1  214.360  29.920  R0  PLACED  _33427_
i_lisa_core.i_bf16div.lampFPU_div0.fd_res[8]  flop  sky130_fd_sc_hd__dfxtp_1  223.560  29.920  R0  PLACED  _33428_
i_lisa_core.i_bf16div.lampFPU_div0.fd_res[9]  flop  sky130_fd_sc_hd__dfxtp_1  190.900  70.720  MX  PLACED  _33429_
i_lisa_core.i_bf16div.lampFPU_div0.fd_valid  flop  sky130_fd_sc_hd__dfxtp_1  187.680  95.200  R0  PLACED  _33419_
i_lisa_core.i_bf16div.lampFPU_div0.i_calcInfNanZeroResDiv.isInf_op1_i  flop  sky130_fd_sc_hd__dfxtp_1  206.540  84.320  R0  PLACED  _33368_
i_lisa_core.i_bf16div.lampFPU_div0.i_calcInfNanZeroResDiv.isInf_op2_i  flop  sky130_fd_sc_hd__dfxtp_1  201.480  81.600  MX  PLACED  _33373_
i_lisa_core.i_bf16div.lampFPU_div0.i_calcInfNanZeroResDiv.isQNan_op1_i  flop  sky130_fd_sc_hd__dfxtp_1  209.300  141.440  MX  PLACED  _33371_
i_lisa_core.i_bf16div.lampFPU_div0.i_calcInfNanZeroResDiv.isQNan_op2_i  flop  sky130_fd_sc_hd__dfxtp_1  201.480  138.720  R0  PLACED  _33376_
i_lisa_core.i_bf16div.lampFPU_div0.i_calcInfNanZeroResDiv.isSNan_op1_i  flop  sky130_fd_sc_hd__dfxtp_1  200.560  136.000  MX  PLACED  _33370_
i_lisa_core.i_bf16div.lampFPU_div0.i_calcInfNanZeroResDiv.isSNan_op2_i  flop  sky130_fd_sc_hd__dfxtp_1  208.840  138.720  R0  PLACED  _33375_
i_lisa_core.i_bf16div.lampFPU_div0.i_calcInfNanZeroResDiv.isZero_op1_i  flop  sky130_fd_sc_hd__dfxtp_1  201.020  78.880  R0  PLACED  _33369_
i_lisa_core.i_bf16div.lampFPU_div0.i_calcInfNanZeroResDiv.isZero_op2_i  flop  sky130_fd_sc_hd__dfxtp_1  201.480  87.040  MX  PLACED  _33374_
i_lisa_core.i_bf16div.lampFPU_div0.lampFPU_fractDiv0.d_r[0]  flop  sky130_fd_sc_hd__dfxtp_1  76.820  84.320  R0  PLACED  _33452_
i_lisa_core.i_bf16div.lampFPU_div0.lampFPU_fractDiv0.d_r[10]  flop  sky130_fd_sc_hd__dfxtp_1  59.800  149.600  R0  PLACED  _33462_
i_lisa_core.i_bf16div.lampFPU_div0.lampFPU_fractDiv0.d_r[11]  flop  sky130_fd_sc_hd__dfxtp_1  70.840  155.040  R0  PLACED  _33463_
i_lisa_core.i_bf16div.lampFPU_div0.lampFPU_fractDiv0.d_r[12]  flop  sky130_fd_sc_hd__dfxtp_1  73.600  133.280  R0  PLACED  _33464_
i_lisa_core.i_bf16div.lampFPU_div0.lampFPU_fractDiv0.d_r[13]  flop  sky130_fd_sc_hd__dfxtp_1  63.480  174.080  MX  PLACED  _33465_
i_lisa_core.i_bf16div.lampFPU_div0.lampFPU_fractDiv0.d_r[14]  flop  sky130_fd_sc_hd__dfxtp_1  66.700  168.640  MX  PLACED  _33466_
i_lisa_core.i_bf16div.lampFPU_div0.lampFPU_fractDiv0.d_r[15]  flop  sky130_fd_sc_hd__dfxtp_1  41.860  236.640  R0  PLACED  _33467_
i_lisa_core.i_bf16div.lampFPU_div0.lampFPU_fractDiv0.d_r[1]  flop  sky130_fd_sc_hd__dfxtp_1  76.360  89.760  R0  PLACED  _33453_
i_lisa_core.i_bf16div.lampFPU_div0.lampFPU_fractDiv0.d_r[2]  flop  sky130_fd_sc_hd__dfxtp_1  75.440  100.640  R0  PLACED  _33454_
i_lisa_core.i_bf16div.lampFPU_div0.lampFPU_fractDiv0.d_r[3]  flop  sky130_fd_sc_hd__dfxtp_1  71.300  114.240  MX  PLACED  _33455_
i_lisa_core.i_bf16div.lampFPU_div0.lampFPU_fractDiv0.d_r[4]  flop  sky130_fd_sc_hd__dfxtp_1  72.680  125.120  MX  PLACED  _33456_
i_lisa_core.i_bf16div.lampFPU_div0.lampFPU_fractDiv0.d_r[5]  flop  sky130_fd_sc_hd__dfxtp_1  69.000  130.560  MX  PLACED  _33457_
i_lisa_core.i_bf16div.lampFPU_div0.lampFPU_fractDiv0.d_r[6]  flop  sky130_fd_sc_hd__dfxtp_1  66.240  141.440  MX  PLACED  _33458_
i_lisa_core.i_bf16div.lampFPU_div0.lampFPU_fractDiv0.d_r[7]  flop  sky130_fd_sc_hd__dfxtp_1  59.340  168.640  MX  PLACED  _33459_
i_lisa_core.i_bf16div.lampFPU_div0.lampFPU_fractDiv0.d_r[8]  flop  sky130_fd_sc_hd__dfxtp_1  70.380  163.200  MX  PLACED  _33460_
i_lisa_core.i_bf16div.lampFPU_div0.lampFPU_fractDiv0.d_r[9]  flop  sky130_fd_sc_hd__dfxtp_1  56.580  157.760  MX  PLACED  _33461_
i_lisa_core.i_bf16div.lampFPU_div0.lampFPU_fractDiv0.i_r[0]  flop  sky130_fd_sc_hd__dfxtp_1  104.420  106.080  R0  PLACED  _33484_
i_lisa_core.i_bf16div.lampFPU_div0.lampFPU_fractDiv0.n_r[0]  flop  sky130_fd_sc_hd__dfxtp_1  74.520  8.160  R0  PLACED  _33436_
i_lisa_core.i_bf16div.lampFPU_div0.lampFPU_fractDiv0.n_r[10]  flop  sky130_fd_sc_hd__dfxtp_1  172.960  87.040  MX  PLACED  _33446_
i_lisa_core.i_bf16div.lampFPU_div0.lampFPU_fractDiv0.n_r[11]  flop  sky130_fd_sc_hd__dfxtp_1  170.200  92.480  MX  PLACED  _33447_
i_lisa_core.i_bf16div.lampFPU_div0.lampFPU_fractDiv0.n_r[12]  flop  sky130_fd_sc_hd__dfxtp_1  183.540  89.760  R0  PLACED  _33448_
i_lisa_core.i_bf16div.lampFPU_div0.lampFPU_fractDiv0.n_r[13]  flop  sky130_fd_sc_hd__dfxtp_1  166.060  97.920  MX  PLACED  _33449_
i_lisa_core.i_bf16div.lampFPU_div0.lampFPU_fractDiv0.n_r[14]  flop  sky130_fd_sc_hd__dfxtp_1  183.080  100.640  R0  PLACED  _33450_
i_lisa_core.i_bf16div.lampFPU_div0.lampFPU_fractDiv0.n_r[15]  flop  sky130_fd_sc_hd__dfxtp_1  156.400  106.080  R0  PLACED  _33451_
i_lisa_core.i_bf16div.lampFPU_div0.lampFPU_fractDiv0.n_r[1]  flop  sky130_fd_sc_hd__dfxtp_1  201.480  5.440  MX  PLACED  _33437_
i_lisa_core.i_bf16div.lampFPU_div0.lampFPU_fractDiv0.n_r[2]  flop  sky130_fd_sc_hd__dfxtp_1  201.940  8.160  R0  PLACED  _33438_
i_lisa_core.i_bf16div.lampFPU_div0.lampFPU_fractDiv0.n_r[3]  flop  sky130_fd_sc_hd__dfxtp_1  215.740  5.440  MX  PLACED  _33439_
i_lisa_core.i_bf16div.lampFPU_div0.lampFPU_fractDiv0.n_r[4]  flop  sky130_fd_sc_hd__dfxtp_1  157.780  21.760  MX  PLACED  _33440_
i_lisa_core.i_bf16div.lampFPU_div0.lampFPU_fractDiv0.n_r[5]  flop  sky130_fd_sc_hd__dfxtp_1  218.500  10.880  MX  PLACED  _33441_
i_lisa_core.i_bf16div.lampFPU_div0.lampFPU_fractDiv0.n_r[6]  flop  sky130_fd_sc_hd__dfxtp_1  161.920  24.480  R0  PLACED  _33442_
i_lisa_core.i_bf16div.lampFPU_div0.lampFPU_fractDiv0.n_r[7]  flop  sky130_fd_sc_hd__dfxtp_1  162.840  51.680  R0  PLACED  _33443_
i_lisa_core.i_bf16div.lampFPU_div0.lampFPU_fractDiv0.n_r[8]  flop  sky130_fd_sc_hd__dfxtp_1  182.620  84.320  R0  PLACED  _33444_
i_lisa_core.i_bf16div.lampFPU_div0.lampFPU_fractDiv0.n_r[9]  flop  sky130_fd_sc_hd__dfxtp_1  165.600  87.040  MX  PLACED  _33445_
i_lisa_core.i_bf16div.lampFPU_div0.lampFPU_fractDiv0.r_r[0]  flop  sky130_fd_sc_hd__dfxtp_1  84.640  100.640  R0  PLACED  _33468_
i_lisa_core.i_bf16div.lampFPU_div0.lampFPU_fractDiv0.r_r[10]  flop  sky130_fd_sc_hd__dfxtp_1  97.980  114.240  MX  PLACED  _33478_
i_lisa_core.i_bf16div.lampFPU_div0.lampFPU_fractDiv0.r_r[11]  flop  sky130_fd_sc_hd__dfxtp_1  90.160  114.240  MX  PLACED  _33479_
i_lisa_core.i_bf16div.lampFPU_div0.lampFPU_fractDiv0.r_r[12]  flop  sky130_fd_sc_hd__dfxtp_1  83.720  127.840  R0  PLACED  _33480_
i_lisa_core.i_bf16div.lampFPU_div0.lampFPU_fractDiv0.r_r[13]  flop  sky130_fd_sc_hd__dfxtp_1  93.380  122.400  R0  PLACED  _33481_
i_lisa_core.i_bf16div.lampFPU_div0.lampFPU_fractDiv0.r_r[14]  flop  sky130_fd_sc_hd__dfxtp_1  81.880  111.520  R0  PLACED  _33482_
i_lisa_core.i_bf16div.lampFPU_div0.lampFPU_fractDiv0.r_r[15]  flop  sky130_fd_sc_hd__dfxtp_1  85.100  106.080  R0  PLACED  _33483_
i_lisa_core.i_bf16div.lampFPU_div0.lampFPU_fractDiv0.r_r[1]  flop  sky130_fd_sc_hd__dfxtp_1  83.260  95.200  R0  PLACED  _33469_
i_lisa_core.i_bf16div.lampFPU_div0.lampFPU_fractDiv0.r_r[2]  flop  sky130_fd_sc_hd__dfxtp_1  85.560  81.600  MX  PLACED  _33470_
i_lisa_core.i_bf16div.lampFPU_div0.lampFPU_fractDiv0.r_r[3]  flop  sky130_fd_sc_hd__dfxtp_1  103.500  89.760  R0  PLACED  _33471_
i_lisa_core.i_bf16div.lampFPU_div0.lampFPU_fractDiv0.r_r[4]  flop  sky130_fd_sc_hd__dfxtp_1  93.840  81.600  MX  PLACED  _33472_
i_lisa_core.i_bf16div.lampFPU_div0.lampFPU_fractDiv0.r_r[5]  flop  sky130_fd_sc_hd__dfxtp_1  106.260  92.480  MX  PLACED  _33473_
i_lisa_core.i_bf16div.lampFPU_div0.lampFPU_fractDiv0.r_r[6]  flop  sky130_fd_sc_hd__dfxtp_1  85.560  89.760  R0  PLACED  _33474_
i_lisa_core.i_bf16div.lampFPU_div0.lampFPU_fractDiv0.r_r[7]  flop  sky130_fd_sc_hd__dfxtp_1  98.440  97.920  MX  PLACED  _33475_
i_lisa_core.i_bf16div.lampFPU_div0.lampFPU_fractDiv0.r_r[8]  flop  sky130_fd_sc_hd__dfxtp_1  96.600  103.360  MX  PLACED  _33476_
i_lisa_core.i_bf16div.lampFPU_div0.lampFPU_fractDiv0.r_r[9]  flop  sky130_fd_sc_hd__dfxtp_1  97.060  108.800  MX  PLACED  _33477_
i_lisa_core.i_bf16div.lampFPU_div0.lampFPU_fractDiv0.ss[0]  flop  sky130_fd_sc_hd__dfxtp_1  111.320  100.640  R0  PLACED  _34406_
i_lisa_core.i_bf16div.lampFPU_div0.lampFPU_fractDiv0.ss[1]  flop  sky130_fd_sc_hd__dfxtp_1  111.780  108.800  MX  PLACED  _34407_
i_lisa_core.i_bf16div.lampFPU_div0.lampFPU_fractDiv0.ss[2]  flop  sky130_fd_sc_hd__dfxtp_1  119.140  106.080  R0  PLACED  _34408_
i_lisa_core.i_bf16div.lampFPU_div0.nlz_op2_i[0]  flop  sky130_fd_sc_hd__dfxtp_1  187.680  106.080  R0  PLACED  _33345_
i_lisa_core.i_bf16div.lampFPU_div0.nlz_op2_i[1]  flop  sky130_fd_sc_hd__dfxtp_1  191.820  108.800  MX  PLACED  _33346_
i_lisa_core.i_bf16div.lampFPU_div0.nlz_op2_i[2]  flop  sky130_fd_sc_hd__dfxtp_1  121.900  111.520  R0  PLACED  _33347_
i_lisa_core.i_bf16div.lampFPU_div0.s_op1_i[0]  flop  sky130_fd_sc_hd__dfxtp_1  199.640  133.280  R0  PLACED  _33312_
i_lisa_core.i_bf16div.lampFPU_div0.s_op1_r[0]  flop  sky130_fd_sc_hd__dfxtp_1  208.840  127.840  R0  PLACED  _33367_
i_lisa_core.i_bf16div.lampFPU_div0.s_op2_i[0]  flop  sky130_fd_sc_hd__dfxtp_1  201.480  130.560  MX  PLACED  _33326_
i_lisa_core.i_bf16div.lampFPU_div0.s_op2_r[0]  flop  sky130_fd_sc_hd__dfxtp_1  212.980  130.560  MX  PLACED  _33372_
i_lisa_core.i_bf16div.rndMode_r  flop  sky130_fd_sc_hd__dfxtp_1  204.240  46.240  R0  PLACED  _33365_
i_lisa_core.i_bf16div.ss[0]  flop  sky130_fd_sc_hd__dfxtp_1  194.580  114.240  MX  PLACED  _34403_
i_lisa_core.i_bf16div.ss[1]  flop  sky130_fd_sc_hd__dfxtp_1  196.420  122.400  R0  PLACED  _34404_
i_lisa_core.ia[0]  flop  sky130_fd_sc_hd__dfrtp_1  315.100  345.440  R0  PLACED  _33260_
i_lisa_core.ia[10]  flop  sky130_fd_sc_hd__dfrtp_1  310.500  361.760  R0  PLACED  _33270_
i_lisa_core.ia[11]  flop  sky130_fd_sc_hd__dfrtp_1  327.520  361.760  R0  PLACED  _33271_
i_lisa_core.ia[12]  flop  sky130_fd_sc_hd__dfrtp_1  284.740  345.440  R0  PLACED  _33272_
i_lisa_core.ia[13]  flop  sky130_fd_sc_hd__dfrtp_1  289.340  353.600  MX  PLACED  _33273_
i_lisa_core.ia[14]  flop  sky130_fd_sc_hd__dfrtp_1  301.300  353.600  MX  PLACED  _33274_
i_lisa_core.ia[1]  flop  sky130_fd_sc_hd__dfrtp_1  284.740  329.120  R0  PLACED  _33261_
i_lisa_core.ia[2]  flop  sky130_fd_sc_hd__dfrtp_1  300.840  329.120  R0  PLACED  _33262_
i_lisa_core.ia[3]  flop  sky130_fd_sc_hd__dfrtp_1  325.220  307.360  R0  PLACED  _33263_
i_lisa_core.ia[4]  flop  sky130_fd_sc_hd__dfrtp_1  300.380  345.440  R0  PLACED  _33264_
i_lisa_core.ia[5]  flop  sky130_fd_sc_hd__dfrtp_1  286.580  337.280  MX  PLACED  _33265_
i_lisa_core.ia[6]  flop  sky130_fd_sc_hd__dfrtp_1  328.440  353.600  MX  PLACED  _33266_
i_lisa_core.ia[7]  flop  sky130_fd_sc_hd__dfrtp_1  302.680  337.280  MX  PLACED  _33267_
i_lisa_core.ia[8]  flop  sky130_fd_sc_hd__dfrtp_1  315.100  353.600  MX  PLACED  _33268_
i_lisa_core.ia[9]  flop  sky130_fd_sc_hd__dfrtp_1  329.360  345.440  R0  PLACED  _33269_
i_lisa_core.ie  flop  sky130_fd_sc_hd__dfrtp_1  218.500  288.320  MX  PLACED  _33275_
i_lisa_core.inst_r[0]  flop  sky130_fd_sc_hd__dfrtp_1  335.800  209.440  R0  PLACED  _34451_
i_lisa_core.inst_r[10]  flop  sky130_fd_sc_hd__dfrtp_1  356.960  204.000  R0  PLACED  _34461_
i_lisa_core.inst_r[11]  flop  sky130_fd_sc_hd__dfrtp_1  421.820  168.640  MX  PLACED  _34462_
i_lisa_core.inst_r[12]  flop  sky130_fd_sc_hd__dfrtp_1  356.040  214.880  R0  PLACED  _34463_
i_lisa_core.inst_r[13]  flop  sky130_fd_sc_hd__dfrtp_1  363.860  206.720  MX  PLACED  _34464_
i_lisa_core.inst_r[14]  flop  sky130_fd_sc_hd__dfrtp_1  341.320  225.760  R0  PLACED  _34465_
i_lisa_core.inst_r[15]  flop  sky130_fd_sc_hd__dfrtp_1  424.120  174.080  MX  PLACED  _34466_
i_lisa_core.inst_r[1]  flop  sky130_fd_sc_hd__dfrtp_1  423.660  179.520  MX  PLACED  _34452_
i_lisa_core.inst_r[2]  flop  sky130_fd_sc_hd__dfrtp_1  318.780  223.040  MX  PLACED  _34453_
i_lisa_core.inst_r[3]  flop  sky130_fd_sc_hd__dfrtp_1  413.540  171.360  R0  PLACED  _34454_
i_lisa_core.inst_r[4]  flop  sky130_fd_sc_hd__dfrtp_1  320.620  217.600  MX  PLACED  _34455_
i_lisa_core.inst_r[5]  flop  sky130_fd_sc_hd__dfrtp_1  328.440  223.040  MX  PLACED  _34456_
i_lisa_core.inst_r[6]  flop  sky130_fd_sc_hd__dfrtp_1  411.700  198.560  R0  PLACED  _34457_
i_lisa_core.inst_r[7]  flop  sky130_fd_sc_hd__dfrtp_1  344.540  212.160  MX  PLACED  _34458_
i_lisa_core.inst_r[8]  flop  sky130_fd_sc_hd__dfrtp_1  347.300  206.720  MX  PLACED  _34459_
i_lisa_core.inst_r[9]  flop  sky130_fd_sc_hd__dfrtp_1  338.100  223.040  MX  PLACED  _34460_
i_lisa_core.int_en[0]  flop  sky130_fd_sc_hd__dfxtp_1  440.680  454.240  R0  PLACED  _33501_
i_lisa_core.int_en[1]  flop  sky130_fd_sc_hd__dfxtp_1  436.540  443.360  R0  PLACED  _33502_
i_lisa_core.int_en[2]  flop  sky130_fd_sc_hd__dfxtp_1  428.260  454.240  R0  PLACED  _33503_
i_lisa_core.int_en[3]  flop  sky130_fd_sc_hd__dfxtp_1  379.500  467.840  MX  PLACED  _33504_
i_lisa_core.int_en[4]  flop  sky130_fd_sc_hd__dfxtp_1  409.400  448.800  R0  PLACED  _33505_
i_lisa_core.int_en[5]  flop  sky130_fd_sc_hd__dfxtp_1  420.440  459.680  R0  PLACED  _33506_
i_lisa_core.int_en[6]  flop  sky130_fd_sc_hd__dfxtp_1  410.320  459.680  R0  PLACED  _33507_
i_lisa_core.int_en[7]  flop  sky130_fd_sc_hd__dfxtp_1  441.140  462.400  MX  PLACED  _33508_
i_lisa_core.int_i[0]  flop  sky130_fd_sc_hd__dfxtp_1  419.520  437.920  R0  PLACED  _33591_
i_lisa_core.int_i[1]  flop  sky130_fd_sc_hd__dfxtp_1  416.300  427.040  R0  PLACED  _33592_
i_lisa_core.int_i[4]  flop  sky130_fd_sc_hd__dfxtp_1  396.980  473.280  MX  PLACED  _33593_
i_lisa_core.int_i[5]  flop  sky130_fd_sc_hd__dfxtp_1  407.100  435.200  MX  PLACED  _33594_
i_lisa_core.int_i[6]  flop  sky130_fd_sc_hd__dfxtp_1  358.800  470.560  R0  PLACED  _33695_
i_lisa_core.isr_jump  flop  sky130_fd_sc_hd__dfrtp_1  233.220  312.800  R0  PLACED  _33258_
i_lisa_core.ix[10]  flop  sky130_fd_sc_hd__dfxtp_1  174.800  416.160  R0  PLACED  _32684_
i_lisa_core.ix[11]  flop  sky130_fd_sc_hd__dfxtp_1  170.660  405.280  R0  PLACED  _32685_
i_lisa_core.ix[12]  flop  sky130_fd_sc_hd__dfxtp_1  183.540  418.880  MX  PLACED  _32686_
i_lisa_core.ix[13]  flop  sky130_fd_sc_hd__dfxtp_1  161.460  418.880  MX  PLACED  _32687_
i_lisa_core.ix[14]  flop  sky130_fd_sc_hd__dfxtp_1  169.740  418.880  MX  PLACED  _32688_
i_lisa_core.ix[8]  flop  sky130_fd_sc_hd__dfxtp_1  160.540  399.840  R0  PLACED  _32690_
i_lisa_core.ix[9]  flop  sky130_fd_sc_hd__dfxtp_1  159.620  408.000  MX  PLACED  _32691_
i_lisa_core.jump_taken_r  flop  sky130_fd_sc_hd__dfrtp_1  349.140  304.640  MX  PLACED  _34448_
i_lisa_core.lddiv_stage_two  flop  sky130_fd_sc_hd__dfxtp_1  165.600  255.680  MX  PLACED  _33243_
i_lisa_core.op_adc_r  flop  sky130_fd_sc_hd__dfrtp_1  83.720  282.880  MX  PLACED  _34507_
i_lisa_core.op_add_r  flop  sky130_fd_sc_hd__dfrtp_1  63.480  282.880  MX  PLACED  _34492_
i_lisa_core.op_addax_r  flop  sky130_fd_sc_hd__dfrtp_1  114.080  315.520  MX  PLACED  _34519_
i_lisa_core.op_addaxu_r  flop  sky130_fd_sc_hd__dfrtp_1  119.140  307.360  R0  PLACED  _34518_
i_lisa_core.op_ads_r  flop  sky130_fd_sc_hd__dfrtp_1  192.280  282.880  MX  PLACED  _34506_
i_lisa_core.op_adx_r  flop  sky130_fd_sc_hd__dfrtp_1  159.160  310.080  MX  PLACED  _34441_
i_lisa_core.op_amode_r  flop  sky130_fd_sc_hd__dfrtp_1  93.380  242.080  R0  PLACED  _34511_
i_lisa_core.op_and_r  flop  sky130_fd_sc_hd__dfrtp_1  6.440  272.000  MX  PLACED  _34484_
i_lisa_core.op_andi_r  flop  sky130_fd_sc_hd__dfrtp_1  16.100  263.840  R0  PLACED  _34471_
i_lisa_core.op_brk_r  flop  sky130_fd_sc_hd__dfrtp_1  242.420  266.560  MX  PLACED  _34499_
i_lisa_core.op_btst_r  flop  sky130_fd_sc_hd__dfrtp_1  122.360  282.880  MX  PLACED  _34478_
i_lisa_core.op_call_ix_r  flop  sky130_fd_sc_hd__dfrtp_1  184.000  293.760  MX  PLACED  _34514_
i_lisa_core.op_cmp_r  flop  sky130_fd_sc_hd__dfrtp_1  4.140  258.400  R0  PLACED  _34493_
i_lisa_core.op_cpi_r  flop  sky130_fd_sc_hd__dfrtp_1  116.380  288.320  MX  PLACED  _34491_
i_lisa_core.op_cpx_ra_r  flop  sky130_fd_sc_hd__dfrtp_1  138.920  304.640  MX  PLACED  _34530_
i_lisa_core.op_cpx_sp_r  flop  sky130_fd_sc_hd__dfrtp_1  151.340  291.040  R0  PLACED  _34440_
i_lisa_core.op_dcx_r  flop  sky130_fd_sc_hd__dfrtp_1  85.100  299.200  MX  PLACED  _34536_
i_lisa_core.op_div_r  flop  sky130_fd_sc_hd__dfrtp_1  140.760  266.560  MX  PLACED  _34503_
i_lisa_core.op_eidi_r  flop  sky130_fd_sc_hd__dfrtp_1  201.940  274.720  R0  PLACED  _34528_
i_lisa_core.op_fadd_r  flop  sky130_fd_sc_hd__dfrtp_1  107.180  239.360  MX  PLACED  _34486_
i_lisa_core.op_fclr_r  flop  sky130_fd_sc_hd__dfrtp_1  151.800  225.760  R0  PLACED  _34467_
i_lisa_core.op_fcmp_r  flop  sky130_fd_sc_hd__dfrtp_1  119.600  242.080  R0  PLACED  _34474_
i_lisa_core.op_fdiv_r  flop  sky130_fd_sc_hd__dfxtp_1  179.400  247.520  R0  PLACED  _33277_
i_lisa_core.op_fmul_r  flop  sky130_fd_sc_hd__dfrtp_1  121.440  239.360  MX  PLACED  _34505_
i_lisa_core.op_fneg_r  flop  sky130_fd_sc_hd__dfrtp_1  171.120  242.080  R0  PLACED  _34482_
i_lisa_core.op_fswap_r  flop  sky130_fd_sc_hd__dfrtp_1  128.800  242.080  R0  PLACED  _34538_
i_lisa_core.op_ftoi_r  flop  sky130_fd_sc_hd__dfrtp_1  148.120  228.480  MX  PLACED  _34522_
i_lisa_core.op_if_r  flop  sky130_fd_sc_hd__dfrtp_1  185.840  277.440  MX  PLACED  _34494_
i_lisa_core.op_inx_r  flop  sky130_fd_sc_hd__dfrtp_1  76.820  296.480  R0  PLACED  _34539_
i_lisa_core.op_itof_r  flop  sky130_fd_sc_hd__dfrtp_1  138.920  228.480  MX  PLACED  _34497_
i_lisa_core.op_jmp_ix_r  flop  sky130_fd_sc_hd__dfrtp_1  173.880  299.200  MX  PLACED  _34500_
i_lisa_core.op_ld_misc_r  flop  sky130_fd_sc_hd__dfrtp_1  87.400  250.240  MX  PLACED  _34535_
i_lisa_core.op_lda_r  flop  sky130_fd_sc_hd__dfrtp_1  57.960  269.280  R0  PLACED  _34537_
i_lisa_core.op_ldac_r  flop  sky130_fd_sc_hd__dfrtp_1  107.640  244.800  MX  PLACED  _34533_
i_lisa_core.op_ldamode_r  flop  sky130_fd_sc_hd__dfrtp_1  122.360  250.240  MX  PLACED  _34488_
i_lisa_core.op_ldax_r  flop  sky130_fd_sc_hd__dfrtp_1  59.340  272.000  MX  PLACED  _34540_
i_lisa_core.op_ldc_r  flop  sky130_fd_sc_hd__dfrtp_1  119.140  272.000  MX  PLACED  _34447_
i_lisa_core.op_lddiv_r  flop  sky130_fd_sc_hd__dfrtp_1  144.900  250.240  MX  PLACED  _34512_
i_lisa_core.op_ldi_r  flop  sky130_fd_sc_hd__dfrtp_1  93.380  280.160  R0  PLACED  _34501_
i_lisa_core.op_ldirq_r  flop  sky130_fd_sc_hd__dfrtp_1  81.420  247.520  R0  PLACED  _34469_
i_lisa_core.op_ldx_r  flop  sky130_fd_sc_hd__dfrtp_1  154.560  269.280  R0  PLACED  _34521_
i_lisa_core.op_ldxx_r  flop  sky130_fd_sc_hd__dfrtp_1  186.760  263.840  R0  PLACED  _34541_
i_lisa_core.op_ldz_r  flop  sky130_fd_sc_hd__dfrtp_1  139.840  282.880  MX  PLACED  _34516_
i_lisa_core.op_lra_r  flop  sky130_fd_sc_hd__dfrtp_1  186.760  252.960  R0  PLACED  _34485_
i_lisa_core.op_mul_r  flop  sky130_fd_sc_hd__dfrtp_1  20.240  274.720  R0  PLACED  _34489_
i_lisa_core.op_mulu_r  flop  sky130_fd_sc_hd__dfrtp_1  51.980  280.160  R0  PLACED  _34490_
i_lisa_core.op_notz_r  flop  sky130_fd_sc_hd__dfrtp_1  127.880  274.720  R0  PLACED  _34532_
i_lisa_core.op_or_r  flop  sky130_fd_sc_hd__dfrtp_1  5.520  269.280  R0  PLACED  _34476_
i_lisa_core.op_pop_a_r  flop  sky130_fd_sc_hd__dfrtp_1  177.560  252.960  R0  PLACED  _34510_
i_lisa_core.op_pop_ix_r  flop  sky130_fd_sc_hd__dfrtp_1  189.520  255.680  MX  PLACED  _34473_
i_lisa_core.op_push_a_r  flop  sky130_fd_sc_hd__dfrtp_1  180.780  258.400  R0  PLACED  _34523_
i_lisa_core.op_push_ix_r  flop  sky130_fd_sc_hd__dfrtp_1  103.040  247.520  R0  PLACED  _34472_
i_lisa_core.op_rem_r  flop  sky130_fd_sc_hd__dfrtp_1  139.380  272.000  MX  PLACED  _34508_
i_lisa_core.op_restc_r  flop  sky130_fd_sc_hd__dfrtp_1  130.640  269.280  R0  PLACED  _34487_
i_lisa_core.op_reti_r  flop  sky130_fd_sc_hd__dfrtp_1  117.760  304.640  MX  PLACED  _34509_
i_lisa_core.op_savec_r  flop  sky130_fd_sc_hd__dfrtp_1  87.400  244.800  MX  PLACED  _34513_
i_lisa_core.op_shl16_r  flop  sky130_fd_sc_hd__dfrtp_1  83.720  304.640  MX  PLACED  _34443_
i_lisa_core.op_shl_r  flop  sky130_fd_sc_hd__dfrtp_1  81.880  258.400  R0  PLACED  _34524_
i_lisa_core.op_shr16_r  flop  sky130_fd_sc_hd__dfrtp_1  93.380  340.000  R0  PLACED  _34520_
i_lisa_core.op_shr_r  flop  sky130_fd_sc_hd__dfrtp_1  116.840  261.120  MX  PLACED  _34496_
i_lisa_core.op_spix_r  flop  sky130_fd_sc_hd__dfrtp_1  207.000  263.840  R0  PLACED  _34531_
i_lisa_core.op_sra_r  flop  sky130_fd_sc_hd__dfrtp_1  185.840  250.240  MX  PLACED  _34483_
i_lisa_core.op_st_r  flop  sky130_fd_sc_hd__dfrtp_1  179.400  285.600  R0  PLACED  _34475_
i_lisa_core.op_sta_r  flop  sky130_fd_sc_hd__dfrtp_1  157.780  277.440  MX  PLACED  _34477_
i_lisa_core.op_stirq_r  flop  sky130_fd_sc_hd__dfrtp_1  199.640  277.440  MX  PLACED  _34470_
i_lisa_core.op_stxx_r  flop  sky130_fd_sc_hd__dfrtp_1  189.520  266.560  MX  PLACED  _34450_
i_lisa_core.op_sub_r  flop  sky130_fd_sc_hd__dfrtp_1  17.020  272.000  MX  PLACED  _34479_
i_lisa_core.op_subax_r  flop  sky130_fd_sc_hd__dfrtp_1  111.780  310.080  MX  PLACED  _34504_
i_lisa_core.op_subaxu_r  flop  sky130_fd_sc_hd__dfrtp_1  120.980  310.080  MX  PLACED  _34502_
i_lisa_core.op_swap_r  flop  sky130_fd_sc_hd__dfrtp_1  68.080  280.160  R0  PLACED  _34480_
i_lisa_core.op_swapi_r  flop  sky130_fd_sc_hd__dfrtp_1  69.000  272.000  MX  PLACED  _34481_
i_lisa_core.op_taf_r  flop  sky130_fd_sc_hd__dfrtp_1  175.720  236.640  R0  PLACED  _34449_
i_lisa_core.op_tax_r  flop  sky130_fd_sc_hd__dfrtp_1  144.900  247.520  R0  PLACED  _34517_
i_lisa_core.op_taxu_r  flop  sky130_fd_sc_hd__dfrtp_1  132.020  310.080  MX  PLACED  _34515_
i_lisa_core.op_tfa_r  flop  sky130_fd_sc_hd__dfrtp_1  132.020  244.800  MX  PLACED  _34525_
i_lisa_core.op_txa_r  flop  sky130_fd_sc_hd__dfrtp_1  126.500  263.840  R0  PLACED  _34468_
i_lisa_core.op_txau_r  flop  sky130_fd_sc_hd__dfrtp_1  122.360  266.560  MX  PLACED  _34526_
i_lisa_core.op_xchg_ia_r  flop  sky130_fd_sc_hd__dfrtp_1  200.100  269.280  R0  PLACED  _34529_
i_lisa_core.op_xchg_ra_r  flop  sky130_fd_sc_hd__dfrtp_1  195.040  310.080  MX  PLACED  _34527_
i_lisa_core.op_xchg_sp_r  flop  sky130_fd_sc_hd__dfrtp_1  209.300  266.560  MX  PLACED  _34498_
i_lisa_core.op_xor_r  flop  sky130_fd_sc_hd__dfrtp_1  6.440  263.840  R0  PLACED  _34534_
i_lisa_core.pc[0]  flop  sky130_fd_sc_hd__dfrtp_1  385.020  356.320  R0  PLACED  _32662_
i_lisa_core.pc[10]  flop  sky130_fd_sc_hd__dfrtp_1  390.540  353.600  MX  PLACED  _32672_
i_lisa_core.pc[11]  flop  sky130_fd_sc_hd__dfrtp_1  389.620  345.440  R0  PLACED  _32673_
i_lisa_core.pc[12]  flop  sky130_fd_sc_hd__dfrtp_1  391.000  350.880  R0  PLACED  _32674_
i_lisa_core.pc[13]  flop  sky130_fd_sc_hd__dfrtp_1  391.460  359.040  MX  PLACED  _32675_
i_lisa_core.pc[14]  flop  sky130_fd_sc_hd__dfrtp_1  353.280  359.040  MX  PLACED  _32676_
i_lisa_core.pc[1]  flop  sky130_fd_sc_hd__dfrtp_1  379.040  315.520  MX  PLACED  _32663_
i_lisa_core.pc[2]  flop  sky130_fd_sc_hd__dfrtp_1  376.740  307.360  R0  PLACED  _32664_
i_lisa_core.pc[3]  flop  sky130_fd_sc_hd__dfrtp_1  371.680  310.080  MX  PLACED  _32665_
i_lisa_core.pc[4]  flop  sky130_fd_sc_hd__dfrtp_1  378.120  329.120  R0  PLACED  _32666_
i_lisa_core.pc[5]  flop  sky130_fd_sc_hd__dfrtp_1  386.860  334.560  R0  PLACED  _32667_
i_lisa_core.pc[6]  flop  sky130_fd_sc_hd__dfrtp_1  379.960  326.400  MX  PLACED  _32668_
i_lisa_core.pc[7]  flop  sky130_fd_sc_hd__dfrtp_1  380.420  345.440  R0  PLACED  _32669_
i_lisa_core.pc[8]  flop  sky130_fd_sc_hd__dfrtp_1  354.660  367.200  R0  PLACED  _32670_
i_lisa_core.pc[9]  flop  sky130_fd_sc_hd__dfrtp_1  361.560  307.360  R0  PLACED  _32671_
i_lisa_core.predec_state  flop  sky130_fd_sc_hd__dfrtp_1  253.920  285.600  R0  PLACED  _34401_
i_lisa_core.ra[0]  flop  sky130_fd_sc_hd__dfxtp_1  269.560  386.240  MX  PLACED  _32699_
i_lisa_core.ra[10]  flop  sky130_fd_sc_hd__dfxtp_1  254.840  394.400  R0  PLACED  _32692_
i_lisa_core.ra[11]  flop  sky130_fd_sc_hd__dfxtp_1  253.000  386.240  MX  PLACED  _32693_
i_lisa_core.ra[12]  flop  sky130_fd_sc_hd__dfxtp_1  260.820  383.520  R0  PLACED  _32694_
i_lisa_core.ra[13]  flop  sky130_fd_sc_hd__dfxtp_1  260.820  378.080  R0  PLACED  _32695_
i_lisa_core.ra[14]  flop  sky130_fd_sc_hd__dfxtp_1  251.160  378.080  R0  PLACED  _32696_
i_lisa_core.ra[1]  flop  sky130_fd_sc_hd__dfxtp_1  282.900  394.400  R0  PLACED  _32700_
i_lisa_core.ra[2]  flop  sky130_fd_sc_hd__dfxtp_1  280.140  388.960  R0  PLACED  _32701_
i_lisa_core.ra[3]  flop  sky130_fd_sc_hd__dfxtp_1  271.860  397.120  MX  PLACED  _32702_
i_lisa_core.ra[4]  flop  sky130_fd_sc_hd__dfxtp_1  276.920  402.560  MX  PLACED  _32703_
i_lisa_core.ra[5]  flop  sky130_fd_sc_hd__dfxtp_1  268.640  402.560  MX  PLACED  _32704_
i_lisa_core.ra[6]  flop  sky130_fd_sc_hd__dfxtp_1  287.040  402.560  MX  PLACED  _32705_
i_lisa_core.ra[7]  flop  sky130_fd_sc_hd__dfxtp_1  239.660  405.280  R0  PLACED  _32706_
i_lisa_core.ra[8]  flop  sky130_fd_sc_hd__dfxtp_1  249.320  405.280  R0  PLACED  _32697_
i_lisa_core.ra[9]  flop  sky130_fd_sc_hd__dfxtp_1  248.860  397.120  MX  PLACED  _32698_
i_lisa_core.rem_stage_two  flop  sky130_fd_sc_hd__dfxtp_1  149.960  315.520  MX  PLACED  _33245_
i_lisa_core.ret_isr_r  flop  sky130_fd_sc_hd__dfrtp_1  173.880  250.240  MX  PLACED  _34444_
i_lisa_core.ret_taken_r  flop  sky130_fd_sc_hd__dfrtp_1  180.780  301.920  R0  PLACED  _34445_
i_lisa_core.signed_inv_isr  flop  sky130_fd_sc_hd__dfrtp_1  45.080  250.240  MX  PLACED  _33256_
i_lisa_core.signed_inv_live_isr  flop  sky130_fd_sc_hd__dfrtp_1  93.380  285.600  R0  PLACED  _33255_
i_lisa_core.signed_inv_save  flop  sky130_fd_sc_hd__dfxtp_1  57.500  258.400  R0  PLACED  _33206_
i_lisa_core.sp[0]  flop  sky130_fd_sc_hd__dfxtp_1  236.900  261.120  MX  PLACED  _33227_
i_lisa_core.sp[10]  flop  sky130_fd_sc_hd__dfxtp_1  284.280  263.840  R0  PLACED  _33237_
i_lisa_core.sp[11]  flop  sky130_fd_sc_hd__dfxtp_1  254.380  269.280  R0  PLACED  _33238_
i_lisa_core.sp[12]  flop  sky130_fd_sc_hd__dfxtp_1  287.960  274.720  R0  PLACED  _33239_
i_lisa_core.sp[13]  flop  sky130_fd_sc_hd__dfxtp_1  247.940  274.720  R0  PLACED  _33240_
i_lisa_core.sp[14]  flop  sky130_fd_sc_hd__dfxtp_1  288.880  280.160  R0  PLACED  _33241_
i_lisa_core.sp[1]  flop  sky130_fd_sc_hd__dfxtp_1  247.020  261.120  MX  PLACED  _33228_
i_lisa_core.sp[2]  flop  sky130_fd_sc_hd__dfxtp_1  253.920  252.960  R0  PLACED  _33229_
i_lisa_core.sp[3]  flop  sky130_fd_sc_hd__dfxtp_1  218.500  233.920  MX  PLACED  _33230_
i_lisa_core.sp[4]  flop  sky130_fd_sc_hd__dfxtp_1  251.620  233.920  MX  PLACED  _33231_
i_lisa_core.sp[5]  flop  sky130_fd_sc_hd__dfxtp_1  269.560  223.040  MX  PLACED  _33232_
i_lisa_core.sp[6]  flop  sky130_fd_sc_hd__dfxtp_1  279.220  225.760  R0  PLACED  _33233_
i_lisa_core.sp[7]  flop  sky130_fd_sc_hd__dfxtp_1  283.820  236.640  R0  PLACED  _33234_
i_lisa_core.sp[8]  flop  sky130_fd_sc_hd__dfxtp_1  284.280  247.520  R0  PLACED  _33235_
i_lisa_core.sp[9]  flop  sky130_fd_sc_hd__dfxtp_1  286.120  252.960  R0  PLACED  _33236_
i_lisa_core.stage_two  flop  sky130_fd_sc_hd__dfrtp_1  232.300  263.840  R0  PLACED  _33259_
i_lisa_core.stg2_state  flop  sky130_fd_sc_hd__dfrtp_1  226.780  274.720  R0  PLACED  _34399_
i_lisa_core.zflag_isr  flop  sky130_fd_sc_hd__dfrtp_1  83.720  291.040  R0  PLACED  _33257_
i_lisa_io_mux.ce_last[0]  flop  sky130_fd_sc_hd__dfxtp_1  522.100  402.560  MX  PLACED  _34547_
i_lisa_io_mux.ce_last[1]  flop  sky130_fd_sc_hd__dfxtp_1  532.220  413.440  MX  PLACED  _34548_
i_lisa_io_mux.ce_last_n[0]  flop  sky130_fd_sc_hd__dfxtp_1  518.420  405.280  R0  PLACED  _34551_
i_lisa_io_mux.ce_last_n[1]  flop  sky130_fd_sc_hd__dfxtp_1  533.140  410.720  R0  PLACED  _34552_
i_lisa_io_mux.last_mux[0]  flop  sky130_fd_sc_hd__dfxtp_1  521.640  413.440  MX  PLACED  _34545_
i_lisa_io_mux.last_mux[1]  flop  sky130_fd_sc_hd__dfxtp_1  519.340  410.720  R0  PLACED  _34546_
i_lisa_io_mux.last_mux_n[0]  flop  sky130_fd_sc_hd__dfxtp_1  513.360  416.160  R0  PLACED  _34549_
i_lisa_io_mux.last_mux_n[1]  flop  sky130_fd_sc_hd__dfxtp_1  500.020  413.440  MX  PLACED  _34550_
i_lisa_io_mux.lisa_portb_i[0]  flop  sky130_fd_sc_hd__dfxtp_1  341.780  435.200  MX  PLACED  _33485_
i_lisa_io_mux.lisa_portb_i[1]  flop  sky130_fd_sc_hd__dfxtp_1  390.080  435.200  MX  PLACED  _33486_
i_lisa_io_mux.lisa_portb_i[2]  flop  sky130_fd_sc_hd__dfxtp_1  401.120  418.880  MX  PLACED  _33487_
i_lisa_io_mux.lisa_portb_i[3]  flop  sky130_fd_sc_hd__dfxtp_1  346.840  429.760  MX  PLACED  _33488_
i_lisa_io_mux.lisa_portb_i[4]  flop  sky130_fd_sc_hd__dfxtp_1  380.420  429.760  MX  PLACED  _33489_
i_lisa_io_mux.lisa_portb_i[5]  flop  sky130_fd_sc_hd__dfxtp_1  410.780  405.280  R0  PLACED  _33490_
i_lisa_io_mux.lisa_portb_i[6]  flop  sky130_fd_sc_hd__dfxtp_1  405.260  408.000  MX  PLACED  _33491_
i_lisa_io_mux.lisa_portb_i[7]  flop  sky130_fd_sc_hd__dfxtp_1  407.100  416.160  R0  PLACED  _33492_
i_lisa_io_mux.lisa_portc_dir_i[0]  flop  sky130_fd_sc_hd__dfxtp_1  318.320  429.760  MX  PLACED  _33497_
i_lisa_io_mux.lisa_portc_dir_i[1]  flop  sky130_fd_sc_hd__dfxtp_1  293.940  429.760  MX  PLACED  _33498_
i_lisa_io_mux.lisa_portc_dir_i[2]  flop  sky130_fd_sc_hd__dfxtp_1  299.460  421.600  R0  PLACED  _33499_
i_lisa_io_mux.lisa_portc_dir_i[3]  flop  sky130_fd_sc_hd__dfxtp_1  315.100  421.600  R0  PLACED  _33500_
i_lisa_io_mux.lisa_portc_i[0]  flop  sky130_fd_sc_hd__dfxtp_1  304.520  429.760  MX  PLACED  _33493_
i_lisa_io_mux.lisa_portc_i[1]  flop  sky130_fd_sc_hd__dfxtp_1  283.360  427.040  R0  PLACED  _33494_
i_lisa_io_mux.lisa_portc_i[2]  flop  sky130_fd_sc_hd__dfxtp_1  287.960  421.600  R0  PLACED  _33495_
i_lisa_io_mux.lisa_portc_i[3]  flop  sky130_fd_sc_hd__dfxtp_1  324.300  424.320  MX  PLACED  _33496_
i_lisa_io_mux.sclk  flop  sky130_fd_sc_hd__dfxtp_1  462.300  399.840  R0  PLACED  _33931_
i_lisa_io_mux.sio0_si_mosi_o  flop  sky130_fd_sc_hd__dfxtp_1  484.840  402.560  MX  PLACED  _33936_
i_lisa_io_mux.sio1_so_miso_o  flop  sky130_fd_sc_hd__dfxtp_1  493.580  405.280  R0  PLACED  _33937_
i_lisa_io_mux.sio2_o  flop  sky130_fd_sc_hd__dfxtp_1  470.120  402.560  MX  PLACED  _33938_
i_lisa_io_mux.sio3_o  flop  sky130_fd_sc_hd__dfxtp_1  469.200  405.280  R0  PLACED  _33939_
i_lisa_io_mux.sio_oe[0]  flop  sky130_fd_sc_hd__dfxtp_1  510.140  405.280  R0  PLACED  _33932_
i_lisa_io_mux.sio_oe[1]  flop  sky130_fd_sc_hd__dfxtp_1  501.400  402.560  MX  PLACED  _33933_
i_lisa_io_mux.ttlc_io_latch  flop  sky130_fd_sc_hd__dfxtp_1  540.500  410.720  R0  PLACED  _34001_
i_lisa_io_mux.ttlc_io_shiftclk  flop  sky130_fd_sc_hd__dfxtp_1  570.860  410.720  R0  PLACED  _34002_
i_lisa_io_mux.uart2_tx  flop  sky130_fd_sc_hd__dfxtp_1  302.680  495.040  MX  PLACED  _33884_
i_lisa_periph.i_lisa_i2c.ack  flop  sky130_fd_sc_hd__dfxtp_1  316.940  465.120  R0  PLACED  _33728_
i_lisa_periph.i_lisa_i2c.al  flop  sky130_fd_sc_hd__dfxtp_1  330.280  470.560  R0  PLACED  _33698_
i_lisa_periph.i_lisa_i2c.byte_controller.ack_out  flop  sky130_fd_sc_hd__dfxtp_1  288.420  467.840  MX  PLACED  _33732_
i_lisa_periph.i_lisa_i2c.byte_controller.bit_controller.al  flop  sky130_fd_sc_hd__dfxtp_1  232.300  465.120  R0  PLACED  _33750_
i_lisa_periph.i_lisa_i2c.byte_controller.bit_controller.busy  flop  sky130_fd_sc_hd__dfxtp_1  227.240  462.400  MX  PLACED  _33752_
i_lisa_periph.i_lisa_i2c.byte_controller.bit_controller.cSCL[0]  flop  sky130_fd_sc_hd__dfxtp_1  214.360  427.040  R0  PLACED  _33779_
i_lisa_periph.i_lisa_i2c.byte_controller.bit_controller.cSCL[1]  flop  sky130_fd_sc_hd__dfxtp_1  214.820  429.760  MX  PLACED  _33780_
i_lisa_periph.i_lisa_i2c.byte_controller.bit_controller.cSDA[0]  flop  sky130_fd_sc_hd__dfxtp_1  206.080  432.480  R0  PLACED  _33781_
i_lisa_periph.i_lisa_i2c.byte_controller.bit_controller.cSDA[1]  flop  sky130_fd_sc_hd__dfxtp_1  201.020  435.200  MX  PLACED  _33782_
i_lisa_periph.i_lisa_i2c.byte_controller.bit_controller.c_state[0]  flop  sky130_fd_sc_hd__dfxtp_1  241.500  478.720  MX  PLACED  _32455_
i_lisa_periph.i_lisa_i2c.byte_controller.bit_controller.c_state[10]  flop  sky130_fd_sc_hd__dfxtp_1  242.880  500.480  MX  PLACED  _32465_
i_lisa_periph.i_lisa_i2c.byte_controller.bit_controller.c_state[11]  flop  sky130_fd_sc_hd__dfxtp_1  240.120  503.200  R0  PLACED  _32466_
i_lisa_periph.i_lisa_i2c.byte_controller.bit_controller.c_state[12]  flop  sky130_fd_sc_hd__dfxtp_1  230.460  503.200  R0  PLACED  _32467_
i_lisa_periph.i_lisa_i2c.byte_controller.bit_controller.c_state[13]  flop  sky130_fd_sc_hd__dfxtp_1  241.960  489.600  MX  PLACED  _32468_
i_lisa_periph.i_lisa_i2c.byte_controller.bit_controller.c_state[14]  flop  sky130_fd_sc_hd__dfxtp_1  218.960  500.480  MX  PLACED  _32469_
i_lisa_periph.i_lisa_i2c.byte_controller.bit_controller.c_state[15]  flop  sky130_fd_sc_hd__dfxtp_1  188.600  503.200  R0  PLACED  _32470_
i_lisa_periph.i_lisa_i2c.byte_controller.bit_controller.c_state[16]  flop  sky130_fd_sc_hd__dfxtp_1  201.020  503.200  R0  PLACED  _32471_
i_lisa_periph.i_lisa_i2c.byte_controller.bit_controller.c_state[1]  flop  sky130_fd_sc_hd__dfxtp_1  211.600  473.280  MX  PLACED  _32456_
i_lisa_periph.i_lisa_i2c.byte_controller.bit_controller.c_state[2]  flop  sky130_fd_sc_hd__dfxtp_1  200.560  476.000  R0  PLACED  _32457_
i_lisa_periph.i_lisa_i2c.byte_controller.bit_controller.c_state[3]  flop  sky130_fd_sc_hd__dfxtp_1  195.040  478.720  MX  PLACED  _32458_
i_lisa_periph.i_lisa_i2c.byte_controller.bit_controller.c_state[4]  flop  sky130_fd_sc_hd__dfxtp_1  189.060  484.160  MX  PLACED  _32459_
i_lisa_periph.i_lisa_i2c.byte_controller.bit_controller.c_state[5]  flop  sky130_fd_sc_hd__dfxtp_1  237.360  484.160  MX  PLACED  _32460_
i_lisa_periph.i_lisa_i2c.byte_controller.bit_controller.c_state[6]  flop  sky130_fd_sc_hd__dfxtp_1  182.160  486.880  R0  PLACED  _32461_
i_lisa_periph.i_lisa_i2c.byte_controller.bit_controller.c_state[7]  flop  sky130_fd_sc_hd__dfxtp_1  187.220  492.320  R0  PLACED  _32462_
i_lisa_periph.i_lisa_i2c.byte_controller.bit_controller.c_state[8]  flop  sky130_fd_sc_hd__dfxtp_1  187.680  500.480  MX  PLACED  _32463_
i_lisa_periph.i_lisa_i2c.byte_controller.bit_controller.c_state[9]  flop  sky130_fd_sc_hd__dfxtp_1  244.720  495.040  MX  PLACED  _32464_
i_lisa_periph.i_lisa_i2c.byte_controller.bit_controller.clk_cnt[0]  flop  sky130_fd_sc_hd__dfxtp_1  314.180  451.520  MX  PLACED  _33707_
i_lisa_periph.i_lisa_i2c.byte_controller.bit_controller.clk_cnt[10]  flop  sky130_fd_sc_hd__dfxtp_1  289.800  440.640  MX  PLACED  _33701_
i_lisa_periph.i_lisa_i2c.byte_controller.bit_controller.clk_cnt[11]  flop  sky130_fd_sc_hd__dfxtp_1  313.720  437.920  R0  PLACED  _33702_
i_lisa_periph.i_lisa_i2c.byte_controller.bit_controller.clk_cnt[12]  flop  sky130_fd_sc_hd__dfxtp_1  304.520  435.200  MX  PLACED  _33703_
i_lisa_periph.i_lisa_i2c.byte_controller.bit_controller.clk_cnt[13]  flop  sky130_fd_sc_hd__dfxtp_1  296.240  435.200  MX  PLACED  _33704_
i_lisa_periph.i_lisa_i2c.byte_controller.bit_controller.clk_cnt[14]  flop  sky130_fd_sc_hd__dfxtp_1  287.960  446.080  MX  PLACED  _33705_
i_lisa_periph.i_lisa_i2c.byte_controller.bit_controller.clk_cnt[15]  flop  sky130_fd_sc_hd__dfxtp_1  299.460  443.360  R0  PLACED  _33706_
i_lisa_periph.i_lisa_i2c.byte_controller.bit_controller.clk_cnt[1]  flop  sky130_fd_sc_hd__dfxtp_1  298.540  456.960  MX  PLACED  _33708_
i_lisa_periph.i_lisa_i2c.byte_controller.bit_controller.clk_cnt[2]  flop  sky130_fd_sc_hd__dfxtp_1  314.180  456.960  MX  PLACED  _33709_
i_lisa_periph.i_lisa_i2c.byte_controller.bit_controller.clk_cnt[3]  flop  sky130_fd_sc_hd__dfxtp_1  315.100  443.360  R0  PLACED  _33710_
i_lisa_periph.i_lisa_i2c.byte_controller.bit_controller.clk_cnt[4]  flop  sky130_fd_sc_hd__dfxtp_1  306.360  459.680  R0  PLACED  _33711_
i_lisa_periph.i_lisa_i2c.byte_controller.bit_controller.clk_cnt[5]  flop  sky130_fd_sc_hd__dfxtp_1  304.520  451.520  MX  PLACED  _33712_
i_lisa_periph.i_lisa_i2c.byte_controller.bit_controller.clk_cnt[6]  flop  sky130_fd_sc_hd__dfxtp_1  307.740  443.360  R0  PLACED  _33713_
i_lisa_periph.i_lisa_i2c.byte_controller.bit_controller.clk_cnt[7]  flop  sky130_fd_sc_hd__dfxtp_1  294.860  451.520  MX  PLACED  _33714_
i_lisa_periph.i_lisa_i2c.byte_controller.bit_controller.clk_cnt[8]  flop  sky130_fd_sc_hd__dfxtp_1  304.520  440.640  MX  PLACED  _33699_
i_lisa_periph.i_lisa_i2c.byte_controller.bit_controller.clk_cnt[9]  flop  sky130_fd_sc_hd__dfxtp_1  287.500  432.480  R0  PLACED  _33700_
i_lisa_periph.i_lisa_i2c.byte_controller.bit_controller.clk_en  flop  sky130_fd_sc_hd__dfxtp_1  252.540  467.840  MX  PLACED  _33783_
i_lisa_periph.i_lisa_i2c.byte_controller.bit_controller.cmd_ack  flop  sky130_fd_sc_hd__dfxtp_1  248.860  484.160  MX  PLACED  _33745_
i_lisa_periph.i_lisa_i2c.byte_controller.bit_controller.cmd_stop  flop  sky130_fd_sc_hd__dfxtp_1  236.440  470.560  R0  PLACED  _33751_
i_lisa_periph.i_lisa_i2c.byte_controller.bit_controller.cnt[0]  flop  sky130_fd_sc_hd__dfxtp_1  285.200  454.240  R0  PLACED  _33784_
i_lisa_periph.i_lisa_i2c.byte_controller.bit_controller.cnt[10]  flop  sky130_fd_sc_hd__dfxtp_1  266.800  440.640  MX  PLACED  _33794_
i_lisa_periph.i_lisa_i2c.byte_controller.bit_controller.cnt[11]  flop  sky130_fd_sc_hd__dfxtp_1  265.420  432.480  R0  PLACED  _33795_
i_lisa_periph.i_lisa_i2c.byte_controller.bit_controller.cnt[12]  flop  sky130_fd_sc_hd__dfxtp_1  276.920  435.200  MX  PLACED  _33796_
i_lisa_periph.i_lisa_i2c.byte_controller.bit_controller.cnt[13]  flop  sky130_fd_sc_hd__dfxtp_1  253.000  440.640  MX  PLACED  _33797_
i_lisa_periph.i_lisa_i2c.byte_controller.bit_controller.cnt[14]  flop  sky130_fd_sc_hd__dfxtp_1  252.540  446.080  MX  PLACED  _33798_
i_lisa_periph.i_lisa_i2c.byte_controller.bit_controller.cnt[15]  flop  sky130_fd_sc_hd__dfxtp_1  247.940  459.680  R0  PLACED  _33799_
i_lisa_periph.i_lisa_i2c.byte_controller.bit_controller.cnt[1]  flop  sky130_fd_sc_hd__dfxtp_1  293.020  462.400  MX  PLACED  _33785_
i_lisa_periph.i_lisa_i2c.byte_controller.bit_controller.cnt[2]  flop  sky130_fd_sc_hd__dfxtp_1  279.220  465.120  R0  PLACED  _33786_
i_lisa_periph.i_lisa_i2c.byte_controller.bit_controller.cnt[3]  flop  sky130_fd_sc_hd__dfxtp_1  259.440  465.120  R0  PLACED  _33787_
i_lisa_periph.i_lisa_i2c.byte_controller.bit_controller.cnt[4]  flop  sky130_fd_sc_hd__dfxtp_1  270.480  462.400  MX  PLACED  _33788_
i_lisa_periph.i_lisa_i2c.byte_controller.bit_controller.cnt[5]  flop  sky130_fd_sc_hd__dfxtp_1  260.820  454.240  R0  PLACED  _33789_
i_lisa_periph.i_lisa_i2c.byte_controller.bit_controller.cnt[6]  flop  sky130_fd_sc_hd__dfxtp_1  270.020  446.080  MX  PLACED  _33790_
i_lisa_periph.i_lisa_i2c.byte_controller.bit_controller.cnt[7]  flop  sky130_fd_sc_hd__dfxtp_1  274.620  451.520  MX  PLACED  _33791_
i_lisa_periph.i_lisa_i2c.byte_controller.bit_controller.cnt[8]  flop  sky130_fd_sc_hd__dfxtp_1  277.840  443.360  R0  PLACED  _33792_
i_lisa_periph.i_lisa_i2c.byte_controller.bit_controller.cnt[9]  flop  sky130_fd_sc_hd__dfxtp_1  256.220  432.480  R0  PLACED  _33793_
i_lisa_periph.i_lisa_i2c.byte_controller.bit_controller.dSCL  flop  sky130_fd_sc_hd__dfxtp_1  240.120  465.120  R0  PLACED  _33757_
i_lisa_periph.i_lisa_i2c.byte_controller.bit_controller.dSDA  flop  sky130_fd_sc_hd__dfxtp_1  214.360  465.120  R0  PLACED  _33758_
i_lisa_periph.i_lisa_i2c.byte_controller.bit_controller.din  flop  sky130_fd_sc_hd__dfxtp_1  247.940  481.440  R0  PLACED  _33733_
i_lisa_periph.i_lisa_i2c.byte_controller.bit_controller.dout  flop  sky130_fd_sc_hd__dfxtp_1  248.860  465.120  R0  PLACED  _33749_
i_lisa_periph.i_lisa_i2c.byte_controller.bit_controller.dscl_oen  flop  sky130_fd_sc_hd__dfxtp_1  235.520  459.680  R0  PLACED  _34543_
i_lisa_periph.i_lisa_i2c.byte_controller.bit_controller.fSCL[0]  flop  sky130_fd_sc_hd__dfxtp_1  214.820  435.200  MX  PLACED  _33759_
i_lisa_periph.i_lisa_i2c.byte_controller.bit_controller.fSCL[1]  flop  sky130_fd_sc_hd__dfxtp_1  205.620  437.920  R0  PLACED  _33760_
i_lisa_periph.i_lisa_i2c.byte_controller.bit_controller.fSCL[2]  flop  sky130_fd_sc_hd__dfxtp_1  209.300  443.360  R0  PLACED  _33761_
i_lisa_periph.i_lisa_i2c.byte_controller.bit_controller.fSDA[0]  flop  sky130_fd_sc_hd__dfxtp_1  204.700  448.800  R0  PLACED  _33762_
i_lisa_periph.i_lisa_i2c.byte_controller.bit_controller.fSDA[1]  flop  sky130_fd_sc_hd__dfxtp_1  211.140  451.520  MX  PLACED  _33763_
i_lisa_periph.i_lisa_i2c.byte_controller.bit_controller.fSDA[2]  flop  sky130_fd_sc_hd__dfxtp_1  209.760  456.960  MX  PLACED  _33764_
i_lisa_periph.i_lisa_i2c.byte_controller.bit_controller.filter_cnt[0]  flop  sky130_fd_sc_hd__dfxtp_1  219.420  451.520  MX  PLACED  _33765_
i_lisa_periph.i_lisa_i2c.byte_controller.bit_controller.filter_cnt[10]  flop  sky130_fd_sc_hd__dfxtp_1  223.100  429.760  MX  PLACED  _33775_
i_lisa_periph.i_lisa_i2c.byte_controller.bit_controller.filter_cnt[11]  flop  sky130_fd_sc_hd__dfxtp_1  222.180  437.920  R0  PLACED  _33776_
i_lisa_periph.i_lisa_i2c.byte_controller.bit_controller.filter_cnt[12]  flop  sky130_fd_sc_hd__dfxtp_1  218.960  446.080  MX  PLACED  _33777_
i_lisa_periph.i_lisa_i2c.byte_controller.bit_controller.filter_cnt[13]  flop  sky130_fd_sc_hd__dfxtp_1  222.180  448.800  R0  PLACED  _33778_
i_lisa_periph.i_lisa_i2c.byte_controller.bit_controller.filter_cnt[1]  flop  sky130_fd_sc_hd__dfxtp_1  235.060  456.960  MX  PLACED  _33766_
i_lisa_periph.i_lisa_i2c.byte_controller.bit_controller.filter_cnt[2]  flop  sky130_fd_sc_hd__dfxtp_1  225.400  456.960  MX  PLACED  _33767_
i_lisa_periph.i_lisa_i2c.byte_controller.bit_controller.filter_cnt[3]  flop  sky130_fd_sc_hd__dfxtp_1  243.800  451.520  MX  PLACED  _33768_
i_lisa_periph.i_lisa_i2c.byte_controller.bit_controller.filter_cnt[4]  flop  sky130_fd_sc_hd__dfxtp_1  244.720  440.640  MX  PLACED  _33769_
i_lisa_periph.i_lisa_i2c.byte_controller.bit_controller.filter_cnt[5]  flop  sky130_fd_sc_hd__dfxtp_1  235.060  446.080  MX  PLACED  _33770_
i_lisa_periph.i_lisa_i2c.byte_controller.bit_controller.filter_cnt[6]  flop  sky130_fd_sc_hd__dfxtp_1  235.060  440.640  MX  PLACED  _33771_
i_lisa_periph.i_lisa_i2c.byte_controller.bit_controller.filter_cnt[7]  flop  sky130_fd_sc_hd__dfxtp_1  235.520  435.200  MX  PLACED  _33772_
i_lisa_periph.i_lisa_i2c.byte_controller.bit_controller.filter_cnt[8]  flop  sky130_fd_sc_hd__dfxtp_1  235.060  429.760  MX  PLACED  _33773_
i_lisa_periph.i_lisa_i2c.byte_controller.bit_controller.filter_cnt[9]  flop  sky130_fd_sc_hd__dfxtp_1  244.260  429.760  MX  PLACED  _33774_
i_lisa_periph.i_lisa_i2c.byte_controller.bit_controller.sSCL  flop  sky130_fd_sc_hd__dfxtp_1  214.360  459.680  R0  PLACED  _33755_
i_lisa_periph.i_lisa_i2c.byte_controller.bit_controller.sSDA  flop  sky130_fd_sc_hd__dfxtp_1  211.140  462.400  MX  PLACED  _33756_
i_lisa_periph.i_lisa_i2c.byte_controller.bit_controller.scl_oen  flop  sky130_fd_sc_hd__dfxtp_1  235.520  476.000  R0  PLACED  _33746_
i_lisa_periph.i_lisa_i2c.byte_controller.bit_controller.sda_chk  flop  sky130_fd_sc_hd__dfxtp_1  219.880  473.280  MX  PLACED  _33748_
i_lisa_periph.i_lisa_i2c.byte_controller.bit_controller.sda_oen  flop  sky130_fd_sc_hd__dfxtp_1  227.240  473.280  MX  PLACED  _33747_
i_lisa_periph.i_lisa_i2c.byte_controller.bit_controller.slave_wait  flop  sky130_fd_sc_hd__dfxtp_1  239.660  462.400  MX  PLACED  _33800_
i_lisa_periph.i_lisa_i2c.byte_controller.bit_controller.sta_condition  flop  sky130_fd_sc_hd__dfxtp_1  219.880  462.400  MX  PLACED  _33753_
i_lisa_periph.i_lisa_i2c.byte_controller.bit_controller.sto_condition  flop  sky130_fd_sc_hd__dfxtp_1  223.100  467.840  MX  PLACED  _33754_
i_lisa_periph.i_lisa_i2c.byte_controller.c_state[0]  flop  sky130_fd_sc_hd__dfxtp_1  264.960  470.560  R0  PLACED  _34392_
i_lisa_periph.i_lisa_i2c.byte_controller.c_state[1]  flop  sky130_fd_sc_hd__dfxtp_1  256.220  470.560  R0  PLACED  _34393_
i_lisa_periph.i_lisa_i2c.byte_controller.c_state[2]  flop  sky130_fd_sc_hd__dfxtp_1  273.700  481.440  R0  PLACED  _34394_
i_lisa_periph.i_lisa_i2c.byte_controller.c_state[3]  flop  sky130_fd_sc_hd__dfxtp_1  268.180  489.600  MX  PLACED  _34395_
i_lisa_periph.i_lisa_i2c.byte_controller.c_state[4]  flop  sky130_fd_sc_hd__dfxtp_1  260.820  484.160  MX  PLACED  _34396_
i_lisa_periph.i_lisa_i2c.byte_controller.c_state[5]  flop  sky130_fd_sc_hd__dfxtp_1  256.220  476.000  R0  PLACED  _34397_
i_lisa_periph.i_lisa_i2c.byte_controller.cmd_ack  flop  sky130_fd_sc_hd__dfxtp_1  273.700  470.560  R0  PLACED  _34559_
i_lisa_periph.i_lisa_i2c.byte_controller.core_cmd[1]  flop  sky130_fd_sc_hd__dfxtp_1  258.060  486.880  R0  PLACED  _34388_
i_lisa_periph.i_lisa_i2c.byte_controller.core_cmd[2]  flop  sky130_fd_sc_hd__dfxtp_1  250.700  486.880  R0  PLACED  _34389_
i_lisa_periph.i_lisa_i2c.byte_controller.core_cmd[3]  flop  sky130_fd_sc_hd__dfxtp_1  246.560  473.280  MX  PLACED  _34390_
i_lisa_periph.i_lisa_i2c.byte_controller.core_cmd[4]  flop  sky130_fd_sc_hd__dfxtp_1  249.320  478.720  MX  PLACED  _34391_
i_lisa_periph.i_lisa_i2c.byte_controller.dcnt[0]  flop  sky130_fd_sc_hd__dfxtp_1  299.460  476.000  R0  PLACED  _33734_
i_lisa_periph.i_lisa_i2c.byte_controller.dcnt[1]  flop  sky130_fd_sc_hd__dfxtp_1  313.720  484.160  MX  PLACED  _33735_
i_lisa_periph.i_lisa_i2c.byte_controller.dcnt[2]  flop  sky130_fd_sc_hd__dfxtp_1  294.860  484.160  MX  PLACED  _33736_
i_lisa_periph.i_lisa_i2c.byte_controller.din[0]  flop  sky130_fd_sc_hd__dfxtp_1  367.080  481.440  R0  PLACED  _33716_
i_lisa_periph.i_lisa_i2c.byte_controller.din[1]  flop  sky130_fd_sc_hd__dfxtp_1  345.920  456.960  MX  PLACED  _33717_
i_lisa_periph.i_lisa_i2c.byte_controller.din[2]  flop  sky130_fd_sc_hd__dfxtp_1  356.040  456.960  MX  PLACED  _33718_
i_lisa_periph.i_lisa_i2c.byte_controller.din[3]  flop  sky130_fd_sc_hd__dfxtp_1  366.620  456.960  MX  PLACED  _33719_
i_lisa_periph.i_lisa_i2c.byte_controller.din[4]  flop  sky130_fd_sc_hd__dfxtp_1  348.220  462.400  MX  PLACED  _33720_
i_lisa_periph.i_lisa_i2c.byte_controller.din[5]  flop  sky130_fd_sc_hd__dfxtp_1  350.980  484.160  MX  PLACED  _33721_
i_lisa_periph.i_lisa_i2c.byte_controller.din[6]  flop  sky130_fd_sc_hd__dfxtp_1  350.980  476.000  R0  PLACED  _33722_
i_lisa_periph.i_lisa_i2c.byte_controller.din[7]  flop  sky130_fd_sc_hd__dfxtp_1  339.020  481.440  R0  PLACED  _33723_
i_lisa_periph.i_lisa_i2c.byte_controller.dout[0]  flop  sky130_fd_sc_hd__dfxtp_1  308.200  465.120  R0  PLACED  _33737_
i_lisa_periph.i_lisa_i2c.byte_controller.dout[1]  flop  sky130_fd_sc_hd__dfxtp_1  339.940  448.800  R0  PLACED  _33738_
i_lisa_periph.i_lisa_i2c.byte_controller.dout[2]  flop  sky130_fd_sc_hd__dfxtp_1  321.540  446.080  MX  PLACED  _33739_
i_lisa_periph.i_lisa_i2c.byte_controller.dout[3]  flop  sky130_fd_sc_hd__dfxtp_1  322.460  462.400  MX  PLACED  _33740_
i_lisa_periph.i_lisa_i2c.byte_controller.dout[4]  flop  sky130_fd_sc_hd__dfxtp_1  333.040  459.680  R0  PLACED  _33741_
i_lisa_periph.i_lisa_i2c.byte_controller.dout[5]  flop  sky130_fd_sc_hd__dfxtp_1  331.660  465.120  R0  PLACED  _33742_
i_lisa_periph.i_lisa_i2c.byte_controller.dout[6]  flop  sky130_fd_sc_hd__dfxtp_1  343.620  467.840  MX  PLACED  _33743_
i_lisa_periph.i_lisa_i2c.byte_controller.dout[7]  flop  sky130_fd_sc_hd__dfxtp_1  340.400  476.000  R0  PLACED  _33744_
i_lisa_periph.i_lisa_i2c.byte_controller.ld  flop  sky130_fd_sc_hd__dfxtp_1  291.640  476.000  R0  PLACED  _34557_
i_lisa_periph.i_lisa_i2c.byte_controller.read  flop  sky130_fd_sc_hd__dfxtp_1  319.700  478.720  MX  PLACED  _33725_
i_lisa_periph.i_lisa_i2c.byte_controller.shift  flop  sky130_fd_sc_hd__dfxtp_1  287.040  484.160  MX  PLACED  _34558_
i_lisa_periph.i_lisa_i2c.byte_controller.start  flop  sky130_fd_sc_hd__dfxtp_1  317.400  476.000  R0  PLACED  _33727_
i_lisa_periph.i_lisa_i2c.byte_controller.stop  flop  sky130_fd_sc_hd__dfxtp_1  302.680  470.560  R0  PLACED  _33726_
i_lisa_periph.i_lisa_i2c.byte_controller.write  flop  sky130_fd_sc_hd__dfxtp_1  304.520  473.280  MX  PLACED  _33724_
i_lisa_periph.i_lisa_i2c.iack  flop  sky130_fd_sc_hd__dfxtp_1  459.080  467.840  MX  PLACED  _33729_
i_lisa_periph.i_lisa_i2c.r_cmd[1]  flop  sky130_fd_sc_hd__dfxtp_1  480.240  467.840  MX  PLACED  _33730_
i_lisa_periph.i_lisa_i2c.r_cmd[2]  flop  sky130_fd_sc_hd__dfxtp_1  469.660  467.840  MX  PLACED  _33731_
i_lisa_periph.i_lisa_i2c.r_ctrl[0]  flop  sky130_fd_sc_hd__dfxtp_1  318.780  435.200  MX  PLACED  _33715_
i_lisa_periph.i_lisa_i2c.rxack  flop  sky130_fd_sc_hd__dfxtp_1  299.460  465.120  R0  PLACED  _33696_
i_lisa_periph.i_lisa_i2c.tip  flop  sky130_fd_sc_hd__dfxtp_1  331.660  476.000  R0  PLACED  _33697_
i_lisa_periph.i_lisa_uart_2.autobaud_disable  flop  sky130_fd_sc_hd__dfxtp_1  330.280  435.200  MX  PLACED  _33694_
i_lisa_periph.i_lisa_uart_2.i_lisa_autobaud.div[0]  flop  sky130_fd_sc_hd__dfrtp_1  637.560  386.240  MX  PLACED  _33804_
i_lisa_periph.i_lisa_uart_2.i_lisa_autobaud.div[1]  flop  sky130_fd_sc_hd__dfrtp_1  644.920  388.960  R0  PLACED  _33805_
i_lisa_periph.i_lisa_uart_2.i_lisa_autobaud.div[2]  flop  sky130_fd_sc_hd__dfrtp_1  647.220  386.240  MX  PLACED  _33806_
i_lisa_periph.i_lisa_uart_2.i_lisa_autobaud.div[3]  flop  sky130_fd_sc_hd__dfrtp_1  660.100  383.520  R0  PLACED  _33807_
i_lisa_periph.i_lisa_uart_2.i_lisa_autobaud.div[4]  flop  sky130_fd_sc_hd__dfrtp_1  653.660  391.680  MX  PLACED  _33808_
i_lisa_periph.i_lisa_uart_2.i_lisa_autobaud.div[5]  flop  sky130_fd_sc_hd__dfrtp_1  669.300  394.400  R0  PLACED  _33809_
i_lisa_periph.i_lisa_uart_2.i_lisa_autobaud.div[6]  flop  sky130_fd_sc_hd__dfrtp_1  614.100  399.840  R0  PLACED  _33810_
i_lisa_periph.i_lisa_uart_2.i_lisa_autobaud.div[7]  flop  sky130_fd_sc_hd__dfrtp_1  626.980  397.120  MX  PLACED  _33811_
i_lisa_periph.i_lisa_uart_2.i_lisa_autobaud.rx1  flop  sky130_fd_sc_hd__dfxtp_1  436.540  437.920  R0  PLACED  _33802_
i_lisa_periph.i_lisa_uart_2.i_lisa_autobaud.s_bit_div2[0]  flop  sky130_fd_sc_hd__dfrtp_1  634.340  388.960  R0  PLACED  _33812_
i_lisa_periph.i_lisa_uart_2.i_lisa_autobaud.s_bit_div2[1]  flop  sky130_fd_sc_hd__dfrtp_1  650.900  380.800  MX  PLACED  _33813_
i_lisa_periph.i_lisa_uart_2.i_lisa_autobaud.s_bit_div2[2]  flop  sky130_fd_sc_hd__dfrtp_1  637.560  375.360  MX  PLACED  _33814_
i_lisa_periph.i_lisa_uart_2.i_lisa_autobaud.s_bit_div2[3]  flop  sky130_fd_sc_hd__dfrtp_1  663.780  378.080  R0  PLACED  _33815_
i_lisa_periph.i_lisa_uart_2.i_lisa_autobaud.s_bit_div2[4]  flop  sky130_fd_sc_hd__dfrtp_1  611.800  383.520  R0  PLACED  _33816_
i_lisa_periph.i_lisa_uart_2.i_lisa_autobaud.s_bit_div2[5]  flop  sky130_fd_sc_hd__dfrtp_1  668.380  388.960  R0  PLACED  _33817_
i_lisa_periph.i_lisa_uart_2.i_lisa_autobaud.s_bit_div2[6]  flop  sky130_fd_sc_hd__dfrtp_1  612.260  394.400  R0  PLACED  _33818_
i_lisa_periph.i_lisa_uart_2.i_lisa_autobaud.s_bit_div2[7]  flop  sky130_fd_sc_hd__dfrtp_1  624.220  378.080  R0  PLACED  _33819_
i_lisa_periph.i_lisa_uart_2.i_lisa_autobaud.s_bit_div3[0]  flop  sky130_fd_sc_hd__dfrtp_1  624.220  391.680  MX  PLACED  _33820_
i_lisa_periph.i_lisa_uart_2.i_lisa_autobaud.s_bit_div3[1]  flop  sky130_fd_sc_hd__dfrtp_1  656.420  375.360  MX  PLACED  _33821_
i_lisa_periph.i_lisa_uart_2.i_lisa_autobaud.s_bit_div3[2]  flop  sky130_fd_sc_hd__dfrtp_1  647.220  375.360  MX  PLACED  _33822_
i_lisa_periph.i_lisa_uart_2.i_lisa_autobaud.s_bit_div3[3]  flop  sky130_fd_sc_hd__dfrtp_1  669.300  372.640  R0  PLACED  _33823_
i_lisa_periph.i_lisa_uart_2.i_lisa_autobaud.s_bit_div3[4]  flop  sky130_fd_sc_hd__dfrtp_1  615.020  378.080  R0  PLACED  _33824_
i_lisa_periph.i_lisa_uart_2.i_lisa_autobaud.s_bit_div3[5]  flop  sky130_fd_sc_hd__dfrtp_1  663.320  386.240  MX  PLACED  _33825_
i_lisa_periph.i_lisa_uart_2.i_lisa_autobaud.s_bit_div3[6]  flop  sky130_fd_sc_hd__dfrtp_1  610.880  388.960  R0  PLACED  _33826_
i_lisa_periph.i_lisa_uart_2.i_lisa_autobaud.s_bit_div3[7]  flop  sky130_fd_sc_hd__dfrtp_1  626.060  375.360  MX  PLACED  _33827_
i_lisa_periph.i_lisa_uart_2.i_lisa_autobaud.s_div_found  flop  sky130_fd_sc_hd__dfrtp_1  616.400  405.280  R0  PLACED  _34542_
i_lisa_periph.i_lisa_uart_2.i_lisa_autobaud.s_done  flop  sky130_fd_sc_hd__dfrtp_1  617.780  410.720  R0  PLACED  _33829_
i_lisa_periph.i_lisa_uart_2.i_lisa_autobaud.s_last_rx1  flop  sky130_fd_sc_hd__dfrtp_1  599.380  413.440  MX  PLACED  _33828_
i_lisa_periph.i_lisa_uart_2.i_lisa_autobaud.s_pulse_width[0]  flop  sky130_fd_sc_hd__dfrtp_1  641.240  410.720  R0  PLACED  _32613_
i_lisa_periph.i_lisa_uart_2.i_lisa_autobaud.s_pulse_width[10]  flop  sky130_fd_sc_hd__dfrtp_1  667.460  399.840  R0  PLACED  _32623_
i_lisa_periph.i_lisa_uart_2.i_lisa_autobaud.s_pulse_width[11]  flop  sky130_fd_sc_hd__dfrtp_1  636.180  402.560  MX  PLACED  _32624_
i_lisa_periph.i_lisa_uart_2.i_lisa_autobaud.s_pulse_width[12]  flop  sky130_fd_sc_hd__dfrtp_1  623.760  399.840  R0  PLACED  _32625_
i_lisa_periph.i_lisa_uart_2.i_lisa_autobaud.s_pulse_width[13]  flop  sky130_fd_sc_hd__dfrtp_1  628.820  408.000  MX  PLACED  _32626_
i_lisa_periph.i_lisa_uart_2.i_lisa_autobaud.s_pulse_width[1]  flop  sky130_fd_sc_hd__dfrtp_1  647.220  408.000  MX  PLACED  _32614_
i_lisa_periph.i_lisa_uart_2.i_lisa_autobaud.s_pulse_width[2]  flop  sky130_fd_sc_hd__dfrtp_1  656.880  408.000  MX  PLACED  _32615_
i_lisa_periph.i_lisa_uart_2.i_lisa_autobaud.s_pulse_width[3]  flop  sky130_fd_sc_hd__dfrtp_1  669.300  410.720  R0  PLACED  _32616_
i_lisa_periph.i_lisa_uart_2.i_lisa_autobaud.s_pulse_width[4]  flop  sky130_fd_sc_hd__dfrtp_1  669.300  405.280  R0  PLACED  _32617_
i_lisa_periph.i_lisa_uart_2.i_lisa_autobaud.s_pulse_width[5]  flop  sky130_fd_sc_hd__dfrtp_1  647.220  402.560  MX  PLACED  _32618_
i_lisa_periph.i_lisa_uart_2.i_lisa_autobaud.s_pulse_width[6]  flop  sky130_fd_sc_hd__dfrtp_1  641.240  394.400  R0  PLACED  _32619_
i_lisa_periph.i_lisa_uart_2.i_lisa_autobaud.s_pulse_width[7]  flop  sky130_fd_sc_hd__dfrtp_1  653.200  397.120  MX  PLACED  _32620_
i_lisa_periph.i_lisa_uart_2.i_lisa_autobaud.s_pulse_width[8]  flop  sky130_fd_sc_hd__dfrtp_1  662.860  391.680  MX  PLACED  _32621_
i_lisa_periph.i_lisa_uart_2.i_lisa_autobaud.s_pulse_width[9]  flop  sky130_fd_sc_hd__dfrtp_1  656.420  402.560  MX  PLACED  _32622_
i_lisa_periph.i_lisa_uart_2.i_lisa_autobaud.s_rx_sel[2]  flop  sky130_fd_sc_hd__dfrtp_1  608.580  413.440  MX  PLACED  _34387_
i_lisa_periph.i_lisa_uart_2.i_lisa_autobaud.wr  flop  sky130_fd_sc_hd__dfrtp_1  606.740  402.560  MX  PLACED  _33803_
i_lisa_periph.i_lisa_uart_2.i_lisa_brg.baud_ref  flop  sky130_fd_sc_hd__dfxtp_1  574.540  492.320  R0  PLACED  _33830_
i_lisa_periph.i_lisa_uart_2.i_lisa_brg.s_baud_cnt[0]  flop  sky130_fd_sc_hd__dfxtp_1  599.380  388.960  R0  PLACED  _33831_
i_lisa_periph.i_lisa_uart_2.i_lisa_brg.s_baud_cnt[1]  flop  sky130_fd_sc_hd__dfxtp_1  604.900  380.800  MX  PLACED  _33832_
i_lisa_periph.i_lisa_uart_2.i_lisa_brg.s_baud_cnt[2]  flop  sky130_fd_sc_hd__dfxtp_1  597.540  380.800  MX  PLACED  _33833_
i_lisa_periph.i_lisa_uart_2.i_lisa_brg.s_baud_cnt[3]  flop  sky130_fd_sc_hd__dfxtp_1  604.440  386.240  MX  PLACED  _33834_
i_lisa_periph.i_lisa_uart_2.i_lisa_brg.s_baud_cnt[4]  flop  sky130_fd_sc_hd__dfxtp_1  606.280  397.120  MX  PLACED  _33835_
i_lisa_periph.i_lisa_uart_2.i_lisa_brg.s_baud_cnt[5]  flop  sky130_fd_sc_hd__dfxtp_1  597.080  397.120  MX  PLACED  _33836_
i_lisa_periph.i_lisa_uart_2.i_lisa_brg.s_baud_cnt[6]  flop  sky130_fd_sc_hd__dfxtp_1  600.760  405.280  R0  PLACED  _33837_
i_lisa_periph.i_lisa_uart_2.i_lisa_brg.s_baud_cnt[7]  flop  sky130_fd_sc_hd__dfxtp_1  592.940  405.280  R0  PLACED  _33838_
i_lisa_periph.i_lisa_uart_2.i_lisa_brg.s_baud_preload[0]  flop  sky130_fd_sc_hd__dfxtp_1  580.520  386.240  MX  PLACED  _33839_
i_lisa_periph.i_lisa_uart_2.i_lisa_brg.s_baud_preload[1]  flop  sky130_fd_sc_hd__dfxtp_1  590.640  378.080  R0  PLACED  _33840_
i_lisa_periph.i_lisa_uart_2.i_lisa_brg.s_baud_preload[2]  flop  sky130_fd_sc_hd__dfxtp_1  582.820  380.800  MX  PLACED  _33841_
i_lisa_periph.i_lisa_uart_2.i_lisa_brg.s_baud_preload[3]  flop  sky130_fd_sc_hd__dfxtp_1  587.880  386.240  MX  PLACED  _33842_
i_lisa_periph.i_lisa_uart_2.i_lisa_brg.s_baud_preload[4]  flop  sky130_fd_sc_hd__dfxtp_1  590.180  394.400  R0  PLACED  _33843_
i_lisa_periph.i_lisa_uart_2.i_lisa_brg.s_baud_preload[5]  flop  sky130_fd_sc_hd__dfxtp_1  582.820  394.400  R0  PLACED  _33844_
i_lisa_periph.i_lisa_uart_2.i_lisa_brg.s_baud_preload[6]  flop  sky130_fd_sc_hd__dfxtp_1  590.180  399.840  R0  PLACED  _33845_
i_lisa_periph.i_lisa_uart_2.i_lisa_brg.s_baud_preload[7]  flop  sky130_fd_sc_hd__dfxtp_1  582.820  399.840  R0  PLACED  _33846_
i_lisa_periph.i_lisa_uart_2.i_lisa_brg.s_wr_edge  flop  sky130_fd_sc_hd__dfxtp_1  573.620  397.120  MX  PLACED  _33847_
i_lisa_periph.i_lisa_uart_2.i_lisa_rx8n_2.bit_count[0]  flop  sky130_fd_sc_hd__dfxtp_1  132.480  486.880  R0  PLACED  _33849_
i_lisa_periph.i_lisa_uart_2.i_lisa_rx8n_2.bit_count[1]  flop  sky130_fd_sc_hd__dfxtp_1  115.000  484.160  MX  PLACED  _33850_
i_lisa_periph.i_lisa_uart_2.i_lisa_rx8n_2.bit_count[2]  flop  sky130_fd_sc_hd__dfxtp_1  111.320  486.880  R0  PLACED  _33851_
i_lisa_periph.i_lisa_uart_2.i_lisa_rx8n_2.bit_count[3]  flop  sky130_fd_sc_hd__dfxtp_1  114.540  489.600  MX  PLACED  _33852_
i_lisa_periph.i_lisa_uart_2.i_lisa_rx8n_2.bit_count[4]  flop  sky130_fd_sc_hd__dfxtp_1  114.080  495.040  MX  PLACED  _33853_
i_lisa_periph.i_lisa_uart_2.i_lisa_rx8n_2.bit_count[5]  flop  sky130_fd_sc_hd__dfxtp_1  136.620  503.200  R0  PLACED  _33854_
i_lisa_periph.i_lisa_uart_2.i_lisa_rx8n_2.bit_count[6]  flop  sky130_fd_sc_hd__dfxtp_1  116.380  500.480  MX  PLACED  _33855_
i_lisa_periph.i_lisa_uart_2.i_lisa_rx8n_2.bit_count[7]  flop  sky130_fd_sc_hd__dfxtp_1  128.800  503.200  R0  PLACED  _33856_
i_lisa_periph.i_lisa_uart_2.i_lisa_rx8n_2.fifo[0][0]  flop  sky130_fd_sc_hd__dfxtp_1  141.220  456.960  MX  PLACED  _32540_
i_lisa_periph.i_lisa_uart_2.i_lisa_rx8n_2.fifo[0][1]  flop  sky130_fd_sc_hd__dfxtp_1  152.260  476.000  R0  PLACED  _32541_
i_lisa_periph.i_lisa_uart_2.i_lisa_rx8n_2.fifo[0][2]  flop  sky130_fd_sc_hd__dfxtp_1  149.960  456.960  MX  PLACED  _32542_
i_lisa_periph.i_lisa_uart_2.i_lisa_rx8n_2.fifo[0][3]  flop  sky130_fd_sc_hd__dfxtp_1  133.400  456.960  MX  PLACED  _32543_
i_lisa_periph.i_lisa_uart_2.i_lisa_rx8n_2.fifo[0][4]  flop  sky130_fd_sc_hd__dfxtp_1  132.020  478.720  MX  PLACED  _32544_
i_lisa_periph.i_lisa_uart_2.i_lisa_rx8n_2.fifo[0][5]  flop  sky130_fd_sc_hd__dfxtp_1  132.480  459.680  R0  PLACED  _32545_
i_lisa_periph.i_lisa_uart_2.i_lisa_rx8n_2.fifo[0][6]  flop  sky130_fd_sc_hd__dfxtp_1  136.160  470.560  R0  PLACED  _32546_
i_lisa_periph.i_lisa_uart_2.i_lisa_rx8n_2.fifo[0][7]  flop  sky130_fd_sc_hd__dfxtp_1  149.500  467.840  MX  PLACED  _32547_
i_lisa_periph.i_lisa_uart_2.i_lisa_rx8n_2.fifo[1][0]  flop  sky130_fd_sc_hd__dfxtp_1  142.140  451.520  MX  PLACED  _32548_
i_lisa_periph.i_lisa_uart_2.i_lisa_rx8n_2.fifo[1][1]  flop  sky130_fd_sc_hd__dfxtp_1  149.960  481.440  R0  PLACED  _32549_
i_lisa_periph.i_lisa_uart_2.i_lisa_rx8n_2.fifo[1][2]  flop  sky130_fd_sc_hd__dfxtp_1  146.280  462.400  MX  PLACED  _32550_
i_lisa_periph.i_lisa_uart_2.i_lisa_rx8n_2.fifo[1][3]  flop  sky130_fd_sc_hd__dfxtp_1  125.120  459.680  R0  PLACED  _32551_
i_lisa_periph.i_lisa_uart_2.i_lisa_rx8n_2.fifo[1][4]  flop  sky130_fd_sc_hd__dfxtp_1  129.720  481.440  R0  PLACED  _32552_
i_lisa_periph.i_lisa_uart_2.i_lisa_rx8n_2.fifo[1][5]  flop  sky130_fd_sc_hd__dfxtp_1  124.200  462.400  MX  PLACED  _32553_
i_lisa_periph.i_lisa_uart_2.i_lisa_rx8n_2.fifo[1][6]  flop  sky130_fd_sc_hd__dfxtp_1  124.200  467.840  MX  PLACED  _32554_
i_lisa_periph.i_lisa_uart_2.i_lisa_rx8n_2.fifo[1][7]  flop  sky130_fd_sc_hd__dfxtp_1  144.440  473.280  MX  PLACED  _32555_
i_lisa_periph.i_lisa_uart_2.i_lisa_rx8n_2.fifo[2][0]  flop  sky130_fd_sc_hd__dfxtp_1  132.480  446.080  MX  PLACED  _32556_
i_lisa_periph.i_lisa_uart_2.i_lisa_rx8n_2.fifo[2][1]  flop  sky130_fd_sc_hd__dfxtp_1  141.220  484.160  MX  PLACED  _32557_
i_lisa_periph.i_lisa_uart_2.i_lisa_rx8n_2.fifo[2][2]  flop  sky130_fd_sc_hd__dfxtp_1  144.900  454.240  R0  PLACED  _32558_
i_lisa_periph.i_lisa_uart_2.i_lisa_rx8n_2.fifo[2][3]  flop  sky130_fd_sc_hd__dfxtp_1  119.600  456.960  MX  PLACED  _32559_
i_lisa_periph.i_lisa_uart_2.i_lisa_rx8n_2.fifo[2][4]  flop  sky130_fd_sc_hd__dfxtp_1  119.600  478.720  MX  PLACED  _32560_
i_lisa_periph.i_lisa_uart_2.i_lisa_rx8n_2.fifo[2][5]  flop  sky130_fd_sc_hd__dfxtp_1  119.140  465.120  R0  PLACED  _32561_
i_lisa_periph.i_lisa_uart_2.i_lisa_rx8n_2.fifo[2][6]  flop  sky130_fd_sc_hd__dfxtp_1  119.140  470.560  R0  PLACED  _32562_
i_lisa_periph.i_lisa_uart_2.i_lisa_rx8n_2.fifo[2][7]  flop  sky130_fd_sc_hd__dfxtp_1  138.920  467.840  MX  PLACED  _32563_
i_lisa_periph.i_lisa_uart_2.i_lisa_rx8n_2.fifo[3][0]  flop  sky130_fd_sc_hd__dfxtp_1  136.160  448.800  R0  PLACED  _32564_
i_lisa_periph.i_lisa_uart_2.i_lisa_rx8n_2.fifo[3][1]  flop  sky130_fd_sc_hd__dfxtp_1  141.680  478.720  MX  PLACED  _32565_
i_lisa_periph.i_lisa_uart_2.i_lisa_rx8n_2.fifo[3][2]  flop  sky130_fd_sc_hd__dfxtp_1  138.920  462.400  MX  PLACED  _32566_
i_lisa_periph.i_lisa_uart_2.i_lisa_rx8n_2.fifo[3][3]  flop  sky130_fd_sc_hd__dfxtp_1  119.140  454.240  R0  PLACED  _32567_
i_lisa_periph.i_lisa_uart_2.i_lisa_rx8n_2.fifo[3][4]  flop  sky130_fd_sc_hd__dfxtp_1  119.600  476.000  R0  PLACED  _32568_
i_lisa_periph.i_lisa_uart_2.i_lisa_rx8n_2.fifo[3][5]  flop  sky130_fd_sc_hd__dfxtp_1  116.840  462.400  MX  PLACED  _32569_
i_lisa_periph.i_lisa_uart_2.i_lisa_rx8n_2.fifo[3][6]  flop  sky130_fd_sc_hd__dfxtp_1  117.300  473.280  MX  PLACED  _32570_
i_lisa_periph.i_lisa_uart_2.i_lisa_rx8n_2.fifo[3][7]  flop  sky130_fd_sc_hd__dfxtp_1  137.080  473.280  MX  PLACED  _32571_
i_lisa_periph.i_lisa_uart_2.i_lisa_rx8n_2.fifo[4][0]  flop  sky130_fd_sc_hd__dfxtp_1  178.940  448.800  R0  PLACED  _32572_
i_lisa_periph.i_lisa_uart_2.i_lisa_rx8n_2.fifo[4][1]  flop  sky130_fd_sc_hd__dfxtp_1  184.920  473.280  MX  PLACED  _32573_
i_lisa_periph.i_lisa_uart_2.i_lisa_rx8n_2.fifo[4][2]  flop  sky130_fd_sc_hd__dfxtp_1  172.960  465.120  R0  PLACED  _32574_
i_lisa_periph.i_lisa_uart_2.i_lisa_rx8n_2.fifo[4][3]  flop  sky130_fd_sc_hd__dfxtp_1  199.640  451.520  MX  PLACED  _32575_
i_lisa_periph.i_lisa_uart_2.i_lisa_rx8n_2.fifo[4][4]  flop  sky130_fd_sc_hd__dfxtp_1  171.580  481.440  R0  PLACED  _32576_
i_lisa_periph.i_lisa_uart_2.i_lisa_rx8n_2.fifo[4][5]  flop  sky130_fd_sc_hd__dfxtp_1  202.860  459.680  R0  PLACED  _32577_
i_lisa_periph.i_lisa_uart_2.i_lisa_rx8n_2.fifo[4][6]  flop  sky130_fd_sc_hd__dfxtp_1  161.000  481.440  R0  PLACED  _32578_
i_lisa_periph.i_lisa_uart_2.i_lisa_rx8n_2.fifo[4][7]  flop  sky130_fd_sc_hd__dfxtp_1  201.940  470.560  R0  PLACED  _32579_
i_lisa_periph.i_lisa_uart_2.i_lisa_rx8n_2.fifo[5][0]  flop  sky130_fd_sc_hd__dfxtp_1  176.180  454.240  R0  PLACED  _32580_
i_lisa_periph.i_lisa_uart_2.i_lisa_rx8n_2.fifo[5][1]  flop  sky130_fd_sc_hd__dfxtp_1  181.240  481.440  R0  PLACED  _32581_
i_lisa_periph.i_lisa_uart_2.i_lisa_rx8n_2.fifo[5][2]  flop  sky130_fd_sc_hd__dfxtp_1  172.500  462.400  MX  PLACED  _32582_
i_lisa_periph.i_lisa_uart_2.i_lisa_rx8n_2.fifo[5][3]  flop  sky130_fd_sc_hd__dfxtp_1  188.600  454.240  R0  PLACED  _32583_
i_lisa_periph.i_lisa_uart_2.i_lisa_rx8n_2.fifo[5][4]  flop  sky130_fd_sc_hd__dfxtp_1  173.420  484.160  MX  PLACED  _32584_
i_lisa_periph.i_lisa_uart_2.i_lisa_rx8n_2.fifo[5][5]  flop  sky130_fd_sc_hd__dfxtp_1  196.420  465.120  R0  PLACED  _32585_
i_lisa_periph.i_lisa_uart_2.i_lisa_rx8n_2.fifo[5][6]  flop  sky130_fd_sc_hd__dfxtp_1  161.460  478.720  MX  PLACED  _32586_
i_lisa_periph.i_lisa_uart_2.i_lisa_rx8n_2.fifo[5][7]  flop  sky130_fd_sc_hd__dfxtp_1  194.120  473.280  MX  PLACED  _32587_
i_lisa_periph.i_lisa_uart_2.i_lisa_rx8n_2.fifo[6][0]  flop  sky130_fd_sc_hd__dfxtp_1  168.360  456.960  MX  PLACED  _32588_
i_lisa_periph.i_lisa_uart_2.i_lisa_rx8n_2.fifo[6][1]  flop  sky130_fd_sc_hd__dfxtp_1  175.720  473.280  MX  PLACED  _32589_
i_lisa_periph.i_lisa_uart_2.i_lisa_rx8n_2.fifo[6][2]  flop  sky130_fd_sc_hd__dfxtp_1  157.780  456.960  MX  PLACED  _32590_
i_lisa_periph.i_lisa_uart_2.i_lisa_rx8n_2.fifo[6][3]  flop  sky130_fd_sc_hd__dfxtp_1  184.460  456.960  MX  PLACED  _32591_
i_lisa_periph.i_lisa_uart_2.i_lisa_rx8n_2.fifo[6][4]  flop  sky130_fd_sc_hd__dfxtp_1  155.020  470.560  R0  PLACED  _32592_
i_lisa_periph.i_lisa_uart_2.i_lisa_rx8n_2.fifo[6][5]  flop  sky130_fd_sc_hd__dfxtp_1  183.540  459.680  R0  PLACED  _32593_
i_lisa_periph.i_lisa_uart_2.i_lisa_rx8n_2.fifo[6][6]  flop  sky130_fd_sc_hd__dfxtp_1  153.640  465.120  R0  PLACED  _32594_
i_lisa_periph.i_lisa_uart_2.i_lisa_rx8n_2.fifo[6][7]  flop  sky130_fd_sc_hd__dfxtp_1  183.080  465.120  R0  PLACED  _32595_
i_lisa_periph.i_lisa_uart_2.i_lisa_rx8n_2.fifo[7][0]  flop  sky130_fd_sc_hd__dfxtp_1  167.440  451.520  MX  PLACED  _32596_
i_lisa_periph.i_lisa_uart_2.i_lisa_rx8n_2.fifo[7][1]  flop  sky130_fd_sc_hd__dfxtp_1  175.720  467.840  MX  PLACED  _32597_
i_lisa_periph.i_lisa_uart_2.i_lisa_rx8n_2.fifo[7][2]  flop  sky130_fd_sc_hd__dfxtp_1  162.840  459.680  R0  PLACED  _32598_
i_lisa_periph.i_lisa_uart_2.i_lisa_rx8n_2.fifo[7][3]  flop  sky130_fd_sc_hd__dfxtp_1  188.140  448.800  R0  PLACED  _32599_
i_lisa_periph.i_lisa_uart_2.i_lisa_rx8n_2.fifo[7][4]  flop  sky130_fd_sc_hd__dfxtp_1  161.000  473.280  MX  PLACED  _32600_
i_lisa_periph.i_lisa_uart_2.i_lisa_rx8n_2.fifo[7][5]  flop  sky130_fd_sc_hd__dfxtp_1  189.060  462.400  MX  PLACED  _32601_
i_lisa_periph.i_lisa_uart_2.i_lisa_rx8n_2.fifo[7][6]  flop  sky130_fd_sc_hd__dfxtp_1  161.000  465.120  R0  PLACED  _32602_
i_lisa_periph.i_lisa_uart_2.i_lisa_rx8n_2.fifo[7][7]  flop  sky130_fd_sc_hd__dfxtp_1  188.140  467.840  MX  PLACED  _32603_
i_lisa_periph.i_lisa_uart_2.i_lisa_rx8n_2.push  flop  sky130_fd_sc_hd__dfxtp_1  171.120  486.880  R0  PLACED  _33848_
i_lisa_periph.i_lisa_uart_2.i_lisa_rx8n_2.rd_ptr[0]  flop  sky130_fd_sc_hd__dfxtp_1  188.600  443.360  R0  PLACED  _33880_
i_lisa_periph.i_lisa_uart_2.i_lisa_rx8n_2.rd_ptr[1]  flop  sky130_fd_sc_hd__dfxtp_1  192.280  435.200  MX  PLACED  _33881_
i_lisa_periph.i_lisa_uart_2.i_lisa_rx8n_2.rd_ptr[2]  flop  sky130_fd_sc_hd__dfxtp_1  181.700  437.920  R0  PLACED  _33882_
i_lisa_periph.i_lisa_uart_2.i_lisa_rx8n_2.rd_ptr[3]  flop  sky130_fd_sc_hd__dfxtp_1  172.040  435.200  MX  PLACED  _33883_
i_lisa_periph.i_lisa_uart_2.i_lisa_rx8n_2.rx_byte[0]  flop  sky130_fd_sc_hd__dfxtp_1  176.180  492.320  R0  PLACED  _33867_
i_lisa_periph.i_lisa_uart_2.i_lisa_rx8n_2.rx_byte[1]  flop  sky130_fd_sc_hd__dfxtp_1  175.720  495.040  MX  PLACED  _33868_
i_lisa_periph.i_lisa_uart_2.i_lisa_rx8n_2.rx_byte[2]  flop  sky130_fd_sc_hd__dfxtp_1  168.360  489.600  MX  PLACED  _33869_
i_lisa_periph.i_lisa_uart_2.i_lisa_rx8n_2.rx_byte[3]  flop  sky130_fd_sc_hd__dfxtp_1  165.140  495.040  MX  PLACED  _33870_
i_lisa_periph.i_lisa_uart_2.i_lisa_rx8n_2.rx_byte[4]  flop  sky130_fd_sc_hd__dfxtp_1  161.460  486.880  R0  PLACED  _33871_
i_lisa_periph.i_lisa_uart_2.i_lisa_rx8n_2.rx_byte[5]  flop  sky130_fd_sc_hd__dfxtp_1  154.100  486.880  R0  PLACED  _33872_
i_lisa_periph.i_lisa_uart_2.i_lisa_rx8n_2.rx_byte[6]  flop  sky130_fd_sc_hd__dfxtp_1  146.740  486.880  R0  PLACED  _33873_
i_lisa_periph.i_lisa_uart_2.i_lisa_rx8n_2.rx_byte[7]  flop  sky130_fd_sc_hd__dfxtp_1  142.140  489.600  MX  PLACED  _33874_
i_lisa_periph.i_lisa_uart_2.i_lisa_rx8n_2.s_baud_edge  flop  sky130_fd_sc_hd__dfxtp_1  279.220  492.320  R0  PLACED  _33865_
i_lisa_periph.i_lisa_uart_2.i_lisa_rx8n_2.s_last_rd  flop  sky130_fd_sc_hd__dfxtp_1  198.720  440.640  MX  PLACED  _33879_
i_lisa_periph.i_lisa_uart_2.i_lisa_rx8n_2.s_rxd  flop  sky130_fd_sc_hd__dfxtp_1  288.420  492.320  R0  PLACED  _33866_
i_lisa_periph.i_lisa_uart_2.i_lisa_rx8n_2.shift[0]  flop  sky130_fd_sc_hd__dfxtp_1  179.860  503.200  R0  PLACED  _33857_
i_lisa_periph.i_lisa_uart_2.i_lisa_rx8n_2.shift[1]  flop  sky130_fd_sc_hd__dfxtp_1  172.040  503.200  R0  PLACED  _33858_
i_lisa_periph.i_lisa_uart_2.i_lisa_rx8n_2.shift[2]  flop  sky130_fd_sc_hd__dfxtp_1  162.840  503.200  R0  PLACED  _33859_
i_lisa_periph.i_lisa_uart_2.i_lisa_rx8n_2.shift[3]  flop  sky130_fd_sc_hd__dfxtp_1  159.160  500.480  MX  PLACED  _33860_
i_lisa_periph.i_lisa_uart_2.i_lisa_rx8n_2.shift[4]  flop  sky130_fd_sc_hd__dfxtp_1  157.780  495.040  MX  PLACED  _33861_
i_lisa_periph.i_lisa_uart_2.i_lisa_rx8n_2.shift[5]  flop  sky130_fd_sc_hd__dfxtp_1  150.880  503.200  R0  PLACED  _33862_
i_lisa_periph.i_lisa_uart_2.i_lisa_rx8n_2.shift[6]  flop  sky130_fd_sc_hd__dfxtp_1  143.980  500.480  MX  PLACED  _33863_
i_lisa_periph.i_lisa_uart_2.i_lisa_rx8n_2.shift[7]  flop  sky130_fd_sc_hd__dfxtp_1  141.680  495.040  MX  PLACED  _33864_
i_lisa_periph.i_lisa_uart_2.i_lisa_rx8n_2.wr_ptr[0]  flop  sky130_fd_sc_hd__dfxtp_1  164.220  446.080  MX  PLACED  _33875_
i_lisa_periph.i_lisa_uart_2.i_lisa_rx8n_2.wr_ptr[1]  flop  sky130_fd_sc_hd__dfxtp_1  149.960  446.080  MX  PLACED  _33876_
i_lisa_periph.i_lisa_uart_2.i_lisa_rx8n_2.wr_ptr[2]  flop  sky130_fd_sc_hd__dfxtp_1  149.960  440.640  MX  PLACED  _33877_
i_lisa_periph.i_lisa_uart_2.i_lisa_rx8n_2.wr_ptr[3]  flop  sky130_fd_sc_hd__dfxtp_1  162.840  440.640  MX  PLACED  _33878_
i_lisa_periph.i_lisa_uart_2.i_lisa_tx8n_2.bit_count[0]  flop  sky130_fd_sc_hd__dfxtp_1  265.880  503.200  R0  PLACED  _33885_
i_lisa_periph.i_lisa_uart_2.i_lisa_tx8n_2.bit_count[1]  flop  sky130_fd_sc_hd__dfxtp_1  267.720  500.480  MX  PLACED  _33886_
i_lisa_periph.i_lisa_uart_2.i_lisa_tx8n_2.bit_count[2]  flop  sky130_fd_sc_hd__dfxtp_1  280.600  503.200  R0  PLACED  _33887_
i_lisa_periph.i_lisa_uart_2.i_lisa_tx8n_2.clock_count[0]  flop  sky130_fd_sc_hd__dfxtp_1  260.820  495.040  MX  PLACED  _33909_
i_lisa_periph.i_lisa_uart_2.i_lisa_tx8n_2.clock_count[1]  flop  sky130_fd_sc_hd__dfxtp_1  252.080  495.040  MX  PLACED  _33910_
i_lisa_periph.i_lisa_uart_2.i_lisa_tx8n_2.clock_count[2]  flop  sky130_fd_sc_hd__dfxtp_1  248.860  503.200  R0  PLACED  _33911_
i_lisa_periph.i_lisa_uart_2.i_lisa_tx8n_2.clock_count[3]  flop  sky130_fd_sc_hd__dfxtp_1  258.520  503.200  R0  PLACED  _33912_
i_lisa_periph.i_lisa_uart_2.i_lisa_tx8n_2.dbuf[0]  flop  sky130_fd_sc_hd__dfxtp_1  329.820  486.880  R0  PLACED  _33900_
i_lisa_periph.i_lisa_uart_2.i_lisa_tx8n_2.dbuf[1]  flop  sky130_fd_sc_hd__dfxtp_1  335.800  492.320  R0  PLACED  _33901_
i_lisa_periph.i_lisa_uart_2.i_lisa_tx8n_2.dbuf[2]  flop  sky130_fd_sc_hd__dfxtp_1  338.100  489.600  MX  PLACED  _33902_
i_lisa_periph.i_lisa_uart_2.i_lisa_tx8n_2.dbuf[3]  flop  sky130_fd_sc_hd__dfxtp_1  346.840  489.600  MX  PLACED  _33903_
i_lisa_periph.i_lisa_uart_2.i_lisa_tx8n_2.dbuf[4]  flop  sky130_fd_sc_hd__dfxtp_1  345.000  495.040  MX  PLACED  _33904_
i_lisa_periph.i_lisa_uart_2.i_lisa_tx8n_2.dbuf[5]  flop  sky130_fd_sc_hd__dfxtp_1  330.280  495.040  MX  PLACED  _33905_
i_lisa_periph.i_lisa_uart_2.i_lisa_tx8n_2.dbuf[6]  flop  sky130_fd_sc_hd__dfxtp_1  320.620  495.040  MX  PLACED  _33906_
i_lisa_periph.i_lisa_uart_2.i_lisa_tx8n_2.dbuf[7]  flop  sky130_fd_sc_hd__dfxtp_1  321.080  489.600  MX  PLACED  _33907_
i_lisa_periph.i_lisa_uart_2.i_lisa_tx8n_2.mode[0]  flop  sky130_fd_sc_hd__dfxtp_1  304.980  503.200  R0  PLACED  _34383_
i_lisa_periph.i_lisa_uart_2.i_lisa_tx8n_2.mode[1]  flop  sky130_fd_sc_hd__dfxtp_1  293.020  500.480  MX  PLACED  _34384_
i_lisa_periph.i_lisa_uart_2.i_lisa_tx8n_2.mode[2]  flop  sky130_fd_sc_hd__dfxtp_1  292.100  495.040  MX  PLACED  _34385_
i_lisa_periph.i_lisa_uart_2.i_lisa_tx8n_2.mode[3]  flop  sky130_fd_sc_hd__dfxtp_1  291.640  503.200  R0  PLACED  _34386_
i_lisa_periph.i_lisa_uart_2.i_lisa_tx8n_2.s_buf_sent  flop  sky130_fd_sc_hd__dfxtp_1  312.340  489.600  MX  PLACED  _33897_
i_lisa_periph.i_lisa_uart_2.i_lisa_tx8n_2.s_buf_wr  flop  sky130_fd_sc_hd__dfxtp_1  321.080  484.160  MX  PLACED  _33908_
i_lisa_periph.i_lisa_uart_2.i_lisa_tx8n_2.s_latch_be  flop  sky130_fd_sc_hd__dfxtp_1  300.380  492.320  R0  PLACED  _33898_
i_lisa_periph.i_lisa_uart_2.i_lisa_tx8n_2.s_wr_edge  flop  sky130_fd_sc_hd__dfxtp_1  327.060  481.440  R0  PLACED  _33899_
i_lisa_periph.i_lisa_uart_2.i_lisa_tx8n_2.shift[0]  flop  sky130_fd_sc_hd__dfxtp_1  312.340  503.200  R0  PLACED  _33889_
i_lisa_periph.i_lisa_uart_2.i_lisa_tx8n_2.shift[1]  flop  sky130_fd_sc_hd__dfxtp_1  327.060  503.200  R0  PLACED  _33890_
i_lisa_periph.i_lisa_uart_2.i_lisa_tx8n_2.shift[2]  flop  sky130_fd_sc_hd__dfxtp_1  335.800  503.200  R0  PLACED  _33891_
i_lisa_periph.i_lisa_uart_2.i_lisa_tx8n_2.shift[3]  flop  sky130_fd_sc_hd__dfxtp_1  352.820  495.040  MX  PLACED  _33892_
i_lisa_periph.i_lisa_uart_2.i_lisa_tx8n_2.shift[4]  flop  sky130_fd_sc_hd__dfxtp_1  351.440  503.200  R0  PLACED  _33893_
i_lisa_periph.i_lisa_uart_2.i_lisa_tx8n_2.shift[5]  flop  sky130_fd_sc_hd__dfxtp_1  343.160  503.200  R0  PLACED  _33894_
i_lisa_periph.i_lisa_uart_2.i_lisa_tx8n_2.shift[6]  flop  sky130_fd_sc_hd__dfxtp_1  322.000  500.480  MX  PLACED  _33895_
i_lisa_periph.i_lisa_uart_2.i_lisa_tx8n_2.shift[7]  flop  sky130_fd_sc_hd__dfxtp_1  313.720  497.760  R0  PLACED  _33896_
i_lisa_periph.i_lisa_uart_2.i_lisa_tx8n_2.zero_clock  flop  sky130_fd_sc_hd__dfxtp_1  268.180  495.040  MX  PLACED  _33888_
i_lisa_periph.i_lisa_uart_2.s_rx_pipe[0]  flop  sky130_fd_sc_hd__dfxtp_1  429.640  440.640  MX  PLACED  _33801_
i_lisa_periph.ms2_count[0]  flop  sky130_fd_sc_hd__dfxtp_1  559.820  484.160  MX  PLACED  _33620_
i_lisa_periph.ms2_count[10]  flop  sky130_fd_sc_hd__dfxtp_1  528.080  495.040  MX  PLACED  _33630_
i_lisa_periph.ms2_count[11]  flop  sky130_fd_sc_hd__dfxtp_1  510.140  497.760  R0  PLACED  _33631_
i_lisa_periph.ms2_count[12]  flop  sky130_fd_sc_hd__dfxtp_1  512.900  503.200  R0  PLACED  _33632_
i_lisa_periph.ms2_count[13]  flop  sky130_fd_sc_hd__dfxtp_1  520.260  503.200  R0  PLACED  _33633_
i_lisa_periph.ms2_count[14]  flop  sky130_fd_sc_hd__dfxtp_1  526.240  500.480  MX  PLACED  _33634_
i_lisa_periph.ms2_count[15]  flop  sky130_fd_sc_hd__dfxtp_1  532.680  503.200  R0  PLACED  _33635_
i_lisa_periph.ms2_count[1]  flop  sky130_fd_sc_hd__dfxtp_1  562.120  489.600  MX  PLACED  _33621_
i_lisa_periph.ms2_count[2]  flop  sky130_fd_sc_hd__dfxtp_1  554.760  489.600  MX  PLACED  _33622_
i_lisa_periph.ms2_count[3]  flop  sky130_fd_sc_hd__dfxtp_1  544.180  489.600  MX  PLACED  _33623_
i_lisa_periph.ms2_count[4]  flop  sky130_fd_sc_hd__dfxtp_1  547.860  492.320  R0  PLACED  _33624_
i_lisa_periph.ms2_count[5]  flop  sky130_fd_sc_hd__dfxtp_1  549.240  497.760  R0  PLACED  _33625_
i_lisa_periph.ms2_count[6]  flop  sky130_fd_sc_hd__dfxtp_1  548.780  503.200  R0  PLACED  _33626_
i_lisa_periph.ms2_count[7]  flop  sky130_fd_sc_hd__dfxtp_1  540.960  503.200  R0  PLACED  _33627_
i_lisa_periph.ms2_count[8]  flop  sky130_fd_sc_hd__dfxtp_1  538.660  497.760  R0  PLACED  _33628_
i_lisa_periph.ms2_count[9]  flop  sky130_fd_sc_hd__dfxtp_1  534.520  492.320  R0  PLACED  _33629_
i_lisa_periph.ms2_enable  flop  sky130_fd_sc_hd__dfxtp_1  396.060  440.640  MX  PLACED  _33692_
i_lisa_periph.ms2_prediv[0]  flop  sky130_fd_sc_hd__dfxtp_1  508.760  473.280  MX  PLACED  _33636_
i_lisa_periph.ms2_prediv[10]  flop  sky130_fd_sc_hd__dfxtp_1  514.740  481.440  R0  PLACED  _33646_
i_lisa_periph.ms2_prediv[11]  flop  sky130_fd_sc_hd__dfxtp_1  498.180  484.160  MX  PLACED  _33647_
i_lisa_periph.ms2_prediv[12]  flop  sky130_fd_sc_hd__dfxtp_1  505.540  495.040  MX  PLACED  _33648_
i_lisa_periph.ms2_prediv[13]  flop  sky130_fd_sc_hd__dfxtp_1  518.420  489.600  MX  PLACED  _33649_
i_lisa_periph.ms2_prediv[14]  flop  sky130_fd_sc_hd__dfxtp_1  509.680  489.600  MX  PLACED  _33650_
i_lisa_periph.ms2_prediv[15]  flop  sky130_fd_sc_hd__dfxtp_1  523.020  484.160  MX  PLACED  _33651_
i_lisa_periph.ms2_prediv[1]  flop  sky130_fd_sc_hd__dfxtp_1  523.940  478.720  MX  PLACED  _33637_
i_lisa_periph.ms2_prediv[2]  flop  sky130_fd_sc_hd__dfxtp_1  547.400  473.280  MX  PLACED  _33638_
i_lisa_periph.ms2_prediv[3]  flop  sky130_fd_sc_hd__dfxtp_1  505.540  476.000  R0  PLACED  _33639_
i_lisa_periph.ms2_prediv[4]  flop  sky130_fd_sc_hd__dfxtp_1  547.400  476.000  R0  PLACED  _33640_
i_lisa_periph.ms2_prediv[5]  flop  sky130_fd_sc_hd__dfxtp_1  544.180  484.160  MX  PLACED  _33641_
i_lisa_periph.ms2_prediv[6]  flop  sky130_fd_sc_hd__dfxtp_1  532.680  478.720  MX  PLACED  _33642_
i_lisa_periph.ms2_prediv[7]  flop  sky130_fd_sc_hd__dfxtp_1  516.120  476.000  R0  PLACED  _33643_
i_lisa_periph.ms2_prediv[8]  flop  sky130_fd_sc_hd__dfxtp_1  505.540  481.440  R0  PLACED  _33644_
i_lisa_periph.ms2_prediv[9]  flop  sky130_fd_sc_hd__dfxtp_1  493.580  478.720  MX  PLACED  _33645_
i_lisa_periph.ms2_preload[0]  flop  sky130_fd_sc_hd__dfxtp_1  454.940  476.000  R0  PLACED  _33652_
i_lisa_periph.ms2_preload[10]  flop  sky130_fd_sc_hd__dfxtp_1  468.280  473.280  MX  PLACED  _33662_
i_lisa_periph.ms2_preload[11]  flop  sky130_fd_sc_hd__dfxtp_1  483.460  484.160  MX  PLACED  _33663_
i_lisa_periph.ms2_preload[12]  flop  sky130_fd_sc_hd__dfxtp_1  476.100  484.160  MX  PLACED  _33664_
i_lisa_periph.ms2_preload[13]  flop  sky130_fd_sc_hd__dfxtp_1  487.140  476.000  R0  PLACED  _33665_
i_lisa_periph.ms2_preload[14]  flop  sky130_fd_sc_hd__dfxtp_1  491.740  486.880  R0  PLACED  _33666_
i_lisa_periph.ms2_preload[15]  flop  sky130_fd_sc_hd__dfxtp_1  479.780  476.000  R0  PLACED  _33667_
i_lisa_periph.ms2_preload[1]  flop  sky130_fd_sc_hd__dfxtp_1  441.140  489.600  MX  PLACED  _33653_
i_lisa_periph.ms2_preload[2]  flop  sky130_fd_sc_hd__dfxtp_1  431.020  489.600  MX  PLACED  _33654_
i_lisa_periph.ms2_preload[3]  flop  sky130_fd_sc_hd__dfxtp_1  444.360  476.000  R0  PLACED  _33655_
i_lisa_periph.ms2_preload[4]  flop  sky130_fd_sc_hd__dfxtp_1  441.140  484.160  MX  PLACED  _33656_
i_lisa_periph.ms2_preload[5]  flop  sky130_fd_sc_hd__dfxtp_1  428.260  495.040  MX  PLACED  _33657_
i_lisa_periph.ms2_preload[6]  flop  sky130_fd_sc_hd__dfxtp_1  450.340  484.160  MX  PLACED  _33658_
i_lisa_periph.ms2_preload[7]  flop  sky130_fd_sc_hd__dfxtp_1  450.340  478.720  MX  PLACED  _33659_
i_lisa_periph.ms2_preload[8]  flop  sky130_fd_sc_hd__dfxtp_1  463.680  476.000  R0  PLACED  _33660_
i_lisa_periph.ms2_preload[9]  flop  sky130_fd_sc_hd__dfxtp_1  468.740  484.160  MX  PLACED  _33661_
i_lisa_periph.ms2_rollover  flop  sky130_fd_sc_hd__dfxtp_1  404.340  424.320  MX  PLACED  _33693_
i_lisa_periph.ms2_tick[0]  flop  sky130_fd_sc_hd__dfxtp_1  358.800  443.360  R0  PLACED  _33684_
i_lisa_periph.ms2_tick[1]  flop  sky130_fd_sc_hd__dfxtp_1  369.840  446.080  MX  PLACED  _33685_
i_lisa_periph.ms2_tick[2]  flop  sky130_fd_sc_hd__dfxtp_1  389.620  446.080  MX  PLACED  _33686_
i_lisa_periph.ms2_tick[3]  flop  sky130_fd_sc_hd__dfxtp_1  356.040  435.200  MX  PLACED  _33687_
i_lisa_periph.ms2_tick[4]  flop  sky130_fd_sc_hd__dfxtp_1  379.500  437.920  R0  PLACED  _33688_
i_lisa_periph.ms2_tick[5]  flop  sky130_fd_sc_hd__dfxtp_1  368.920  503.200  R0  PLACED  _33689_
i_lisa_periph.ms2_tick[6]  flop  sky130_fd_sc_hd__dfxtp_1  361.100  503.200  R0  PLACED  _33690_
i_lisa_periph.ms2_tick[7]  flop  sky130_fd_sc_hd__dfxtp_1  355.120  489.600  MX  PLACED  _33691_
i_lisa_periph.ms2_timer[0]  flop  sky130_fd_sc_hd__dfxtp_1  459.080  484.160  MX  PLACED  _33668_
i_lisa_periph.ms2_timer[10]  flop  sky130_fd_sc_hd__dfxtp_1  471.960  503.200  R0  PLACED  _33678_
i_lisa_periph.ms2_timer[11]  flop  sky130_fd_sc_hd__dfxtp_1  483.920  503.200  R0  PLACED  _33679_
i_lisa_periph.ms2_timer[12]  flop  sky130_fd_sc_hd__dfxtp_1  488.060  497.760  R0  PLACED  _33680_
i_lisa_periph.ms2_timer[13]  flop  sky130_fd_sc_hd__dfxtp_1  495.880  492.320  R0  PLACED  _33681_
i_lisa_periph.ms2_timer[14]  flop  sky130_fd_sc_hd__dfxtp_1  505.540  503.200  R0  PLACED  _33682_
i_lisa_periph.ms2_timer[15]  flop  sky130_fd_sc_hd__dfxtp_1  493.580  503.200  R0  PLACED  _33683_
i_lisa_periph.ms2_timer[1]  flop  sky130_fd_sc_hd__dfxtp_1  462.300  503.200  R0  PLACED  _33669_
i_lisa_periph.ms2_timer[2]  flop  sky130_fd_sc_hd__dfxtp_1  452.180  500.480  MX  PLACED  _33670_
i_lisa_periph.ms2_timer[3]  flop  sky130_fd_sc_hd__dfxtp_1  433.320  497.760  R0  PLACED  _33671_
i_lisa_periph.ms2_timer[4]  flop  sky130_fd_sc_hd__dfxtp_1  446.200  503.200  R0  PLACED  _33672_
i_lisa_periph.ms2_timer[5]  flop  sky130_fd_sc_hd__dfxtp_1  429.180  503.200  R0  PLACED  _33673_
i_lisa_periph.ms2_timer[6]  flop  sky130_fd_sc_hd__dfxtp_1  436.540  503.200  R0  PLACED  _33674_
i_lisa_periph.ms2_timer[7]  flop  sky130_fd_sc_hd__dfxtp_1  462.300  486.880  R0  PLACED  _33675_
i_lisa_periph.ms2_timer[8]  flop  sky130_fd_sc_hd__dfxtp_1  471.040  495.040  MX  PLACED  _33676_
i_lisa_periph.ms2_timer[9]  flop  sky130_fd_sc_hd__dfxtp_1  479.780  492.320  R0  PLACED  _33677_
i_lisa_periph.ms_count[0]  flop  sky130_fd_sc_hd__dfxtp_1  526.700  418.880  MX  PLACED  _33517_
i_lisa_periph.ms_count[10]  flop  sky130_fd_sc_hd__dfxtp_1  544.180  429.760  MX  PLACED  _33527_
i_lisa_periph.ms_count[11]  flop  sky130_fd_sc_hd__dfxtp_1  549.240  432.480  R0  PLACED  _33528_
i_lisa_periph.ms_count[12]  flop  sky130_fd_sc_hd__dfxtp_1  551.080  435.200  MX  PLACED  _33529_
i_lisa_periph.ms_count[13]  flop  sky130_fd_sc_hd__dfxtp_1  548.780  443.360  R0  PLACED  _33530_
i_lisa_periph.ms_count[14]  flop  sky130_fd_sc_hd__dfxtp_1  537.280  443.360  R0  PLACED  _33531_
i_lisa_periph.ms_count[15]  flop  sky130_fd_sc_hd__dfxtp_1  544.640  446.080  MX  PLACED  _33532_
i_lisa_periph.ms_count[1]  flop  sky130_fd_sc_hd__dfxtp_1  534.060  418.880  MX  PLACED  _33518_
i_lisa_periph.ms_count[2]  flop  sky130_fd_sc_hd__dfxtp_1  518.420  418.880  MX  PLACED  _33519_
i_lisa_periph.ms_count[3]  flop  sky130_fd_sc_hd__dfxtp_1  510.140  424.320  MX  PLACED  _33520_
i_lisa_periph.ms_count[4]  flop  sky130_fd_sc_hd__dfxtp_1  510.600  429.760  MX  PLACED  _33521_
i_lisa_periph.ms_count[5]  flop  sky130_fd_sc_hd__dfxtp_1  520.720  427.040  R0  PLACED  _33522_
i_lisa_periph.ms_count[6]  flop  sky130_fd_sc_hd__dfxtp_1  527.620  424.320  MX  PLACED  _33523_
i_lisa_periph.ms_count[7]  flop  sky130_fd_sc_hd__dfxtp_1  534.980  424.320  MX  PLACED  _33524_
i_lisa_periph.ms_count[8]  flop  sky130_fd_sc_hd__dfxtp_1  541.420  421.600  R0  PLACED  _33525_
i_lisa_periph.ms_count[9]  flop  sky130_fd_sc_hd__dfxtp_1  546.020  427.040  R0  PLACED  _33526_
i_lisa_periph.ms_enable  flop  sky130_fd_sc_hd__dfxtp_1  430.560  429.760  MX  PLACED  _33589_
i_lisa_periph.ms_prediv[0]  flop  sky130_fd_sc_hd__dfxtp_1  506.920  459.680  R0  PLACED  _33533_
i_lisa_periph.ms_prediv[10]  flop  sky130_fd_sc_hd__dfxtp_1  534.980  454.240  R0  PLACED  _33543_
i_lisa_periph.ms_prediv[11]  flop  sky130_fd_sc_hd__dfxtp_1  496.800  459.680  R0  PLACED  _33544_
i_lisa_periph.ms_prediv[12]  flop  sky130_fd_sc_hd__dfxtp_1  523.480  454.240  R0  PLACED  _33545_
i_lisa_periph.ms_prediv[13]  flop  sky130_fd_sc_hd__dfxtp_1  520.720  459.680  R0  PLACED  _33546_
i_lisa_periph.ms_prediv[14]  flop  sky130_fd_sc_hd__dfxtp_1  528.080  456.960  MX  PLACED  _33547_
i_lisa_periph.ms_prediv[15]  flop  sky130_fd_sc_hd__dfxtp_1  524.400  446.080  MX  PLACED  _33548_
i_lisa_periph.ms_prediv[1]  flop  sky130_fd_sc_hd__dfxtp_1  518.420  451.520  MX  PLACED  _33534_
i_lisa_periph.ms_prediv[2]  flop  sky130_fd_sc_hd__dfxtp_1  505.540  448.800  R0  PLACED  _33535_
i_lisa_periph.ms_prediv[3]  flop  sky130_fd_sc_hd__dfxtp_1  500.940  451.520  MX  PLACED  _33536_
i_lisa_periph.ms_prediv[4]  flop  sky130_fd_sc_hd__dfxtp_1  513.820  443.360  R0  PLACED  _33537_
i_lisa_periph.ms_prediv[5]  flop  sky130_fd_sc_hd__dfxtp_1  510.600  456.960  MX  PLACED  _33538_
i_lisa_periph.ms_prediv[6]  flop  sky130_fd_sc_hd__dfxtp_1  504.620  435.200  MX  PLACED  _33539_
i_lisa_periph.ms_prediv[7]  flop  sky130_fd_sc_hd__dfxtp_1  500.020  440.640  MX  PLACED  _33540_
i_lisa_periph.ms_prediv[8]  flop  sky130_fd_sc_hd__dfxtp_1  536.360  456.960  MX  PLACED  _33541_
i_lisa_periph.ms_prediv[9]  flop  sky130_fd_sc_hd__dfxtp_1  534.980  448.800  R0  PLACED  _33542_
i_lisa_periph.ms_preload[0]  flop  sky130_fd_sc_hd__dfxtp_1  446.200  446.080  MX  PLACED  _33549_
i_lisa_periph.ms_preload[10]  flop  sky130_fd_sc_hd__dfxtp_1  470.120  451.520  MX  PLACED  _33559_
i_lisa_periph.ms_preload[11]  flop  sky130_fd_sc_hd__dfxtp_1  463.220  459.680  R0  PLACED  _33560_
i_lisa_periph.ms_preload[12]  flop  sky130_fd_sc_hd__dfxtp_1  481.620  451.520  MX  PLACED  _33561_
i_lisa_periph.ms_preload[13]  flop  sky130_fd_sc_hd__dfxtp_1  470.580  459.680  R0  PLACED  _33562_
i_lisa_periph.ms_preload[14]  flop  sky130_fd_sc_hd__dfxtp_1  487.140  459.680  R0  PLACED  _33563_
i_lisa_periph.ms_preload[15]  flop  sky130_fd_sc_hd__dfxtp_1  479.780  459.680  R0  PLACED  _33564_
i_lisa_periph.ms_preload[1]  flop  sky130_fd_sc_hd__dfxtp_1  492.660  440.640  MX  PLACED  _33550_
i_lisa_periph.ms_preload[2]  flop  sky130_fd_sc_hd__dfxtp_1  472.880  446.080  MX  PLACED  _33551_
i_lisa_periph.ms_preload[3]  flop  sky130_fd_sc_hd__dfxtp_1  488.060  448.800  R0  PLACED  _33552_
i_lisa_periph.ms_preload[4]  flop  sky130_fd_sc_hd__dfxtp_1  462.760  443.360  R0  PLACED  _33553_
i_lisa_periph.ms_preload[5]  flop  sky130_fd_sc_hd__dfxtp_1  459.080  440.640  MX  PLACED  _33554_
i_lisa_periph.ms_preload[6]  flop  sky130_fd_sc_hd__dfxtp_1  450.800  440.640  MX  PLACED  _33555_
i_lisa_periph.ms_preload[7]  flop  sky130_fd_sc_hd__dfxtp_1  482.080  446.080  MX  PLACED  _33556_
i_lisa_periph.ms_preload[8]  flop  sky130_fd_sc_hd__dfxtp_1  454.020  454.240  R0  PLACED  _33557_
i_lisa_periph.ms_preload[9]  flop  sky130_fd_sc_hd__dfxtp_1  461.380  454.240  R0  PLACED  _33558_
i_lisa_periph.ms_rollover  flop  sky130_fd_sc_hd__dfxtp_1  429.180  437.920  R0  PLACED  _33590_
i_lisa_periph.ms_tick[0]  flop  sky130_fd_sc_hd__dfxtp_1  454.480  405.280  R0  PLACED  _33581_
i_lisa_periph.ms_tick[1]  flop  sky130_fd_sc_hd__dfxtp_1  439.300  405.280  R0  PLACED  _33582_
i_lisa_periph.ms_tick[2]  flop  sky130_fd_sc_hd__dfxtp_1  450.340  413.440  MX  PLACED  _33583_
i_lisa_periph.ms_tick[3]  flop  sky130_fd_sc_hd__dfxtp_1  429.180  405.280  R0  PLACED  _33584_
i_lisa_periph.ms_tick[4]  flop  sky130_fd_sc_hd__dfxtp_1  421.360  413.440  MX  PLACED  _33585_
i_lisa_periph.ms_tick[5]  flop  sky130_fd_sc_hd__dfxtp_1  443.440  421.600  R0  PLACED  _33586_
i_lisa_periph.ms_tick[6]  flop  sky130_fd_sc_hd__dfxtp_1  441.140  429.760  MX  PLACED  _33587_
i_lisa_periph.ms_tick[7]  flop  sky130_fd_sc_hd__dfxtp_1  443.900  437.920  R0  PLACED  _33588_
i_lisa_periph.ms_timer[0]  flop  sky130_fd_sc_hd__dfxtp_1  450.800  418.880  MX  PLACED  _33565_
i_lisa_periph.ms_timer[10]  flop  sky130_fd_sc_hd__dfxtp_1  466.900  435.200  MX  PLACED  _33575_
i_lisa_periph.ms_timer[11]  flop  sky130_fd_sc_hd__dfxtp_1  479.780  437.920  R0  PLACED  _33576_
i_lisa_periph.ms_timer[12]  flop  sky130_fd_sc_hd__dfxtp_1  492.660  435.200  MX  PLACED  _33577_
i_lisa_periph.ms_timer[13]  flop  sky130_fd_sc_hd__dfxtp_1  474.720  429.760  MX  PLACED  _33578_
i_lisa_periph.ms_timer[14]  flop  sky130_fd_sc_hd__dfxtp_1  502.780  424.320  MX  PLACED  _33579_
i_lisa_periph.ms_timer[15]  flop  sky130_fd_sc_hd__dfxtp_1  491.740  427.040  R0  PLACED  _33580_
i_lisa_periph.ms_timer[1]  flop  sky130_fd_sc_hd__dfxtp_1  505.540  421.600  R0  PLACED  _33566_
i_lisa_periph.ms_timer[2]  flop  sky130_fd_sc_hd__dfxtp_1  496.800  418.880  MX  PLACED  _33567_
i_lisa_periph.ms_timer[3]  flop  sky130_fd_sc_hd__dfxtp_1  488.520  410.720  R0  PLACED  _33568_
i_lisa_periph.ms_timer[4]  flop  sky130_fd_sc_hd__dfxtp_1  477.480  408.000  MX  PLACED  _33569_
i_lisa_periph.ms_timer[5]  flop  sky130_fd_sc_hd__dfxtp_1  471.500  416.160  R0  PLACED  _33570_
i_lisa_periph.ms_timer[6]  flop  sky130_fd_sc_hd__dfxtp_1  460.000  410.720  R0  PLACED  _33571_
i_lisa_periph.ms_timer[7]  flop  sky130_fd_sc_hd__dfxtp_1  471.960  421.600  R0  PLACED  _33572_
i_lisa_periph.ms_timer[8]  flop  sky130_fd_sc_hd__dfxtp_1  459.080  424.320  MX  PLACED  _33573_
i_lisa_periph.ms_timer[9]  flop  sky130_fd_sc_hd__dfxtp_1  456.320  435.200  MX  PLACED  _33574_
i_lisa_periph.porta_int0[0]  flop  sky130_fd_sc_hd__dfxtp_1  371.680  478.720  MX  PLACED  _33603_
i_lisa_periph.porta_int0[1]  flop  sky130_fd_sc_hd__dfxtp_1  424.120  500.480  MX  PLACED  _33604_
i_lisa_periph.porta_int0[2]  flop  sky130_fd_sc_hd__dfxtp_1  423.660  478.720  MX  PLACED  _33605_
i_lisa_periph.porta_int0[3]  flop  sky130_fd_sc_hd__dfxtp_1  379.040  484.160  MX  PLACED  _33606_
i_lisa_periph.porta_int0[4]  flop  sky130_fd_sc_hd__dfxtp_1  420.440  505.920  MX  PLACED  _33607_
i_lisa_periph.porta_int0[5]  flop  sky130_fd_sc_hd__dfxtp_1  377.660  500.480  MX  PLACED  _33608_
i_lisa_periph.porta_int0[6]  flop  sky130_fd_sc_hd__dfxtp_1  414.920  503.200  R0  PLACED  _33609_
i_lisa_periph.porta_int0[7]  flop  sky130_fd_sc_hd__dfxtp_1  389.160  492.320  R0  PLACED  _33610_
i_lisa_periph.porta_int1[0]  flop  sky130_fd_sc_hd__dfxtp_1  391.000  481.440  R0  PLACED  _33611_
i_lisa_periph.porta_int1[1]  flop  sky130_fd_sc_hd__dfxtp_1  376.740  492.320  R0  PLACED  _33612_
i_lisa_periph.porta_int1[2]  flop  sky130_fd_sc_hd__dfxtp_1  412.160  486.880  R0  PLACED  _33613_
i_lisa_periph.porta_int1[3]  flop  sky130_fd_sc_hd__dfxtp_1  420.440  476.000  R0  PLACED  _33614_
i_lisa_periph.porta_int1[4]  flop  sky130_fd_sc_hd__dfxtp_1  420.440  492.320  R0  PLACED  _33615_
i_lisa_periph.porta_int1[5]  flop  sky130_fd_sc_hd__dfxtp_1  380.880  489.600  MX  PLACED  _33616_
i_lisa_periph.porta_int1[6]  flop  sky130_fd_sc_hd__dfxtp_1  415.380  495.040  MX  PLACED  _33617_
i_lisa_periph.porta_int1[7]  flop  sky130_fd_sc_hd__dfxtp_1  391.000  486.880  R0  PLACED  _33618_
i_lisa_periph.porta_last[0]  flop  sky130_fd_sc_hd__dfxtp_1  411.240  470.560  R0  PLACED  _33595_
i_lisa_periph.porta_last[1]  flop  sky130_fd_sc_hd__dfxtp_1  393.300  503.200  R0  PLACED  _33596_
i_lisa_periph.porta_last[2]  flop  sky130_fd_sc_hd__dfxtp_1  407.560  478.720  MX  PLACED  _33597_
i_lisa_periph.porta_last[3]  flop  sky130_fd_sc_hd__dfxtp_1  379.500  476.000  R0  PLACED  _33598_
i_lisa_periph.porta_last[4]  flop  sky130_fd_sc_hd__dfxtp_1  397.440  500.480  MX  PLACED  _33599_
i_lisa_periph.porta_last[5]  flop  sky130_fd_sc_hd__dfxtp_1  378.580  503.200  R0  PLACED  _33600_
i_lisa_periph.porta_last[6]  flop  sky130_fd_sc_hd__dfxtp_1  407.560  503.200  R0  PLACED  _33601_
i_lisa_periph.porta_last[7]  flop  sky130_fd_sc_hd__dfxtp_1  385.940  503.200  R0  PLACED  _33602_
i_lisa_periph.portd_in[0]  flop  sky130_fd_sc_hd__dfxtp_1  546.480  451.520  MX  PLACED  _34242_
i_lisa_periph.portd_in[1]  flop  sky130_fd_sc_hd__dfxtp_1  546.020  448.800  R0  PLACED  _34243_
i_lisa_periph.portd_in[2]  flop  sky130_fd_sc_hd__dfxtp_1  544.640  456.960  MX  PLACED  _34244_
i_lisa_periph.portd_in[3]  flop  sky130_fd_sc_hd__dfxtp_1  555.680  446.080  MX  PLACED  _34245_
i_lisa_periph.portd_in[4]  flop  sky130_fd_sc_hd__dfxtp_1  587.880  467.840  MX  PLACED  _34246_
i_lisa_periph.portd_in[5]  flop  sky130_fd_sc_hd__dfxtp_1  558.440  462.400  MX  PLACED  _34247_
i_lisa_periph.portd_in[6]  flop  sky130_fd_sc_hd__dfxtp_1  547.400  465.120  R0  PLACED  _34248_
i_lisa_periph.portd_in[7]  flop  sky130_fd_sc_hd__dfxtp_1  554.760  473.280  MX  PLACED  _34249_
i_lisa_periph.porte[0]  flop  sky130_fd_sc_hd__dfxtp_1  508.760  467.840  MX  PLACED  _33509_
i_lisa_periph.porte[1]  flop  sky130_fd_sc_hd__dfxtp_1  527.160  462.400  MX  PLACED  _33510_
i_lisa_periph.porte[2]  flop  sky130_fd_sc_hd__dfxtp_1  536.360  462.400  MX  PLACED  _33511_
i_lisa_periph.porte[3]  flop  sky130_fd_sc_hd__dfxtp_1  500.480  467.840  MX  PLACED  _33512_
i_lisa_periph.porte[4]  flop  sky130_fd_sc_hd__dfxtp_1  518.420  467.840  MX  PLACED  _33513_
i_lisa_periph.porte[5]  flop  sky130_fd_sc_hd__dfxtp_1  536.360  467.840  MX  PLACED  _33514_
i_lisa_periph.porte[6]  flop  sky130_fd_sc_hd__dfxtp_1  526.700  473.280  MX  PLACED  _33515_
i_lisa_periph.porte[7]  flop  sky130_fd_sc_hd__dfxtp_1  534.520  473.280  MX  PLACED  _33516_
i_lisa_periph.ttlc_int  flop  sky130_fd_sc_hd__dfxtp_1  564.420  427.040  R0  PLACED  _34250_
i_lisa_periph.ttlc_int_last  flop  sky130_fd_sc_hd__dfxtp_1  557.060  427.040  R0  PLACED  _33619_
i_lisa_qqspi.ce_delay_r[0]  flop  sky130_fd_sc_hd__dfxtp_1  554.760  380.800  MX  PLACED  _33973_
i_lisa_qqspi.ce_delay_r[1]  flop  sky130_fd_sc_hd__dfxtp_1  562.120  380.800  MX  PLACED  _33974_
i_lisa_qqspi.ce_delay_r[2]  flop  sky130_fd_sc_hd__dfxtp_1  572.700  383.520  R0  PLACED  _33975_
i_lisa_qqspi.ce_delay_r[3]  flop  sky130_fd_sc_hd__dfxtp_1  563.500  388.960  R0  PLACED  _33976_
i_lisa_qqspi.ce_delay_r[4]  flop  sky130_fd_sc_hd__dfxtp_1  571.320  391.680  MX  PLACED  _33977_
i_lisa_qqspi.ce_delay_r[5]  flop  sky130_fd_sc_hd__dfxtp_1  549.240  388.960  R0  PLACED  _33978_
i_lisa_qqspi.ce_delay_r[6]  flop  sky130_fd_sc_hd__dfxtp_1  558.440  394.400  R0  PLACED  _33979_
i_lisa_qqspi.clk_div_r[0]  flop  sky130_fd_sc_hd__dfxtp_1  454.020  399.840  R0  PLACED  _33969_
i_lisa_qqspi.clk_div_r[1]  flop  sky130_fd_sc_hd__dfxtp_1  441.600  399.840  R0  PLACED  _33970_
i_lisa_qqspi.clk_div_r[2]  flop  sky130_fd_sc_hd__dfxtp_1  433.320  399.840  R0  PLACED  _33971_
i_lisa_qqspi.clk_div_r[3]  flop  sky130_fd_sc_hd__dfxtp_1  441.600  391.680  MX  PLACED  _33972_
i_lisa_qqspi.is_quad  flop  sky130_fd_sc_hd__dfxtp_1  500.480  386.240  MX  PLACED  _33964_
i_lisa_qqspi.len_count[0]  flop  sky130_fd_sc_hd__dfxtp_1  573.160  367.200  R0  PLACED  _33965_
i_lisa_qqspi.len_count[1]  flop  sky130_fd_sc_hd__dfxtp_1  562.120  375.360  MX  PLACED  _33966_
i_lisa_qqspi.len_count[2]  flop  sky130_fd_sc_hd__dfxtp_1  586.960  372.640  R0  PLACED  _33967_
i_lisa_qqspi.len_count[3]  flop  sky130_fd_sc_hd__dfxtp_1  577.760  375.360  MX  PLACED  _33968_
i_lisa_qqspi.rdata[0]  flop  sky130_fd_sc_hd__dfxtp_1  533.140  274.720  R0  PLACED  _33913_
i_lisa_qqspi.rdata[10]  flop  sky130_fd_sc_hd__dfxtp_1  488.520  252.960  R0  PLACED  _33923_
i_lisa_qqspi.rdata[11]  flop  sky130_fd_sc_hd__dfxtp_1  518.420  255.680  MX  PLACED  _33924_
i_lisa_qqspi.rdata[12]  flop  sky130_fd_sc_hd__dfxtp_1  531.300  258.400  R0  PLACED  _33925_
i_lisa_qqspi.rdata[13]  flop  sky130_fd_sc_hd__dfxtp_1  528.080  250.240  MX  PLACED  _33926_
i_lisa_qqspi.rdata[14]  flop  sky130_fd_sc_hd__dfxtp_1  505.540  247.520  R0  PLACED  _33927_
i_lisa_qqspi.rdata[15]  flop  sky130_fd_sc_hd__dfxtp_1  516.120  247.520  R0  PLACED  _33928_
i_lisa_qqspi.rdata[1]  flop  sky130_fd_sc_hd__dfxtp_1  534.060  272.000  MX  PLACED  _33914_
i_lisa_qqspi.rdata[2]  flop  sky130_fd_sc_hd__dfxtp_1  491.280  280.160  R0  PLACED  _33915_
i_lisa_qqspi.rdata[3]  flop  sky130_fd_sc_hd__dfxtp_1  518.420  282.880  MX  PLACED  _33916_
i_lisa_qqspi.rdata[4]  flop  sky130_fd_sc_hd__dfxtp_1  470.580  274.720  R0  PLACED  _33917_
i_lisa_qqspi.rdata[5]  flop  sky130_fd_sc_hd__dfxtp_1  485.300  285.600  R0  PLACED  _33918_
i_lisa_qqspi.rdata[6]  flop  sky130_fd_sc_hd__dfxtp_1  508.760  291.040  R0  PLACED  _33919_
i_lisa_qqspi.rdata[7]  flop  sky130_fd_sc_hd__dfxtp_1  471.040  280.160  R0  PLACED  _33920_
i_lisa_qqspi.rdata[8]  flop  sky130_fd_sc_hd__dfxtp_1  534.980  252.960  R0  PLACED  _33921_
i_lisa_qqspi.rdata[9]  flop  sky130_fd_sc_hd__dfxtp_1  534.980  266.560  MX  PLACED  _33922_
i_lisa_qqspi.ready  flop  sky130_fd_sc_hd__dfxtp_1  546.020  380.800  MX  PLACED  _33929_
i_lisa_qqspi.spi_buf[0]  flop  sky130_fd_sc_hd__dfxtp_1  469.200  388.960  R0  PLACED  _33956_
i_lisa_qqspi.spi_buf[10]  flop  sky130_fd_sc_hd__dfxtp_1  500.480  272.000  MX  PLACED  _33942_
i_lisa_qqspi.spi_buf[11]  flop  sky130_fd_sc_hd__dfxtp_1  505.540  282.880  MX  PLACED  _33943_
i_lisa_qqspi.spi_buf[12]  flop  sky130_fd_sc_hd__dfxtp_1  481.620  282.880  MX  PLACED  _33944_
i_lisa_qqspi.spi_buf[13]  flop  sky130_fd_sc_hd__dfxtp_1  488.980  296.480  R0  PLACED  _33945_
i_lisa_qqspi.spi_buf[14]  flop  sky130_fd_sc_hd__dfxtp_1  505.540  288.320  MX  PLACED  _33946_
i_lisa_qqspi.spi_buf[15]  flop  sky130_fd_sc_hd__dfxtp_1  478.860  277.440  MX  PLACED  _33947_
i_lisa_qqspi.spi_buf[16]  flop  sky130_fd_sc_hd__dfxtp_1  480.240  364.480  MX  PLACED  _33948_
i_lisa_qqspi.spi_buf[17]  flop  sky130_fd_sc_hd__dfxtp_1  494.500  364.480  MX  PLACED  _33949_
i_lisa_qqspi.spi_buf[18]  flop  sky130_fd_sc_hd__dfxtp_1  491.740  372.640  R0  PLACED  _33950_
i_lisa_qqspi.spi_buf[19]  flop  sky130_fd_sc_hd__dfxtp_1  471.960  372.640  R0  PLACED  _33951_
i_lisa_qqspi.spi_buf[1]  flop  sky130_fd_sc_hd__dfxtp_1  477.940  266.560  MX  PLACED  _33957_
i_lisa_qqspi.spi_buf[20]  flop  sky130_fd_sc_hd__dfxtp_1  489.900  378.080  R0  PLACED  _33952_
i_lisa_qqspi.spi_buf[21]  flop  sky130_fd_sc_hd__dfxtp_1  502.320  369.920  MX  PLACED  _33953_
i_lisa_qqspi.spi_buf[22]  flop  sky130_fd_sc_hd__dfxtp_1  492.660  386.240  MX  PLACED  _33954_
i_lisa_qqspi.spi_buf[23]  flop  sky130_fd_sc_hd__dfxtp_1  480.240  380.800  MX  PLACED  _33955_
i_lisa_qqspi.spi_buf[2]  flop  sky130_fd_sc_hd__dfxtp_1  483.920  261.120  MX  PLACED  _33958_
i_lisa_qqspi.spi_buf[3]  flop  sky130_fd_sc_hd__dfxtp_1  511.060  258.400  R0  PLACED  _33959_
i_lisa_qqspi.spi_buf[4]  flop  sky130_fd_sc_hd__dfxtp_1  523.480  258.400  R0  PLACED  _33960_
i_lisa_qqspi.spi_buf[5]  flop  sky130_fd_sc_hd__dfxtp_1  520.720  250.240  MX  PLACED  _33961_
i_lisa_qqspi.spi_buf[6]  flop  sky130_fd_sc_hd__dfxtp_1  498.640  250.240  MX  PLACED  _33962_
i_lisa_qqspi.spi_buf[7]  flop  sky130_fd_sc_hd__dfxtp_1  509.220  250.240  MX  PLACED  _33963_
i_lisa_qqspi.spi_buf[8]  flop  sky130_fd_sc_hd__dfxtp_1  525.780  277.440  MX  PLACED  _33940_
i_lisa_qqspi.spi_buf[9]  flop  sky130_fd_sc_hd__dfxtp_1  523.020  272.000  MX  PLACED  _33941_
i_lisa_qqspi.state[0]  flop  sky130_fd_sc_hd__dfxtp_1  529.920  386.240  MX  PLACED  _34372_
i_lisa_qqspi.state[10]  flop  sky130_fd_sc_hd__dfxtp_1  536.360  397.120  MX  PLACED  _34382_
i_lisa_qqspi.state[1]  flop  sky130_fd_sc_hd__dfxtp_1  529.920  391.680  MX  PLACED  _34373_
i_lisa_qqspi.state[2]  flop  sky130_fd_sc_hd__dfxtp_1  510.600  375.360  MX  PLACED  _34374_
i_lisa_qqspi.state[3]  flop  sky130_fd_sc_hd__dfxtp_1  540.040  388.960  R0  PLACED  _34375_
i_lisa_qqspi.state[4]  flop  sky130_fd_sc_hd__dfxtp_1  523.480  399.840  R0  PLACED  _34376_
i_lisa_qqspi.state[5]  flop  sky130_fd_sc_hd__dfxtp_1  528.080  375.360  MX  PLACED  _34377_
i_lisa_qqspi.state[6]  flop  sky130_fd_sc_hd__dfxtp_1  545.100  397.120  MX  PLACED  _34378_
i_lisa_qqspi.state[7]  flop  sky130_fd_sc_hd__dfxtp_1  521.180  391.680  MX  PLACED  _34379_
i_lisa_qqspi.state[8]  flop  sky130_fd_sc_hd__dfxtp_1  523.020  380.800  MX  PLACED  _34380_
i_lisa_qqspi.state[9]  flop  sky130_fd_sc_hd__dfxtp_1  519.340  386.240  MX  PLACED  _34381_
i_lisa_qqspi.xfer_cycles[0]  flop  sky130_fd_sc_hd__dfxtp_1  477.480  397.120  MX  PLACED  _32644_
i_lisa_qqspi.xfer_cycles[1]  flop  sky130_fd_sc_hd__dfxtp_1  484.840  397.120  MX  PLACED  _32645_
i_lisa_qqspi.xfer_cycles[2]  flop  sky130_fd_sc_hd__dfxtp_1  516.120  399.840  R0  PLACED  _32641_
i_lisa_qqspi.xfer_cycles[3]  flop  sky130_fd_sc_hd__dfxtp_1  510.600  391.680  MX  PLACED  _32642_
i_lisa_qqspi.xfer_cycles[4]  flop  sky130_fd_sc_hd__dfxtp_1  505.540  399.840  R0  PLACED  _32643_
i_lisa_qqspi.xfer_done  flop  sky130_fd_sc_hd__dfxtp_1  545.100  372.640  R0  PLACED  _33930_
i_lisa_qspi_controller.active  flop  sky130_fd_sc_hd__dfxtp_1  552.000  250.240  MX  PLACED  _33984_
i_lisa_qspi_controller.arb[0]  flop  sky130_fd_sc_hd__dfxtp_1  559.820  242.080  R0  PLACED  _33980_
i_lisa_qspi_controller.arb[1]  flop  sky130_fd_sc_hd__dfxtp_1  570.860  242.080  R0  PLACED  _33981_
i_lisa_qspi_controller.arb_sel[0]  flop  sky130_fd_sc_hd__dfxtp_1  571.320  258.400  R0  PLACED  _33982_
i_lisa_qspi_controller.arb_sel[1]  flop  sky130_fd_sc_hd__dfxtp_1  563.960  258.400  R0  PLACED  _33983_
i_lisa_qspi_controller.valid_gate  flop  sky130_fd_sc_hd__dfxtp_1  547.860  252.960  R0  PLACED  _33985_
i_mc14500b.r_data  flop  sky130_fd_sc_hd__dfxtp_1  587.880  364.480  MX  PLACED  _33997_
i_mc14500b.r_ien  flop  sky130_fd_sc_hd__dfxtp_1  614.560  367.200  R0  PLACED  _33990_
i_mc14500b.r_inst[0]  flop  sky130_fd_sc_hd__dfxtp_1  595.700  348.160  MX  PLACED  _33993_
i_mc14500b.r_inst[1]  flop  sky130_fd_sc_hd__dfxtp_1  587.880  359.040  MX  PLACED  _33994_
i_mc14500b.r_inst[2]  flop  sky130_fd_sc_hd__dfxtp_1  588.800  361.760  R0  PLACED  _33995_
i_mc14500b.r_inst[3]  flop  sky130_fd_sc_hd__dfxtp_1  590.180  356.320  R0  PLACED  _33996_
i_mc14500b.r_oen  flop  sky130_fd_sc_hd__dfxtp_1  615.480  372.640  R0  PLACED  _33989_
i_mc14500b.r_run  flop  sky130_fd_sc_hd__dfxtp_1  592.480  340.000  R0  PLACED  _33991_
i_mc14500b.r_skip  flop  sky130_fd_sc_hd__dfxtp_1  609.500  359.040  MX  PLACED  _33987_
i_mc14500b.r_stall  flop  sky130_fd_sc_hd__dfxtp_1  612.720  348.160  MX  PLACED  _33992_
i_mc14500b.r_sto1  flop  sky130_fd_sc_hd__dfxtp_1  607.660  375.360  MX  PLACED  _33986_
i_shift_reg_io.after_state[0]  flop  sky130_fd_sc_hd__dfxtp_1  541.880  416.160  R0  PLACED  _34061_
i_shift_reg_io.after_state[1]  flop  sky130_fd_sc_hd__dfxtp_1  557.060  421.600  R0  PLACED  _34062_
i_shift_reg_io.clk_count[0]  flop  sky130_fd_sc_hd__dfxtp_1  572.240  405.280  R0  PLACED  _34051_
i_shift_reg_io.clk_count[1]  flop  sky130_fd_sc_hd__dfxtp_1  549.240  402.560  MX  PLACED  _34052_
i_shift_reg_io.clk_count[2]  flop  sky130_fd_sc_hd__dfxtp_1  562.120  397.120  MX  PLACED  _34053_
i_shift_reg_io.clk_count[3]  flop  sky130_fd_sc_hd__dfxtp_1  547.400  405.280  R0  PLACED  _34054_
i_shift_reg_io.input_buffer[0]  flop  sky130_fd_sc_hd__dfxtp_1  557.520  497.760  R0  PLACED  _34003_
i_shift_reg_io.input_buffer[10]  flop  sky130_fd_sc_hd__dfxtp_1  652.740  495.040  MX  PLACED  _34013_
i_shift_reg_io.input_buffer[11]  flop  sky130_fd_sc_hd__dfxtp_1  661.020  495.040  MX  PLACED  _34014_
i_shift_reg_io.input_buffer[12]  flop  sky130_fd_sc_hd__dfxtp_1  669.300  497.760  R0  PLACED  _34015_
i_shift_reg_io.input_buffer[13]  flop  sky130_fd_sc_hd__dfxtp_1  671.140  492.320  R0  PLACED  _34016_
i_shift_reg_io.input_buffer[14]  flop  sky130_fd_sc_hd__dfxtp_1  669.300  481.440  R0  PLACED  _34017_
i_shift_reg_io.input_buffer[15]  flop  sky130_fd_sc_hd__dfxtp_1  670.680  476.000  R0  PLACED  _34018_
i_shift_reg_io.input_buffer[16]  flop  sky130_fd_sc_hd__dfxtp_1  627.440  424.320  MX  PLACED  _34019_
i_shift_reg_io.input_buffer[17]  flop  sky130_fd_sc_hd__dfxtp_1  636.640  424.320  MX  PLACED  _34020_
i_shift_reg_io.input_buffer[18]  flop  sky130_fd_sc_hd__dfxtp_1  648.140  418.880  MX  PLACED  _34021_
i_shift_reg_io.input_buffer[19]  flop  sky130_fd_sc_hd__dfxtp_1  653.660  424.320  MX  PLACED  _34022_
i_shift_reg_io.input_buffer[1]  flop  sky130_fd_sc_hd__dfxtp_1  564.420  492.320  R0  PLACED  _34004_
i_shift_reg_io.input_buffer[20]  flop  sky130_fd_sc_hd__dfxtp_1  660.560  427.040  R0  PLACED  _34023_
i_shift_reg_io.input_buffer[21]  flop  sky130_fd_sc_hd__dfxtp_1  665.160  435.200  MX  PLACED  _34024_
i_shift_reg_io.input_buffer[22]  flop  sky130_fd_sc_hd__dfxtp_1  671.140  437.920  R0  PLACED  _34025_
i_shift_reg_io.input_buffer[23]  flop  sky130_fd_sc_hd__dfxtp_1  671.140  427.040  R0  PLACED  _34026_
i_shift_reg_io.input_buffer[24]  flop  sky130_fd_sc_hd__dfxtp_1  670.220  421.600  R0  PLACED  _34027_
i_shift_reg_io.input_buffer[25]  flop  sky130_fd_sc_hd__dfxtp_1  671.140  416.160  R0  PLACED  _34028_
i_shift_reg_io.input_buffer[26]  flop  sky130_fd_sc_hd__dfxtp_1  661.480  416.160  R0  PLACED  _34029_
i_shift_reg_io.input_buffer[27]  flop  sky130_fd_sc_hd__dfxtp_1  655.960  418.880  MX  PLACED  _34030_
i_shift_reg_io.input_buffer[28]  flop  sky130_fd_sc_hd__dfxtp_1  643.080  416.160  R0  PLACED  _34031_
i_shift_reg_io.input_buffer[29]  flop  sky130_fd_sc_hd__dfxtp_1  626.980  418.880  MX  PLACED  _34032_
i_shift_reg_io.input_buffer[2]  flop  sky130_fd_sc_hd__dfxtp_1  562.120  500.480  MX  PLACED  _34005_
i_shift_reg_io.input_buffer[30]  flop  sky130_fd_sc_hd__dfxtp_1  621.460  416.160  R0  PLACED  _34033_
i_shift_reg_io.input_buffer[31]  flop  sky130_fd_sc_hd__dfxtp_1  633.880  413.440  MX  PLACED  _34034_
i_shift_reg_io.input_buffer[32]  flop  sky130_fd_sc_hd__dfxtp_1  557.520  503.200  R0  PLACED  _34035_
i_shift_reg_io.input_buffer[33]  flop  sky130_fd_sc_hd__dfxtp_1  584.660  503.200  R0  PLACED  _34036_
i_shift_reg_io.input_buffer[34]  flop  sky130_fd_sc_hd__dfxtp_1  594.320  503.200  R0  PLACED  _34037_
i_shift_reg_io.input_buffer[35]  flop  sky130_fd_sc_hd__dfxtp_1  601.220  500.480  MX  PLACED  _34038_
i_shift_reg_io.input_buffer[36]  flop  sky130_fd_sc_hd__dfxtp_1  607.660  495.040  MX  PLACED  _34039_
i_shift_reg_io.input_buffer[37]  flop  sky130_fd_sc_hd__dfxtp_1  608.580  503.200  R0  PLACED  _34040_
i_shift_reg_io.input_buffer[38]  flop  sky130_fd_sc_hd__dfxtp_1  617.320  503.200  R0  PLACED  _34041_
i_shift_reg_io.input_buffer[39]  flop  sky130_fd_sc_hd__dfxtp_1  617.780  492.320  R0  PLACED  _34042_
i_shift_reg_io.input_buffer[3]  flop  sky130_fd_sc_hd__dfxtp_1  570.860  503.200  R0  PLACED  _34006_
i_shift_reg_io.input_buffer[40]  flop  sky130_fd_sc_hd__dfxtp_1  626.520  492.320  R0  PLACED  _34043_
i_shift_reg_io.input_buffer[41]  flop  sky130_fd_sc_hd__dfxtp_1  626.060  503.200  R0  PLACED  _34044_
i_shift_reg_io.input_buffer[42]  flop  sky130_fd_sc_hd__dfxtp_1  637.560  500.480  MX  PLACED  _34045_
i_shift_reg_io.input_buffer[43]  flop  sky130_fd_sc_hd__dfxtp_1  647.220  500.480  MX  PLACED  _34046_
i_shift_reg_io.input_buffer[44]  flop  sky130_fd_sc_hd__dfxtp_1  650.900  505.920  MX  PLACED  _34047_
i_shift_reg_io.input_buffer[45]  flop  sky130_fd_sc_hd__dfxtp_1  667.000  503.200  R0  PLACED  _34048_
i_shift_reg_io.input_buffer[46]  flop  sky130_fd_sc_hd__dfxtp_1  665.160  500.480  MX  PLACED  _34049_
i_shift_reg_io.input_buffer[47]  flop  sky130_fd_sc_hd__dfxtp_1  656.420  500.480  MX  PLACED  _34050_
i_shift_reg_io.input_buffer[4]  flop  sky130_fd_sc_hd__dfxtp_1  577.300  500.480  MX  PLACED  _34007_
i_shift_reg_io.input_buffer[5]  flop  sky130_fd_sc_hd__dfxtp_1  575.000  497.760  R0  PLACED  _34008_
i_shift_reg_io.input_buffer[6]  flop  sky130_fd_sc_hd__dfxtp_1  586.500  497.760  R0  PLACED  _34009_
i_shift_reg_io.input_buffer[7]  flop  sky130_fd_sc_hd__dfxtp_1  592.020  492.320  R0  PLACED  _34010_
i_shift_reg_io.input_buffer[8]  flop  sky130_fd_sc_hd__dfxtp_1  598.920  495.040  MX  PLACED  _34011_
i_shift_reg_io.input_buffer[9]  flop  sky130_fd_sc_hd__dfxtp_1  638.480  492.320  R0  PLACED  _34012_
i_shift_reg_io.io_busy  flop  sky130_fd_sc_hd__dfxtp_1  584.660  408.000  MX  PLACED  _34000_
i_shift_reg_io.last_clk  flop  sky130_fd_sc_hd__dfxtp_1  570.860  421.600  R0  PLACED  _32707_
i_shift_reg_io.output_buffer[0]  flop  sky130_fd_sc_hd__dfxtp_1  616.400  432.480  R0  PLACED  _34194_
i_shift_reg_io.output_buffer[10]  flop  sky130_fd_sc_hd__dfxtp_1  575.000  443.360  R0  PLACED  _34204_
i_shift_reg_io.output_buffer[11]  flop  sky130_fd_sc_hd__dfxtp_1  600.300  443.360  R0  PLACED  _34205_
i_shift_reg_io.output_buffer[12]  flop  sky130_fd_sc_hd__dfxtp_1  583.740  486.880  R0  PLACED  _34206_
i_shift_reg_io.output_buffer[13]  flop  sky130_fd_sc_hd__dfxtp_1  608.120  478.720  MX  PLACED  _34207_
i_shift_reg_io.output_buffer[14]  flop  sky130_fd_sc_hd__dfxtp_1  583.740  470.560  R0  PLACED  _34208_
i_shift_reg_io.output_buffer[15]  flop  sky130_fd_sc_hd__dfxtp_1  578.220  484.160  MX  PLACED  _34209_
i_shift_reg_io.output_buffer[16]  flop  sky130_fd_sc_hd__dfxtp_1  662.400  446.080  MX  PLACED  _34210_
i_shift_reg_io.output_buffer[17]  flop  sky130_fd_sc_hd__dfxtp_1  671.140  448.800  R0  PLACED  _34211_
i_shift_reg_io.output_buffer[18]  flop  sky130_fd_sc_hd__dfxtp_1  638.940  451.520  MX  PLACED  _34212_
i_shift_reg_io.output_buffer[19]  flop  sky130_fd_sc_hd__dfxtp_1  659.180  451.520  MX  PLACED  _34213_
i_shift_reg_io.output_buffer[1]  flop  sky130_fd_sc_hd__dfxtp_1  560.740  437.920  R0  PLACED  _34195_
i_shift_reg_io.output_buffer[20]  flop  sky130_fd_sc_hd__dfxtp_1  649.060  467.840  MX  PLACED  _34214_
i_shift_reg_io.output_buffer[21]  flop  sky130_fd_sc_hd__dfxtp_1  671.140  465.120  R0  PLACED  _34215_
i_shift_reg_io.output_buffer[22]  flop  sky130_fd_sc_hd__dfxtp_1  629.280  462.400  MX  PLACED  _34216_
i_shift_reg_io.output_buffer[23]  flop  sky130_fd_sc_hd__dfxtp_1  660.100  465.120  R0  PLACED  _34217_
i_shift_reg_io.output_buffer[24]  flop  sky130_fd_sc_hd__dfxtp_1  644.920  432.480  R0  PLACED  _34218_
i_shift_reg_io.output_buffer[25]  flop  sky130_fd_sc_hd__dfxtp_1  660.100  437.920  R0  PLACED  _34219_
i_shift_reg_io.output_buffer[26]  flop  sky130_fd_sc_hd__dfxtp_1  637.100  440.640  MX  PLACED  _34220_
i_shift_reg_io.output_buffer[27]  flop  sky130_fd_sc_hd__dfxtp_1  632.040  446.080  MX  PLACED  _34221_
i_shift_reg_io.output_buffer[28]  flop  sky130_fd_sc_hd__dfxtp_1  634.800  470.560  R0  PLACED  _34222_
i_shift_reg_io.output_buffer[29]  flop  sky130_fd_sc_hd__dfxtp_1  660.100  481.440  R0  PLACED  _34223_
i_shift_reg_io.output_buffer[2]  flop  sky130_fd_sc_hd__dfxtp_1  566.720  448.800  R0  PLACED  _34196_
i_shift_reg_io.output_buffer[30]  flop  sky130_fd_sc_hd__dfxtp_1  626.520  476.000  R0  PLACED  _34224_
i_shift_reg_io.output_buffer[31]  flop  sky130_fd_sc_hd__dfxtp_1  639.400  481.440  R0  PLACED  _34225_
i_shift_reg_io.output_buffer[32]  flop  sky130_fd_sc_hd__dfxtp_1  613.640  440.640  MX  PLACED  _34226_
i_shift_reg_io.output_buffer[33]  flop  sky130_fd_sc_hd__dfxtp_1  582.820  437.920  R0  PLACED  _34227_
i_shift_reg_io.output_buffer[34]  flop  sky130_fd_sc_hd__dfxtp_1  586.960  451.520  MX  PLACED  _34228_
i_shift_reg_io.output_buffer[35]  flop  sky130_fd_sc_hd__dfxtp_1  587.880  446.080  MX  PLACED  _34229_
i_shift_reg_io.output_buffer[36]  flop  sky130_fd_sc_hd__dfxtp_1  570.400  486.880  R0  PLACED  _34230_
i_shift_reg_io.output_buffer[37]  flop  sky130_fd_sc_hd__dfxtp_1  568.100  459.680  R0  PLACED  _34231_
i_shift_reg_io.output_buffer[38]  flop  sky130_fd_sc_hd__dfxtp_1  565.800  470.560  R0  PLACED  _34232_
i_shift_reg_io.output_buffer[39]  flop  sky130_fd_sc_hd__dfxtp_1  559.360  478.720  MX  PLACED  _34233_
i_shift_reg_io.output_buffer[3]  flop  sky130_fd_sc_hd__dfxtp_1  566.720  443.360  R0  PLACED  _34197_
i_shift_reg_io.output_buffer[40]  flop  sky130_fd_sc_hd__dfxtp_1  605.360  429.760  MX  PLACED  _34234_
i_shift_reg_io.output_buffer[41]  flop  sky130_fd_sc_hd__dfxtp_1  596.160  429.760  MX  PLACED  _34235_
i_shift_reg_io.output_buffer[42]  flop  sky130_fd_sc_hd__dfxtp_1  606.280  435.200  MX  PLACED  _34236_
i_shift_reg_io.output_buffer[43]  flop  sky130_fd_sc_hd__dfxtp_1  598.000  451.520  MX  PLACED  _34237_
i_shift_reg_io.output_buffer[44]  flop  sky130_fd_sc_hd__dfxtp_1  592.480  481.440  R0  PLACED  _34238_
i_shift_reg_io.output_buffer[45]  flop  sky130_fd_sc_hd__dfxtp_1  610.420  473.280  MX  PLACED  _34239_
i_shift_reg_io.output_buffer[46]  flop  sky130_fd_sc_hd__dfxtp_1  600.300  470.560  R0  PLACED  _34240_
i_shift_reg_io.output_buffer[47]  flop  sky130_fd_sc_hd__dfxtp_1  600.760  481.440  R0  PLACED  _34241_
i_shift_reg_io.output_buffer[4]  flop  sky130_fd_sc_hd__dfxtp_1  587.420  459.680  R0  PLACED  _34198_
i_shift_reg_io.output_buffer[5]  flop  sky130_fd_sc_hd__dfxtp_1  575.000  454.240  R0  PLACED  _34199_
i_shift_reg_io.output_buffer[6]  flop  sky130_fd_sc_hd__dfxtp_1  575.460  467.840  MX  PLACED  _34200_
i_shift_reg_io.output_buffer[7]  flop  sky130_fd_sc_hd__dfxtp_1  566.720  465.120  R0  PLACED  _34201_
i_shift_reg_io.output_buffer[8]  flop  sky130_fd_sc_hd__dfxtp_1  571.780  427.040  R0  PLACED  _34202_
i_shift_reg_io.output_buffer[9]  flop  sky130_fd_sc_hd__dfxtp_1  586.960  429.760  MX  PLACED  _34203_
i_shift_reg_io.shift_count[0]  flop  sky130_fd_sc_hd__dfxtp_1  594.320  416.160  R0  PLACED  _34055_
i_shift_reg_io.shift_count[1]  flop  sky130_fd_sc_hd__dfxtp_1  595.700  418.880  MX  PLACED  _34056_
i_shift_reg_io.shift_count[2]  flop  sky130_fd_sc_hd__dfxtp_1  591.100  421.600  R0  PLACED  _34057_
i_shift_reg_io.shift_count[3]  flop  sky130_fd_sc_hd__dfxtp_1  581.440  424.320  MX  PLACED  _34058_
i_shift_reg_io.state[0]  flop  sky130_fd_sc_hd__dfxtp_1  553.840  413.440  MX  PLACED  _34059_
i_shift_reg_io.state[1]  flop  sky130_fd_sc_hd__dfxtp_1  549.240  421.600  R0  PLACED  _34060_
i_ttlc_inst_cache.addr3_loaded  flop  sky130_fd_sc_hd__dfxtp_1  615.480  291.040  R0  PLACED  _34176_
i_ttlc_inst_cache.cache_valid_r  flop  sky130_fd_sc_hd__dfxtp_1  585.580  345.440  R0  PLACED  _34193_
i_ttlc_inst_cache.cl_addr0[0]  flop  sky130_fd_sc_hd__dfxtp_1  636.640  252.960  R0  PLACED  _34063_
i_ttlc_inst_cache.cl_addr0[10]  flop  sky130_fd_sc_hd__dfxtp_1  615.020  280.160  R0  PLACED  _34073_
i_ttlc_inst_cache.cl_addr0[11]  flop  sky130_fd_sc_hd__dfxtp_1  613.640  282.880  MX  PLACED  _34074_
i_ttlc_inst_cache.cl_addr0[1]  flop  sky130_fd_sc_hd__dfxtp_1  660.100  261.120  MX  PLACED  _34064_
i_ttlc_inst_cache.cl_addr0[2]  flop  sky130_fd_sc_hd__dfxtp_1  610.880  255.680  MX  PLACED  _34065_
i_ttlc_inst_cache.cl_addr0[3]  flop  sky130_fd_sc_hd__dfxtp_1  630.200  250.240  MX  PLACED  _34066_
i_ttlc_inst_cache.cl_addr0[4]  flop  sky130_fd_sc_hd__dfxtp_1  608.580  263.840  R0  PLACED  _34067_
i_ttlc_inst_cache.cl_addr0[5]  flop  sky130_fd_sc_hd__dfxtp_1  615.940  247.520  R0  PLACED  _34068_
i_ttlc_inst_cache.cl_addr0[6]  flop  sky130_fd_sc_hd__dfxtp_1  622.840  255.680  MX  PLACED  _34069_
i_ttlc_inst_cache.cl_addr0[7]  flop  sky130_fd_sc_hd__dfxtp_1  623.760  272.000  MX  PLACED  _34070_
i_ttlc_inst_cache.cl_addr0[8]  flop  sky130_fd_sc_hd__dfxtp_1  596.160  266.560  MX  PLACED  _34071_
i_ttlc_inst_cache.cl_addr0[9]  flop  sky130_fd_sc_hd__dfxtp_1  608.580  274.720  R0  PLACED  _34072_
i_ttlc_inst_cache.cl_addr1[0]  flop  sky130_fd_sc_hd__dfxtp_1  649.060  250.240  MX  PLACED  _34075_
i_ttlc_inst_cache.cl_addr1[10]  flop  sky130_fd_sc_hd__dfxtp_1  624.220  280.160  R0  PLACED  _34085_
i_ttlc_inst_cache.cl_addr1[11]  flop  sky130_fd_sc_hd__dfxtp_1  622.840  285.600  R0  PLACED  _34086_
i_ttlc_inst_cache.cl_addr1[1]  flop  sky130_fd_sc_hd__dfxtp_1  652.280  258.400  R0  PLACED  _34076_
i_ttlc_inst_cache.cl_addr1[2]  flop  sky130_fd_sc_hd__dfxtp_1  671.140  247.520  R0  PLACED  _34077_
i_ttlc_inst_cache.cl_addr1[3]  flop  sky130_fd_sc_hd__dfxtp_1  639.400  250.240  MX  PLACED  _34078_
i_ttlc_inst_cache.cl_addr1[4]  flop  sky130_fd_sc_hd__dfxtp_1  671.140  269.280  R0  PLACED  _34079_
i_ttlc_inst_cache.cl_addr1[5]  flop  sky130_fd_sc_hd__dfxtp_1  656.420  250.240  MX  PLACED  _34080_
i_ttlc_inst_cache.cl_addr1[6]  flop  sky130_fd_sc_hd__dfxtp_1  641.700  258.400  R0  PLACED  _34081_
i_ttlc_inst_cache.cl_addr1[7]  flop  sky130_fd_sc_hd__dfxtp_1  634.800  272.000  MX  PLACED  _34082_
i_ttlc_inst_cache.cl_addr1[8]  flop  sky130_fd_sc_hd__dfxtp_1  602.140  272.000  MX  PLACED  _34083_
i_ttlc_inst_cache.cl_addr1[9]  flop  sky130_fd_sc_hd__dfxtp_1  642.620  263.840  R0  PLACED  _34084_
i_ttlc_inst_cache.cl_addr2[0]  flop  sky130_fd_sc_hd__dfxtp_1  653.200  282.880  MX  PLACED  _34087_
i_ttlc_inst_cache.cl_addr2[10]  flop  sky130_fd_sc_hd__dfxtp_1  634.340  280.160  R0  PLACED  _34097_
i_ttlc_inst_cache.cl_addr2[11]  flop  sky130_fd_sc_hd__dfxtp_1  631.580  288.320  MX  PLACED  _34098_
i_ttlc_inst_cache.cl_addr2[1]  flop  sky130_fd_sc_hd__dfxtp_1  649.980  263.840  R0  PLACED  _34088_
i_ttlc_inst_cache.cl_addr2[2]  flop  sky130_fd_sc_hd__dfxtp_1  671.140  258.400  R0  PLACED  _34089_
i_ttlc_inst_cache.cl_addr2[3]  flop  sky130_fd_sc_hd__dfxtp_1  671.140  280.160  R0  PLACED  _34090_
i_ttlc_inst_cache.cl_addr2[4]  flop  sky130_fd_sc_hd__dfxtp_1  671.140  274.720  R0  PLACED  _34091_
i_ttlc_inst_cache.cl_addr2[5]  flop  sky130_fd_sc_hd__dfxtp_1  663.320  255.680  MX  PLACED  _34092_
i_ttlc_inst_cache.cl_addr2[6]  flop  sky130_fd_sc_hd__dfxtp_1  660.560  280.160  R0  PLACED  _34093_
i_ttlc_inst_cache.cl_addr2[7]  flop  sky130_fd_sc_hd__dfxtp_1  661.940  274.720  R0  PLACED  _34094_
i_ttlc_inst_cache.cl_addr2[8]  flop  sky130_fd_sc_hd__dfxtp_1  652.280  274.720  R0  PLACED  _34095_
i_ttlc_inst_cache.cl_addr2[9]  flop  sky130_fd_sc_hd__dfxtp_1  644.920  280.160  R0  PLACED  _34096_
i_ttlc_inst_cache.cl_addr3[0]  flop  sky130_fd_sc_hd__dfxtp_1  626.520  293.760  MX  PLACED  _34099_
i_ttlc_inst_cache.cl_addr3[10]  flop  sky130_fd_sc_hd__dfxtp_1  631.580  304.640  MX  PLACED  _34109_
i_ttlc_inst_cache.cl_addr3[11]  flop  sky130_fd_sc_hd__dfxtp_1  630.200  299.200  MX  PLACED  _34110_
i_ttlc_inst_cache.cl_addr3[1]  flop  sky130_fd_sc_hd__dfxtp_1  645.840  296.480  R0  PLACED  _34100_
i_ttlc_inst_cache.cl_addr3[2]  flop  sky130_fd_sc_hd__dfxtp_1  669.760  296.480  R0  PLACED  _34101_
i_ttlc_inst_cache.cl_addr3[3]  flop  sky130_fd_sc_hd__dfxtp_1  668.380  285.600  R0  PLACED  _34102_
i_ttlc_inst_cache.cl_addr3[4]  flop  sky130_fd_sc_hd__dfxtp_1  664.700  291.040  R0  PLACED  _34103_
i_ttlc_inst_cache.cl_addr3[5]  flop  sky130_fd_sc_hd__dfxtp_1  671.140  301.920  R0  PLACED  _34104_
i_ttlc_inst_cache.cl_addr3[6]  flop  sky130_fd_sc_hd__dfxtp_1  656.880  299.200  MX  PLACED  _34105_
i_ttlc_inst_cache.cl_addr3[7]  flop  sky130_fd_sc_hd__dfxtp_1  660.560  304.640  MX  PLACED  _34106_
i_ttlc_inst_cache.cl_addr3[8]  flop  sky130_fd_sc_hd__dfxtp_1  650.440  304.640  MX  PLACED  _34107_
i_ttlc_inst_cache.cl_addr3[9]  flop  sky130_fd_sc_hd__dfxtp_1  642.160  301.920  R0  PLACED  _34108_
i_ttlc_inst_cache.cl_inst0[0]  flop  sky130_fd_sc_hd__dfxtp_1  610.880  236.640  R0  PLACED  _34111_
i_ttlc_inst_cache.cl_inst0[10]  flop  sky130_fd_sc_hd__dfxtp_1  651.820  236.640  R0  PLACED  _34121_
i_ttlc_inst_cache.cl_inst0[11]  flop  sky130_fd_sc_hd__dfxtp_1  624.680  228.480  MX  PLACED  _34122_
i_ttlc_inst_cache.cl_inst0[12]  flop  sky130_fd_sc_hd__dfxtp_1  671.140  214.880  R0  PLACED  _34123_
i_ttlc_inst_cache.cl_inst0[13]  flop  sky130_fd_sc_hd__dfxtp_1  631.120  223.040  MX  PLACED  _34124_
i_ttlc_inst_cache.cl_inst0[14]  flop  sky130_fd_sc_hd__dfxtp_1  639.400  223.040  MX  PLACED  _34125_
i_ttlc_inst_cache.cl_inst0[15]  flop  sky130_fd_sc_hd__dfxtp_1  650.440  220.320  R0  PLACED  _34126_
i_ttlc_inst_cache.cl_inst0[1]  flop  sky130_fd_sc_hd__dfxtp_1  587.880  231.200  R0  PLACED  _34112_
i_ttlc_inst_cache.cl_inst0[2]  flop  sky130_fd_sc_hd__dfxtp_1  596.620  242.080  R0  PLACED  _34113_
i_ttlc_inst_cache.cl_inst0[3]  flop  sky130_fd_sc_hd__dfxtp_1  599.840  220.320  R0  PLACED  _34114_
i_ttlc_inst_cache.cl_inst0[4]  flop  sky130_fd_sc_hd__dfxtp_1  598.920  258.400  R0  PLACED  _34115_
i_ttlc_inst_cache.cl_inst0[5]  flop  sky130_fd_sc_hd__dfxtp_1  607.200  250.240  MX  PLACED  _34116_
i_ttlc_inst_cache.cl_inst0[6]  flop  sky130_fd_sc_hd__dfxtp_1  661.480  233.920  MX  PLACED  _34117_
i_ttlc_inst_cache.cl_inst0[7]  flop  sky130_fd_sc_hd__dfxtp_1  671.140  242.080  R0  PLACED  _34118_
i_ttlc_inst_cache.cl_inst0[8]  flop  sky130_fd_sc_hd__dfxtp_1  625.600  242.080  R0  PLACED  _34119_
i_ttlc_inst_cache.cl_inst0[9]  flop  sky130_fd_sc_hd__dfxtp_1  639.400  244.800  MX  PLACED  _34120_
i_ttlc_inst_cache.cl_inst1[0]  flop  sky130_fd_sc_hd__dfxtp_1  611.800  228.480  MX  PLACED  _34127_
i_ttlc_inst_cache.cl_inst1[10]  flop  sky130_fd_sc_hd__dfxtp_1  655.040  228.480  MX  PLACED  _34137_
i_ttlc_inst_cache.cl_inst1[11]  flop  sky130_fd_sc_hd__dfxtp_1  622.380  223.040  MX  PLACED  _34138_
i_ttlc_inst_cache.cl_inst1[12]  flop  sky130_fd_sc_hd__dfxtp_1  671.140  209.440  R0  PLACED  _34139_
i_ttlc_inst_cache.cl_inst1[13]  flop  sky130_fd_sc_hd__dfxtp_1  630.660  212.160  MX  PLACED  _34140_
i_ttlc_inst_cache.cl_inst1[14]  flop  sky130_fd_sc_hd__dfxtp_1  641.700  214.880  R0  PLACED  _34141_
i_ttlc_inst_cache.cl_inst1[15]  flop  sky130_fd_sc_hd__dfxtp_1  660.100  214.880  R0  PLACED  _34142_
i_ttlc_inst_cache.cl_inst1[1]  flop  sky130_fd_sc_hd__dfxtp_1  592.480  225.760  R0  PLACED  _34128_
i_ttlc_inst_cache.cl_inst1[2]  flop  sky130_fd_sc_hd__dfxtp_1  598.920  233.920  MX  PLACED  _34129_
i_ttlc_inst_cache.cl_inst1[3]  flop  sky130_fd_sc_hd__dfxtp_1  603.980  212.160  MX  PLACED  _34130_
i_ttlc_inst_cache.cl_inst1[4]  flop  sky130_fd_sc_hd__dfxtp_1  588.340  258.400  R0  PLACED  _34131_
i_ttlc_inst_cache.cl_inst1[5]  flop  sky130_fd_sc_hd__dfxtp_1  598.460  250.240  MX  PLACED  _34132_
i_ttlc_inst_cache.cl_inst1[6]  flop  sky130_fd_sc_hd__dfxtp_1  671.140  231.200  R0  PLACED  _34133_
i_ttlc_inst_cache.cl_inst1[7]  flop  sky130_fd_sc_hd__dfxtp_1  671.140  236.640  R0  PLACED  _34134_
i_ttlc_inst_cache.cl_inst1[8]  flop  sky130_fd_sc_hd__dfxtp_1  616.400  242.080  R0  PLACED  _34135_
i_ttlc_inst_cache.cl_inst1[9]  flop  sky130_fd_sc_hd__dfxtp_1  641.240  236.640  R0  PLACED  _34136_
i_ttlc_inst_cache.cl_inst2[0]  flop  sky130_fd_sc_hd__dfxtp_1  603.980  223.040  MX  PLACED  _34143_
i_ttlc_inst_cache.cl_inst2[10]  flop  sky130_fd_sc_hd__dfxtp_1  647.220  228.480  MX  PLACED  _34153_
i_ttlc_inst_cache.cl_inst2[11]  flop  sky130_fd_sc_hd__dfxtp_1  617.320  214.880  R0  PLACED  _34154_
i_ttlc_inst_cache.cl_inst2[12]  flop  sky130_fd_sc_hd__dfxtp_1  670.680  204.000  R0  PLACED  _34155_
i_ttlc_inst_cache.cl_inst2[13]  flop  sky130_fd_sc_hd__dfxtp_1  621.920  212.160  MX  PLACED  _34156_
i_ttlc_inst_cache.cl_inst2[14]  flop  sky130_fd_sc_hd__dfxtp_1  638.940  206.720  MX  PLACED  _34157_
i_ttlc_inst_cache.cl_inst2[15]  flop  sky130_fd_sc_hd__dfxtp_1  655.500  206.720  MX  PLACED  _34158_
i_ttlc_inst_cache.cl_inst2[1]  flop  sky130_fd_sc_hd__dfxtp_1  587.880  220.320  R0  PLACED  _34144_
i_ttlc_inst_cache.cl_inst2[2]  flop  sky130_fd_sc_hd__dfxtp_1  587.880  236.640  R0  PLACED  _34145_
i_ttlc_inst_cache.cl_inst2[3]  flop  sky130_fd_sc_hd__dfxtp_1  596.160  212.160  MX  PLACED  _34146_
i_ttlc_inst_cache.cl_inst2[4]  flop  sky130_fd_sc_hd__dfxtp_1  587.880  252.960  R0  PLACED  _34147_
i_ttlc_inst_cache.cl_inst2[5]  flop  sky130_fd_sc_hd__dfxtp_1  587.880  244.800  MX  PLACED  _34148_
i_ttlc_inst_cache.cl_inst2[6]  flop  sky130_fd_sc_hd__dfxtp_1  670.680  225.760  R0  PLACED  _34149_
i_ttlc_inst_cache.cl_inst2[7]  flop  sky130_fd_sc_hd__dfxtp_1  662.400  242.080  R0  PLACED  _34150_
i_ttlc_inst_cache.cl_inst2[8]  flop  sky130_fd_sc_hd__dfxtp_1  608.580  242.080  R0  PLACED  _34151_
i_ttlc_inst_cache.cl_inst2[9]  flop  sky130_fd_sc_hd__dfxtp_1  631.580  233.920  MX  PLACED  _34152_
i_ttlc_inst_cache.cl_inst3[0]  flop  sky130_fd_sc_hd__dfxtp_1  579.140  228.480  MX  PLACED  _34159_
i_ttlc_inst_cache.cl_inst3[10]  flop  sky130_fd_sc_hd__dfxtp_1  641.700  231.200  R0  PLACED  _34169_
i_ttlc_inst_cache.cl_inst3[11]  flop  sky130_fd_sc_hd__dfxtp_1  610.420  220.320  R0  PLACED  _34170_
i_ttlc_inst_cache.cl_inst3[12]  flop  sky130_fd_sc_hd__dfxtp_1  663.320  206.720  MX  PLACED  _34171_
i_ttlc_inst_cache.cl_inst3[13]  flop  sky130_fd_sc_hd__dfxtp_1  613.640  212.160  MX  PLACED  _34172_
i_ttlc_inst_cache.cl_inst3[14]  flop  sky130_fd_sc_hd__dfxtp_1  630.200  206.720  MX  PLACED  _34173_
i_ttlc_inst_cache.cl_inst3[15]  flop  sky130_fd_sc_hd__dfxtp_1  647.680  206.720  MX  PLACED  _34174_
i_ttlc_inst_cache.cl_inst3[1]  flop  sky130_fd_sc_hd__dfxtp_1  579.600  223.040  MX  PLACED  _34160_
i_ttlc_inst_cache.cl_inst3[2]  flop  sky130_fd_sc_hd__dfxtp_1  579.600  233.920  MX  PLACED  _34161_
i_ttlc_inst_cache.cl_inst3[3]  flop  sky130_fd_sc_hd__dfxtp_1  588.340  214.880  R0  PLACED  _34162_
i_ttlc_inst_cache.cl_inst3[4]  flop  sky130_fd_sc_hd__dfxtp_1  579.600  250.240  MX  PLACED  _34163_
i_ttlc_inst_cache.cl_inst3[5]  flop  sky130_fd_sc_hd__dfxtp_1  582.820  247.520  R0  PLACED  _34164_
i_ttlc_inst_cache.cl_inst3[6]  flop  sky130_fd_sc_hd__dfxtp_1  660.100  225.760  R0  PLACED  _34165_
i_ttlc_inst_cache.cl_inst3[7]  flop  sky130_fd_sc_hd__dfxtp_1  653.200  244.800  MX  PLACED  _34166_
i_ttlc_inst_cache.cl_inst3[8]  flop  sky130_fd_sc_hd__dfxtp_1  582.820  242.080  R0  PLACED  _34167_
i_ttlc_inst_cache.cl_inst3[9]  flop  sky130_fd_sc_hd__dfxtp_1  621.000  236.640  R0  PLACED  _34168_
i_ttlc_inst_cache.cl_set_valid  flop  sky130_fd_sc_hd__dfxtp_1  577.300  272.000  MX  PLACED  _34371_
i_ttlc_inst_cache.cl_valid  flop  sky130_fd_sc_hd__dfxtp_1  586.040  272.000  MX  PLACED  _34175_
i_ttlc_inst_cache.state[0]  flop  sky130_fd_sc_hd__dfxtp_1  587.880  266.560  MX  PLACED  _34368_
i_ttlc_inst_cache.state[1]  flop  sky130_fd_sc_hd__dfxtp_1  578.220  255.680  MX  PLACED  _34369_
i_ttlc_inst_cache.state[2]  flop  sky130_fd_sc_hd__dfxtp_1  575.920  266.560  MX  PLACED  _34370_
i_ttlc_inst_cache.ttlc_inst[0]  flop  sky130_fd_sc_hd__dfxtp_1  607.200  331.840  MX  PLACED  _34177_
i_ttlc_inst_cache.ttlc_inst[10]  flop  sky130_fd_sc_hd__dfxtp_1  648.600  242.080  R0  PLACED  _34187_
i_ttlc_inst_cache.ttlc_inst[11]  flop  sky130_fd_sc_hd__dfxtp_1  622.380  233.920  MX  PLACED  _34188_
i_ttlc_inst_cache.ttlc_inst[12]  flop  sky130_fd_sc_hd__dfxtp_1  660.560  220.320  R0  PLACED  _34189_
i_ttlc_inst_cache.ttlc_inst[13]  flop  sky130_fd_sc_hd__dfxtp_1  634.340  225.760  R0  PLACED  _34190_
i_ttlc_inst_cache.ttlc_inst[14]  flop  sky130_fd_sc_hd__dfxtp_1  634.340  231.200  R0  PLACED  _34191_
i_ttlc_inst_cache.ttlc_inst[15]  flop  sky130_fd_sc_hd__dfxtp_1  649.520  223.040  MX  PLACED  _34192_
i_ttlc_inst_cache.ttlc_inst[1]  flop  sky130_fd_sc_hd__dfxtp_1  599.840  340.000  R0  PLACED  _34178_
i_ttlc_inst_cache.ttlc_inst[2]  flop  sky130_fd_sc_hd__dfxtp_1  598.920  334.560  R0  PLACED  _34179_
i_ttlc_inst_cache.ttlc_inst[3]  flop  sky130_fd_sc_hd__dfxtp_1  599.840  331.840  MX  PLACED  _34180_
i_ttlc_inst_cache.ttlc_inst[4]  flop  sky130_fd_sc_hd__dfxtp_1  598.920  337.280  MX  PLACED  _34181_
i_ttlc_inst_cache.ttlc_inst[5]  flop  sky130_fd_sc_hd__dfxtp_1  608.580  258.400  R0  PLACED  _34182_
i_ttlc_inst_cache.ttlc_inst[6]  flop  sky130_fd_sc_hd__dfxtp_1  663.320  236.640  R0  PLACED  _34183_
i_ttlc_inst_cache.ttlc_inst[7]  flop  sky130_fd_sc_hd__dfxtp_1  664.240  250.240  MX  PLACED  _34184_
i_ttlc_inst_cache.ttlc_inst[8]  flop  sky130_fd_sc_hd__dfxtp_1  625.140  247.520  R0  PLACED  _34185_
i_ttlc_inst_cache.ttlc_inst[9]  flop  sky130_fd_sc_hd__dfxtp_1  634.340  247.520  R0  PLACED  _34186_
i_ttlc_io.read_values[105]  flop  sky130_fd_sc_hd__dfxtp_1  597.540  456.960  MX  PLACED  _34251_
i_ttlc_io.read_values[106]  flop  sky130_fd_sc_hd__dfxtp_1  608.120  456.960  MX  PLACED  _34252_
i_ttlc_io.read_values[107]  flop  sky130_fd_sc_hd__dfxtp_1  617.780  454.240  R0  PLACED  _34253_
i_ttlc_io.read_values[108]  flop  sky130_fd_sc_hd__dfxtp_1  597.540  489.600  MX  PLACED  _34254_
i_ttlc_io.read_values[109]  flop  sky130_fd_sc_hd__dfxtp_1  613.640  484.160  MX  PLACED  _34255_
i_ttlc_io.read_values[110]  flop  sky130_fd_sc_hd__dfxtp_1  621.460  489.600  MX  PLACED  _34256_
i_ttlc_io.read_values[111]  flop  sky130_fd_sc_hd__dfxtp_1  606.280  489.600  MX  PLACED  _34257_
i_ttlc_io.read_values[112]  flop  sky130_fd_sc_hd__dfxtp_1  669.760  443.360  R0  PLACED  _34258_
i_ttlc_io.read_values[113]  flop  sky130_fd_sc_hd__dfxtp_1  671.140  454.240  R0  PLACED  _34259_
i_ttlc_io.read_values[114]  flop  sky130_fd_sc_hd__dfxtp_1  643.540  454.240  R0  PLACED  _34260_
i_ttlc_io.read_values[115]  flop  sky130_fd_sc_hd__dfxtp_1  656.880  456.960  MX  PLACED  _34261_
i_ttlc_io.read_values[116]  flop  sky130_fd_sc_hd__dfxtp_1  661.480  478.720  MX  PLACED  _34262_
i_ttlc_io.read_values[117]  flop  sky130_fd_sc_hd__dfxtp_1  671.140  470.560  R0  PLACED  _34263_
i_ttlc_io.read_values[118]  flop  sky130_fd_sc_hd__dfxtp_1  624.680  470.560  R0  PLACED  _34264_
i_ttlc_io.read_values[119]  flop  sky130_fd_sc_hd__dfxtp_1  662.400  473.280  MX  PLACED  _34265_
i_ttlc_io.read_values[120]  flop  sky130_fd_sc_hd__dfxtp_1  626.520  432.480  R0  PLACED  _34266_
i_ttlc_io.read_values[121]  flop  sky130_fd_sc_hd__dfxtp_1  652.280  432.480  R0  PLACED  _34267_
i_ttlc_io.read_values[122]  flop  sky130_fd_sc_hd__dfxtp_1  634.340  432.480  R0  PLACED  _34268_
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
ttlc_base_addr[11]  latch  sky130_fd_sc_hd__dlrtp_1  545.100  356.320  R0  PLACED  i_debug_regs.BASE_BITS\[11\].ttlc_base_latch
ttlc_base_addr[12]  latch  sky130_fd_sc_hd__dlrtp_1  578.680  359.040  MX  PLACED  i_debug_regs.BASE_BITS\[12\].ttlc_base_latch
ttlc_base_addr[13]  latch  sky130_fd_sc_hd__dlrtp_1  416.760  353.600  MX  PLACED  i_debug_regs.BASE_BITS\[13\].ttlc_base_latch
ttlc_base_addr[14]  latch  sky130_fd_sc_hd__dlrtp_1  418.140  340.000  R0  PLACED  i_debug_regs.BASE_BITS\[14\].ttlc_base_latch
ttlc_base_addr[15]  latch  sky130_fd_sc_hd__dlrtp_1  421.360  361.760  R0  PLACED  i_debug_regs.BASE_BITS\[15\].ttlc_base_latch
ttlc_base_addr[1]  latch  sky130_fd_sc_hd__dlrtp_1  550.620  345.440  R0  PLACED  i_debug_regs.BASE_BITS\[1\].ttlc_base_latch
ttlc_base_addr[2]  latch  sky130_fd_sc_hd__dlrtp_1  558.900  337.280  MX  PLACED  i_debug_regs.BASE_BITS\[2\].ttlc_base_latch
ttlc_base_addr[3]  latch  sky130_fd_sc_hd__dlrtp_1  460.000  331.840  MX  PLACED  i_debug_regs.BASE_BITS\[3\].ttlc_base_latch
ttlc_base_addr[4]  latch  sky130_fd_sc_hd__dlrtp_1  547.400  359.040  MX  PLACED  i_debug_regs.BASE_BITS\[4\].ttlc_base_latch
ttlc_base_addr[5]  latch  sky130_fd_sc_hd__dlrtp_1  582.820  334.560  R0  PLACED  i_debug_regs.BASE_BITS\[5\].ttlc_base_latch
ttlc_base_addr[6]  latch  sky130_fd_sc_hd__dlrtp_1  524.860  361.760  R0  PLACED  i_debug_regs.BASE_BITS\[6\].ttlc_base_latch
ttlc_base_addr[7]  latch  sky130_fd_sc_hd__dlrtp_1  455.400  348.160  MX  PLACED  i_debug_regs.BASE_BITS\[7\].ttlc_base_latch
ttlc_base_addr[8]  latch  sky130_fd_sc_hd__dlrtp_1  442.060  356.320  R0  PLACED  i_debug_regs.BASE_BITS\[8\].ttlc_base_latch
ttlc_base_addr[9]  latch  sky130_fd_sc_hd__dlrtp_1  454.020  361.760  R0  PLACED  i_debug_regs.BASE_BITS\[9\].ttlc_base_latch
_00003_  flop  sky130_fd_sc_hd__dfxtp_1  63.020  402.560  MX  PLACED  _32607_
_00004_  flop  sky130_fd_sc_hd__dfxtp_1  64.400  413.440  MX  PLACED  _32608_
_00005_  flop  sky130_fd_sc_hd__dfxtp_2  46.920  410.720  R0  PLACED  _32609_
_00006_  flop  sky130_fd_sc_hd__dfxtp_1  192.280  456.960  MX  PLACED  _32604_
_00007_  flop  sky130_fd_sc_hd__dfxtp_1  192.280  451.520  MX  PLACED  _32605_
_00008_  flop  sky130_fd_sc_hd__dfxtp_1  183.540  446.080  MX  PLACED  _32606_
_00089_  flop  sky130_fd_sc_hd__dfxtp_1  82.340  133.280  R0  PLACED  _32472_
_00090_  flop  sky130_fd_sc_hd__dfxtp_1  73.140  122.400  R0  PLACED  _32473_
_00091_  flop  sky130_fd_sc_hd__dfxtp_1  76.360  127.840  R0  PLACED  _32474_
_00092_  flop  sky130_fd_sc_hd__dfxtp_1  81.420  130.560  MX  PLACED  _32475_
