kdp1965/ttsky26c-um-lisa-ttlc/src/lisa_dbg.v

/*
==============================================================================
lisa_dbg.v:  Little ISA (LISA) 8-bit processor debugger.

Copyright 2024 by Ken Pettit <pettitkd@gmail.com>

Redistribution and use in source and binary forms, with or without
modification, are permitted provided that the following conditions
are met:
1. Redistributions of source code must retain the above copyright
   notice, this list of conditions and the following disclaimer.
2. Redistributions in binary form must reproduce the above copyright
   notice, this list of conditions and the following disclaimer in the
   documentation and/or other materials provided with the distribution.

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
==============================================================================
*/

/*
==========================================================================================
Debug module:

   Debug Addresses
      0:    Control / Status
               { 8'h0, D_BITS[4:0], PC_BITS[3:0], 5'h0, single_step, resume, halt }
      1:    Acc / flags
               { 4'h0,  cond_code[1:0], cflag, zflag, acc }
      2:    PC
      3:    SP
      4:    RA
      5:    IX
      6:    Data bus
      7:    Data Bus Address
      8:    Breakpoint 0
               [ en0, bkpt0 }
      9:    Breakpoint 0
               [ en1, bkpt1 }
      f:    Current instruction word
      etc.

==========================================================================================
*/
`define SIX_BREAK

module lisa_dbg
#(
      parameter PC_BITS        = 12,
      parameter D_BITS         = 9,
      parameter DBG_BRKPOINTS  = 6
)
(
`ifdef USE_POWER_PINS
    input                  VPWR,
    input                  VGND,
`endif
   input                      clk,
   input                      rst_n,

   // Processor signals
   input  wire [15:0]         inst,
   input  wire [PC_BITS-1:0]  pc,
   input  wire [7:0]          acc,
   input  wire [D_BITS-1:0]   sp,
   input  wire [PC_BITS-1:0]  ix,
   input  wire [PC_BITS-1:0]  ra,
   input  wire [1:0]          cond,
   input  wire                zflag,
   input  wire                cflag,
   input  wire [2:0]          amode,
   input  wire                fetch,       // the core's fetch state: an instruction retired when it comes back
   input  wire                brk_inst,    // a brk being decoded

   input  wire [15:0]         f0,
   input  wire [15:0]         f1,
   input  wire [15:0]         f2,
   input  wire [15:0]         f3,
   input  wire [15:0]         facc,

   // Signal to processor to stop execution
   output wire                stop,
   output wire                cont_q,

   // Data bus signals
   output wire [D_BITS-1:0]   d_addr,
   output wire [7:0]          d_o,
   output wire                d_access,
   input  wire [7:0]          d_i,
   output wire                d_periph,
   output reg                 d_rd,

   // The debug control bus
   input  wire [7:0]          dbg_a,
   input  wire [15:0]         dbg_di,
   output reg  [15:0]         dbg_do,
   input  wire                dbg_we,
   input  wire                dbg_rd,
   output wire                dbg_ready,
   output wire                dbg_halted
);

   reg               halted;
   wire              cont;
   reg               cont_q_r;
   reg               step_r;      // a single step: stop lifted until the instruction retires
   reg               skip_r;      // a resume: the breakpoint at this PC ignored until it retires
   reg               fetch_r;
   wire [PC_BITS:0]  brk_r[DBG_BRKPOINTS-1:0];
   wire [PC_BITS:0]  brk_r0;
   wire [PC_BITS:0]  brk_r1;
   wire [PC_BITS:0]  brk_r2;
   wire [PC_BITS:0]  brk_r3;
   wire [PC_BITS:0]  brk_r4;
`ifdef SIX_BREAK
   wire [PC_BITS:0]  brk_r5;
`endif
   reg               brk_halt;
   reg               d_access_r;
   reg               d_active_r;
   reg  [1:0]        access_state;
   reg  [D_BITS:0]   d_addr_r;
   reg  [1:0]        delay;
   wire [3:0]        d_bits;
   wire [3:0]        pc_bits;
   wire              d_active;
	integer				i;
   wire              dbg_addr_08;
   wire              dbg_addr_09;
   wire              dbg_addr_0a;
   wire              dbg_addr_0b;
   wire              dbg_addr_0c;
`ifdef SIX_BREAK
   wire              dbg_addr_0d;
`endif
   (* keep = "true" *)
   wire              dbg_we_08;
   (* keep = "true" *)
   wire              dbg_we_09;
   (* keep = "true" *)
   wire              dbg_we_0a;
   (* keep = "true" *)
   wire              dbg_we_0b;
   (* keep = "true" *)
   wire              dbg_we_0c;
`ifdef SIX_BREAK
   (* keep = "true" *)
   wire              dbg_we_0d;
`endif

   assign d_o      = dbg_di[7:0];
   assign d_access = (dbg_we | dbg_rd) && dbg_a == 8'h6 && halted;
   assign d_active = (dbg_we | dbg_rd) && dbg_a[7:4] == 4'h0;
   assign dbg_halted = halted;
   assign dbg_ready = (d_active & !d_active_r) ? 1'b0 : d_access ? ((delay == 2'h0) | d_periph) : d_active;

   always @(posedge clk)
   begin
      if (~rst_n)
      begin
         halted <= 1'b1;
         cont_q_r <= 1'b0;
         step_r <= 1'b0;
         skip_r <= 1'b0;
         fetch_r <= 1'b1;
         delay  <= 2'h0;
         d_addr_r <= {(D_BITS+1){1'b0}};
         access_state <= 2'h0;
         d_access_r <= 1'b0;
         d_active_r <= 1'b0;
//         brk_r0 <= 16'h0;
//         brk_r1 <= 16'h0;
//         brk_r2 <= 16'h0;
//         brk_r3 <= 16'h0;
`ifdef SIX_BREAK
//         brk_r4 <= 16'h0;
//         brk_r5 <= 16'h0;
`endif
         //d_we   <= 1'b0;
         d_rd   <= 1'b0;
      end
      else
      begin
         fetch_r <= fetch;

         // Status register write: bit 0 halt, bit 1 resume, bit 2 step
         if (dbg_we && dbg_a == 8'h0)
         begin
            // Write to halt register
            halted <= dbg_di[0];

            // a resume runs the instruction at the PC even with a breakpoint
            // on it; a step runs exactly one instruction and halts again
            // (TT07's step lifted stop for one clock, which executed nothing)
            if (dbg_di[1])
               skip_r <= 1'b1;
            if (dbg_di[2])
               step_r <= 1'b1;

            // Test for resume or single_step
            if ((dbg_di[1] || dbg_di[2]) && cont)
               cont_q_r <= 1'b1;
         end
         else
         begin
            // Test for end of write cycle to drive cont_q low
            if (dbg_we == 1'b0)
               cont_q_r <= 1'b0;

            // the instruction retired: back in the fetch state
            if (fetch && !fetch_r)
            begin
               if (step_r)
                  halted <= 1'b1;
               step_r <= 1'b0;
               skip_r <= 1'b0;
            end

            // Test for halt from breakpoint, or a brk instruction
            if ((brk_halt && !skip_r && !step_r) || (brk_inst && !cont_q))
               halted <= 1'b1;
         end

         d_access_r <= d_access;
         d_active_r <= d_active;

`ifdef DONT_COMPILE
         // Breakpoint register write
         if (dbg_we & dbg_a[3])
         begin
            if (dbg_a[2:0] == 3'h0)
               brk_r0 <= dbg_di[PC_BITS:0];
            if (dbg_a[2:0] == 3'h1)
               brk_r1 <= dbg_di[PC_BITS:0];
            if (dbg_a[2:0] == 3'h2)
               brk_r2 <= dbg_di[PC_BITS:0];
            if (dbg_a[2:0] == 3'h3)
               brk_r3 <= dbg_di[PC_BITS:0];
`ifdef SIX_BREAK
            if (dbg_a[2:0] == 3'h4)
               brk_r4 <= dbg_di[PC_BITS:0];
            if (dbg_a[2:0] == 3'h5)
               brk_r5 <= dbg_di[PC_BITS:0];
`endif
         end
`endif

         // Data bus register write
         if (dbg_we & dbg_a == 8'h7)
            d_addr_r <= dbg_di[D_BITS:0];

         // Increment data bus access address at the end of the cycle
         else if (d_access_r && !d_access)
            d_addr_r <= d_addr_r + 1;

         if (d_access || (access_state != 2'h0))
            case (access_state)
            2'h0:
            begin
               access_state <= 2'h1;
               delay        <= 2'h3;
            end

            2'h1:
            begin
               if (dbg_rd)
                  d_rd <= 1'b1;
               access_state <= 2'h2;
            end

            2'h2:
            begin
               access_state <= 2'h3;
            end

            2'h3:
            begin
               if (delay != 2'h0)
                  delay <= delay - 1;
               if (dbg_rd == 0 && dbg_we == 0)
               begin
                  d_rd <= 1'b0;
                  access_state <= 2'h0;
               end
            end
            endcase
      end
   end

   assign dbg_addr_08 = dbg_a == 8'h08;
   assign dbg_addr_09 = dbg_a == 8'h09;
   assign dbg_addr_0a = dbg_a == 8'h0a;
   assign dbg_addr_0b = dbg_a == 8'h0b;
   assign dbg_addr_0c = dbg_a == 8'h0c;
`ifdef SIX_BREAK
   assign dbg_addr_0d = dbg_a == 8'h0d;
`endif

   sky130_fd_sc_hd__and2_4 and_08(
      `ifdef USE_POWER_PINS
            .VPWR(VPWR),
            .VGND(VGND),
            .VPB(VPWR),
            .VNB(VGND),
      `endif
         .A(dbg_addr_08), .B(dbg_we), .X(dbg_we_08) );
   sky130_fd_sc_hd__and2_4 and_09(
      `ifdef USE_POWER_PINS
            .VPWR(VPWR),
            .VGND(VGND),
            .VPB(VPWR),
            .VNB(VGND),
      `endif
         .A(dbg_addr_09), .B(dbg_we), .X(dbg_we_09) );
   sky130_fd_sc_hd__and2_4 and_0a(
      `ifdef USE_POWER_PINS
            .VPWR(VPWR),
            .VGND(VGND),
            .VPB(VPWR),
            .VNB(VGND),
      `endif
         .A(dbg_addr_0a), .B(dbg_we), .X(dbg_we_0a) );
   sky130_fd_sc_hd__and2_4 and_0b(
      `ifdef USE_POWER_PINS
            .VPWR(VPWR),
            .VGND(VGND),
            .VPB(VPWR),
            .VNB(VGND),
      `endif
         .A(dbg_addr_0b), .B(dbg_we), .X(dbg_we_0b) );
   sky130_fd_sc_hd__and2_4 and_0c(
      `ifdef USE_POWER_PINS
            .VPWR(VPWR),
            .VGND(VGND),
            .VPB(VPWR),
            .VNB(VGND),
      `endif
         .A(dbg_addr_0c), .B(dbg_we), .X(dbg_we_0c) );
`ifdef SIX_BREAK
   sky130_fd_sc_hd__and2_4 and_0d(
      `ifdef USE_POWER_PINS
            .VPWR(VPWR),
            .VGND(VGND),
            .VPB(VPWR),
            .VNB(VGND),
      `endif
         .A(dbg_addr_0d), .B(dbg_we), .X(dbg_we_0d) );
`endif

   generate
   genvar b;
      for (b = 0; b < 16; b = b + 1)
      begin : LISA_BRK_BITS
         sky130_fd_sc_hd__dlrtp_1   brk_r0_latch
         (
      `ifdef USE_POWER_PINS
            .VPWR(VPWR),
            .VGND(VGND),
            .VPB(VPWR),
            .VNB(VGND),
      `endif
            .RESET_B    ( rst_n              ),
            .GATE       ( dbg_we_08          ),
            .D          ( dbg_di[b]          ),
            .Q          ( brk_r0[b]          )
         );
         sky130_fd_sc_hd__dlrtp_1   brk_r1_latch
         (
      `ifdef USE_POWER_PINS
            .VPWR(VPWR),
            .VGND(VGND),
            .VPB(VPWR),
            .VNB(VGND),
      `endif
            .RESET_B    ( rst_n              ),
            .GATE       ( dbg_we_09          ),
            .D          ( dbg_di[b]          ),
            .Q          ( brk_r1[b]          )
         );
         sky130_fd_sc_hd__dlrtp_1   brk_r2_latch
         (
      `ifdef USE_POWER_PINS
            .VPWR(VPWR),
            .VGND(VGND),
            .VPB(VPWR),
            .VNB(VGND),
      `endif
            .RESET_B    ( rst_n              ),
            .GATE       ( dbg_we_0a          ),
            .D          ( dbg_di[b]          ),
            .Q          ( brk_r2[b]          )
         );
         sky130_fd_sc_hd__dlrtp_1   brk_r3_latch
         (
      `ifdef USE_POWER_PINS
            .VPWR(VPWR),
            .VGND(VGND),
            .VPB(VPWR),
            .VNB(VGND),
      `endif
            .RESET_B    ( rst_n              ),
            .GATE       ( dbg_we_0b          ),
            .D          ( dbg_di[b]          ),
            .Q          ( brk_r3[b]          )
         );
         sky130_fd_sc_hd__dlrtp_1   brk_r4_latch
         (
      `ifdef USE_POWER_PINS
            .VPWR(VPWR),
            .VGND(VGND),
            .VPB(VPWR),
            .VNB(VGND),
      `endif
            .RESET_B    ( rst_n              ),
            .GATE       ( dbg_we_0c          ),
            .D          ( dbg_di[b]          ),
            .Q          ( brk_r4[b]          )
         );
`ifdef SIX_BREAK
         sky130_fd_sc_hd__dlrtp_1   brk_r5_latch
         (
      `ifdef USE_POWER_PINS
            .VPWR(VPWR),
            .VGND(VGND),
            .VPB(VPWR),
            .VNB(VGND),
      `endif
            .RESET_B    ( rst_n              ),
            .GATE       ( dbg_we_0d          ),
            .D          ( dbg_di[b]          ),
            .Q          ( brk_r5[b]          )
         );
`endif
      end
   endgenerate

   /*
   ================================================================
   Logic to test for PC match break
   ================================================================
   */
   assign brk_r[0] = brk_r0;
   assign brk_r[1] = brk_r1;
   assign brk_r[2] = brk_r2;
   assign brk_r[3] = brk_r3;
   assign brk_r[4] = brk_r4;
`ifdef SIX_BREAK
   assign brk_r[5] = brk_r5;
`endif
   always @*
   begin
      brk_halt = 1'b0;
      for (i = 0; i < DBG_BRKPOINTS; i = i + 1)
      begin
         if (brk_r[i][PC_BITS])
            brk_halt = brk_halt | (brk_r[i][PC_BITS-1:0] == pc);
      end
   end
   
   assign cont   = dbg_we && dbg_a == 8'h0 && |dbg_di[2:1] && ~cont_q_r;
   assign cont_q = cont_q_r | step_r | skip_r;            // a brk passes as a nop during these
   assign stop   = !step_r && (halted | (brk_halt && !skip_r)) && !cont;
   assign d_addr   = d_addr_r[D_BITS-1:0];
   assign d_periph = d_addr_r[D_BITS];

   assign d_bits = D_BITS;
   assign pc_bits = PC_BITS;

   always @*
   begin
      dbg_do = 16'h0;
      if (dbg_a[7:4] == 4'h0)
      begin
         case (dbg_a)
         0:    dbg_do = { d_bits, pc_bits, 7'h0, halted };
         1:    dbg_do = { 1'b0, amode, cond, cflag, zflag, acc };
         2:    dbg_do = { {(16-PC_BITS){1'b0}}, pc };
         3:    dbg_do = { {(16-D_BITS){1'b0}},  sp };
         4:    dbg_do = { {(16-PC_BITS){1'b0}}, ra };
         5:    dbg_do = { {(16-PC_BITS){1'b0}}, ix };
         6:    dbg_do = { 8'h0, d_i };
         7:    dbg_do = d_addr_r;
         15:   dbg_do = inst;
         default:
            if (dbg_a[3])
               dbg_do = brk_r[dbg_a[2:0]];
         endcase
      end
      else if (dbg_a[7:4] == 4'h3)
      begin
         case (dbg_a)
         0:    dbg_do = f0;
         1:    dbg_do = f1;
         2:    dbg_do = f2;
         3:    dbg_do = f3;
         4:    dbg_do = facc;
         default: dbg_do = 16'h0;
         endcase
      end
   end

endmodule
