kdp1965/ttsky26c-um-lisa-ttlc/(commit log)

2026-10-16 LISA revision 2: the TT07 tt_um_lisa RTL (tt07-um-lisa-ttlc 0d69ac8) set up for ttsky26c - src/, docs/, test/, the RAM32 DFFRAM macro and the local OpenLane flow copied (not the TT07 gds/lef/pnl outp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
2026-10-16 The verification harness - test/: the chip-level testbench runs real programs (a Python debugger class over the testbench UART: the rXX/wXXYYYY/v/t/l protocol, the Commander's register setup, the fla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
2026-10-16 The fixes, with the tests that showed each: data cache bit 14 from cache_map[2] (cache14); a read-modify-write's d_we raised only once the read is done, d_ok (test_cachermw on the write-first RAM32);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
2026-10-16 The TTLC (items 12, 13) and the documentation: the testbench's 74HC595 / 74HC165 chain models and test_ttlc (the loopback program at 0x10000 behind hello: 48 inputs back on the 48 outputs for seven p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
2026-10-16 CI: synth.yaml runs Yosys synthesis and its check pass on every push (what the hardening flow stops on); gds.yaml by hand - the standard flow with the RAM synthesized fills the 8x2 tile to ~90% and d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
2026-10-16 A 4x4 tile (682.64 x 511.36 um; the TT07 chip was an 8x2, 1378.16 x 225.76): info.yaml, and the local macro flow's die, floorplan template (tt/tech/sky130A/def) and a starting RAM32 location at the r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
2026-10-16 harden/: a local LibreLane flow in the pattern of DFFRAM.librelane's tile trial - configure.py builds config_merged.json as tt-support-tools' --create-user-config does (the sources, the tile's die ar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
2026-10-16 harden/status.py (from ihp-um-janestreet-prism's tools/drt_status.py): where the run is - the steps done with their durations and the current step's log tail, then the detailed router's iterations an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
2026-10-16 src/lisa.sdc: the constraints - LibreLane's base.sdc plus the core's multi-cycle paths from PC to PC, IX, RA, IA and the BF16 accumulator (3 clocks: the pre-decode and decode states lie between), as 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
2026-10-16 harden: the two flows no longer share config_merged.json; legalizer displacement 300 um for the pocket beside the macro
    `make standard` and `make macro` run at the same time wrote the same
    config_merged.json, so a pair of runs both got the macro's configuration
    (the "standard" one only lacked the stripe step). The macro flow writes
    config_merged_macro.json now.
    The macro flow failed detailed placement after the post-CTS resizer on a
    few cells at the bottom-left, as the earlier runs had: the short rows beside
    the RAM32 macro (y < 146 um, x < 265 um) are ~90% full after CTS against 76%
    elsewhere, the resizer's hold buffers push some rows over, and the
    legalizer's 100 um vertical limit is less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
2026-10-16 Synthesis with the _1 cells: src/no_synth.cells, 229K -> 178K um2
    The design is TT07's size (hierarchical Yosys: 184.6K against 192.4K um2,
    the growth being the two UART receive FIFOs and the new fadd), yet LibreLane
    synthesized it to 229K and both flows sat near 80% utilization before any
    repair, failing legalization after the resizers. The cause is the PDK's
    no_synth.cells for the version LibreLane pins: 199 entries that keep
    synthesis off nearly every _1 logic cell and flop, so everything maps to _2;
    TT07's OpenLane 2 build on the 2024 PDK used the _1 cells (its layout
    netlist is 24K _1 cells of 35K). The ABC script is not the cause (plain abc,
    &nf and the AREA 1 script all give ~183K wit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
2026-10-16 harden: room for the post-placement buffers - GPL_CELL_PADDING 2 in the macro flow; the standard flow does not route on the 4x4 tile
    With the _1 cells both flows reached the detailed router and stalled there:
    the standard flow's global route needs 128% of the met1-met4 resources
    (144% at density 70) and diverged to 1.5M violations, the macro flow's was
    at 74% but the router sat at 20K violations after 12 iterations. Binning
    the macro flow's DRC report against its placement (30 um bins) put 86% of
    the violations in bins over 75% full and the worst at 92-98%, mostly met1
    shorts the size of a via landing. Lowering the target density (85 -> 68)
    changed nothing (46 against 48 bins over 90%): glob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
2026-10-16 harden: a routed, DRC- and LVS-clean 4x4 build (runs/macro-fix6) and the recipe that reproduces it - EXTRA_EXCLUDED_CELLS keeps the resizer off the sky130 delay cells (it took clkdlybuf4s25_1 as its 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
2026-10-16 gds, lef, pnl: the macro-fix6 build for gds_custom.yaml - 4x4 tile, RAM32 DFFRAM macro, routed clean (24 iterations in 4 passes), Magic DRC 0, LVS clean, antenna clean, IR drop 0.6 mV, hold met at ev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
2026-10-16 harden: complete pdngen's cut power stripes so every power port box reaches both tile edges - Tiny Tapeout's precheck rejected the first submission's LEF ("Port VGND is too far from bottom edge of mo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
2026-10-16 gds, lef, pnl: the macro-fix7 build for gds_custom.yaml - as fix6 (routed clean, Magic DRC 0, LVS clean, antenna clean, IR drop 0.6 mV, hold met everywhere, setup +5.2 ns nominal) with every power po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
2026-10-16 harden: the smaller AND-OR RAM32 as a trial - odb_stripes.py leaves a cut tile stripe alone (with a warning) when completing it over the macro would touch a macro pin of the other net, trial_ao.json 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
2026-10-16 harden: trial_ao_free.json - the smaller AND-OR RAM32 with no anchor table, the placer's own draw: runs/macro-ao4 signed off (routed clean in 20 iterations, Magic DRC 0, LVS clean, antenna clean, IR 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
2026-10-17 harden: the macro halo trial (ao5) - the RAM32 on the core's bottom row (y 2.72, nothing is routed under it: every tile pin is on the top edge), vertical halo 1 um (cut_rows cuts the overlapping row,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
2026-10-17 Release candidate: the AND-OR RAM32 on the core's bottom row with a 2 x 1 um halo (runs/macro-ao5). macros/ is the DFFRAM.librelane models/ram_ao macro (320.16 x 116.96 um, 31% smaller than the tri-s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
2026-10-17 RESPIN.md: test_bf16's adder checks fixed in lisa-tools (8fd7e53): they asserted the TT07 adder's defects and now probe which adder is there, so the suite's known failures on the chip testbench go fr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
2026-10-17 RESPIN.md: test_divl was the suite runner's silence limit, not an error; the test prints progress now (lisa-tools) and passes with the default limit
2026-10-17 RESPIN.md: item 16, the stack convention (push decrements SP before the write, pop increments after the read: SP at the top byte, 0(sp) the top of a frame). The toolchain side is done (lisa_sim --rev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
2026-10-17 The stack convention (RESPIN.md item 16): push a / sra / push ix write at SP - 1 and SP is decremented as the write completes, pop a / lra / pop ix read at SP and increment after, so SP is the addres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
2026-10-17 Release candidate rc2: the streaming fetch and the stack convention hardened (runs/macro-stream-fo16-hold07). The streaming RTL is 3% bigger than rc1 (144.6k against 140.1k um2 synthesized, 76% utili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
